Creamy-coffee/dual-channel-modulation-analyzer/README.md

# 双通道信号采集与调制分析仪

仪器由两块芯片组成：Artix-7 FPGA 负责双通道 12 位 65 MSPS 同步采集和全部信号处理，RK3506 跑 Linux，用 LVGL 驱动 7 英寸触摸屏。FPGA RTL、屏端源码、串口协议和验证记录都在本仓库。

> 2026 全国大学生嵌入式芯片与系统设计竞赛 · FPGA 创新设计赛道 · AMD 自主选题

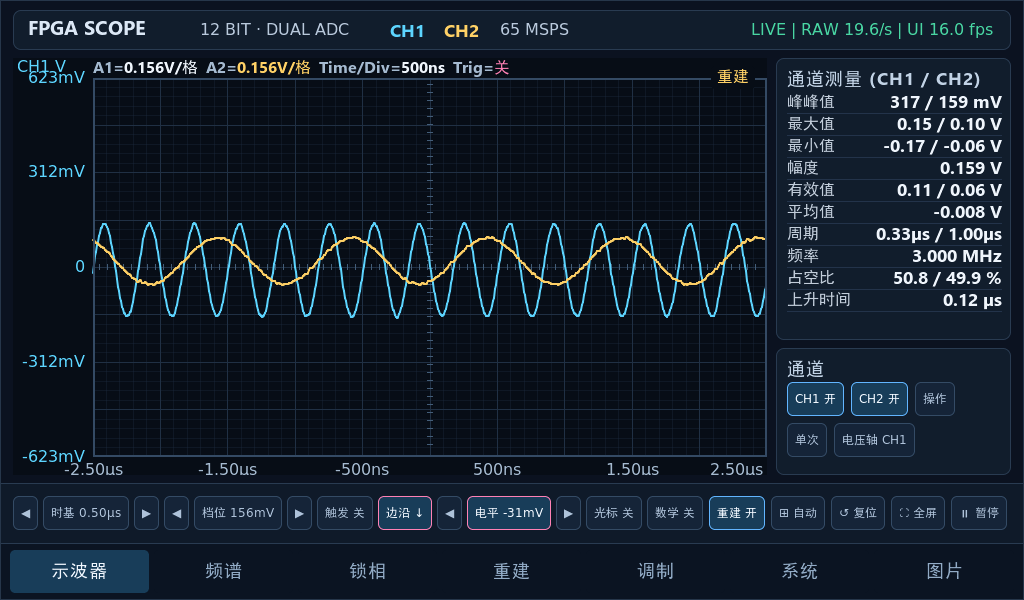
[picture p1: docs/screenshots/01-scope-dual.png]
示波器页：双通道交叉接线，3 MHz 接 CH1、1 MHz 接 CH2，同一时间轴


## 系统组成

信号链是固定的：双通道 12 位 65 MSPS 同步采样 → 多速率抽取 → 4096 点共享 FFT → DDC → 片上频率捕获与锁相 → H1–H5 谐波功率 → CRC32 成帧，全部在 XC7A35T 内完成。屏端把这套结果画成七页界面，并在调制页做 AM 调制度估计和 OOK / 2FSK / BPSK 的符号判决。

界面上的读数总跟有效状态一起给出：锁相页没有激励时显示「—」并置「相位变化超限」，调制页判决没完成时标「待判决」，不留上一帧的数字。

## 七页界面

| 页面 | 内容 |
|---|---|
| 示波器 | 双通道时域波形：时基 / 档位 / 边沿触发 / 单次；通道测量峰峰值、最大值、最小值、有效值、平均值、周期、频率、占空比、上升时间 |
| 频谱 | FPGA SPEC 帧（4096 点共享 FFT，固定 Hann 窗）+ 屏端 RAW 1024 点谱（Hann / Blackman / FlatTop 可切）；中心频率、峰值电平、底噪、Δf、H1–H5 与 THD 2–5 |
| 锁相 | 片上锁相：I/Q 相位矢量与双通道波形同屏；参考频率、幅度、相位差、锁定状态 |
| 重建 | 原始样点 vs 带限插值重建，同一时间窗上下对齐；按波形类型决定是否重建 |
| 调制 | DDC + 包络 / 频偏 / I-Q：AM 调制度、OOK 与 2FSK 的 bit 判决、BPSK 符号跟踪与 I/Q 观测、QPSK 仅 I/Q 观测 |
| 系统 | 渲染帧率、链路吞吐、丢包与 CRC 统计等板载实测值 |
| 图片 | V32IMG1! 载荷：OOK / 2FSK / BPSK 解出的符号 → 曼彻斯特解码 → 分包 CRC32 → 整图 CRC32，全部通过才显示画面；整图链路以合成回环与 ADB 逐像素核验，真实载波下的独立抓包验收未做 |

> 七页屏端程序源码就在本仓库 `src/`。构建额外依赖 `third_party/liquid-dsp-1.7.0.tar.gz`（BPSK 符号跟踪用），配置时校验 SHA 后离线解包，不联网取依赖。版本、bit 哈希与提交号的对应见 [docs/VERSION.md](docs/VERSION.md)。

## FPGA 侧

目标器件 XC7A35T FGG484-2（Artix-7 35T），Vivado 2018.3 综合实现。FFT、DDC、锁相与谐波计算均以本仓库 RTL 实现，未例化厂商 FFT IP；时钟与 I/O 使用器件原语（MMCM、BUFG 等）。系统时钟 65 MHz（50 MHz 板载晶振经 MMCM ×39 ÷2 ÷15 生成；另一路 300° 相移作 ADC 前传时钟，对应 65 MSPS）。

| 能力 | 怎么做的 | 源码 |
|---|---|---|
| 双通道 12 位 65 MSPS 同步采集 | AD9238 两路在同一采样沿锁存，偏移二进制转二补码；两通道同一帧，不分时切换 | `fpga/rtl/ad9238_capture.v` |
| 4096 点共享 FFT | 时分复用 radix-2 DIT 蝶形，每级右移 1 位（总归一化 1/N）；多通道串行复用同一套旋转因子表，只搜 1…N/2；旋转因子为预生成表 `twiddle_4096.mem` | `fpga/rtl/fft_frame_4ch.v`、`fpga/rtl/twiddle_4096.mem` |
| 多速率抽取前端 | CIC + 可换系数 FIR（wide / narrow 多套 `.mem`），按信号稳定性自动换档 | `fpga/rtl/multirate_fft_frontend.v`、`fpga/rtl/meas_bw_ctrl.v` |
| DDC 数字下变频 | NCO 混频（Q15 sin/cos 表）+ CIC / FIR 抽取，AM、2FSK、BPSK、OOK 的基带都从这里出 | `fpga/rtl/ddc_nco_mixer.v`、`fpga/rtl/ddc_cic_decimator.v`、`fpga/rtl/ddc_fir_decimator.v` |
| 片上频率捕获 + 锁相 | 「FFT 粗估 → 精扫 → 锁定」三段式，一份 bitstream 扫完 ~200 Hz…32.4 MHz（搜索范围，边界未做标定），换载频不用重编 | `fpga/rtl/freq_scan_ctrl.v`、`fpga/rtl/local_afc_2ch.v`、`fpga/rtl/lockin_core_2ch.v` |
| 谐波与 THD | H1–H5 功率存表、log2 表转 dB、64 位整数开方算 THD 2–5 | `fpga/rtl/harmonic_power_store.v`、`fpga/rtl/isqrt_u64.v` |
| 成帧与链路 | 多路帧并行仲裁 + AB5 时序 + 逐帧 CRC32，2 Mbaud 8N1 发出 | `fpga/rtl/parallel_frame_arbiter.v`、`fpga/rtl/ab5_frame_sequencer.v`、`fpga/rtl/v32cap3_tx.v` |

资源与时序（`fpga/build_evidence/` 是原机报告，实现 ID `a222905e`，Routed 状态）

| 资源 | 占用 |
|---|---|
| Total LUTs | 20294（Logic 20238 + LUTRAM 56） |
| 触发器 | 13111 |
| DSP48 | 80（蝶形、混频、CIC 累加） |
| Block RAM | 32×RAMB36 + 8×RAMB18，36 块等效（样点缓存、旋转因子、系数表、波形 LUT） |
| 时序 | WNS +0.172 ns、WHS +0.010 ns，无 setup / hold 违例 |

构建：`fpga/build.tcl` 提供完整构建脚本（Vivado 批处理建工程 → 综合 → 实现 → 出 bit）。
2026-11-02 已在仓库外的独立副本上用同一套 Vivado 2018.3 跑通全流程：WNS +0.172 ns / WHS +0.010 ns
（0 个失败端点）、20294 LUT / 13111 FF / 80 DSP / 36 BRAM、DRC 138 条全为 Warning 无 Error，
与 `fpga/build_evidence/` 逐项一致。bit 的 SHA256 不会相同——Vivado 把构建时间写进 bit 头，
一致性应按 USR_ACCESS + 时序/资源 + 上板功能判定。过程见
[build-verify-20261102.md](docs/build-verify-20261102.md)。

## 调制制式与判决

各制式在屏上的显示能力和判决能力不一样，分开列：

| 制式 | 屏端显示 | 符号 / bit 判决 | 实机验证 |
|---|---|---|---|
| AM | 包络 + 调制度（正弦拟合） | 不适用（模拟调制） | 2 MHz 载波、1 kHz 调制、深度 50 % → 屏上 50.0 % |
| FM / PM | 相位差换算频偏 / 相位 | 不适用（模拟调制） | 未单独做实机记录 |
| OOK | 包络（Q8 模长） | ● 已实现：10/90 分位学高低电平，40 %／60 % 滞回定边沿，符号中心积分判 1/0；不确定记 `?`，不强制猜 bit | 1 MHz 载波、1000 Bd、曼彻斯特、256×128 图像包流 |
| 2FSK | 相位差换算频偏 | ● 已实现：与 OOK 共用定时与滞回核心，低频 = 0、高频 = 1（频偏正负本身不能判 bit） | 1 MHz 载波、1000 Bd、相对频偏 1525.0 Hz |
| BPSK | 原始 I/Q 轨迹；可选恢复符号点（`SYM` / `RAW IQ` 切换，未获资格时清图，不拿原始散点冒充星座） | ● 已实现：Hann 窗 M 次方 4096 点 FFT 估粗 CFO → `msresamp` 重采样到 4Rs → `symtrack` 做 AGC / 符号定时 / 载波跟踪 / 均衡 → 判决；可选 PN7 参考检查 | 实机 PN7 闭环（2026-10-27）：372 帧 CRC 全对、5747 bit、训练后 5460 次检查 0 错、GUI 24.2463 s 合格片段末次 24702 次检查零错、EVM 0.0260–0.0481；更早一次 `11-mod-bpsk.png` 是 EVM 0.060 待判决，属未获符号同步的失败运行 |
| QPSK | 仅 I/Q 观测 | ○ 未实现：屏端只暴露 I/Q 观测，主机侧符号恢复未移植过来 | 无屏端记录 |

几点说明：

1. 判决都在已知符号率下进行：屏上人工选 100 / 250 / 500 / 1000 / 2000 Bd，没有自动制式识别，也没有自动码率估计。
2. `?` 是不确定，不是 0 或 1：弱信噪比、缺帧、无效样点都记为 `?`。含 `?` 的记录不能当完整连续码流，也不能用来算 BER。
3. EVM 是获取资格判据，不是通信标准 EVM 仪表：它只用来判断「这 64 个符号够不够格报同步」，没有按任何标准校准。PN7 检查也不是 BER，需要源端确实发 PN7 才有意义。

## 性能与速率

采样率、链路帧率和绘制帧率是三个不同的量：

| 项目 | 数值 | 条件 / 来源 |
|---|---|---|
| ADC 采样率 | 65 MSPS × 2 通道，12 位，同一采样沿 | 硬件（AD9238 + FPGA 采集） |
| 有效采样率（抽取后） | 65 MSPS ÷ decimation，dec 取 1…32768 的 2 的幂 | 接收端支持范围，见"已知边界" |
| 串口链路 | 2 Mbaud 8N1，RAW 帧 4140 B / SPEC 帧 2096 B，逐帧 CRC32 | 协议 |
| 接收帧率 | 屏上实测约 19.6 帧/s（RAW 页面右上角 `LIVE RAW 19.6/s`） | 发布版本，2 Mbaud |
| 面板刷新 | 1024×600 @ 49 Hz | DRM 模式（PREFERRED） |
| 绘制帧率 | 约 9.9 FPS（六页版本，1024 点折线 × 2 通道） | 早期版本实测，七页版本未复测 |

65 MSPS 是 ADC 的采样率，不是送到 Linux 的样点速率。串口按帧发送：RAW 波形帧（1024 点，4140 B）、
SPEC 频谱帧（2096 B）、MEAS 测量帧（128 B）、ANA 调制帧（1076 B）、DDC 参数帧（72 B），
每帧独立 CRC32；两帧之间的样点不上传，所以"接收帧率 19.6 帧/s"与"采样率 65 MSPS"不是一回事。

## 验证与证据

每条结论后面记了输入条件、结果，以及这个结论能覆盖到哪一步。

| 证据 | 输入条件 | 结果 | 结论范围 |
|---|---|---|---|
| `01-scope-dual.png` | 发生器 CH1 3 MHz/300 mVpp → 分析仪 CH1；CH2 1 MHz/150 mVpp → CH2；500 ns/div | 峰峰值 317 / 159 mV，频率 3.000 / 1.000 MHz | 双通道同帧采集与通道测量可用；不含幅值精度标定 |
| `02-scope-2mhz.png` | 2.000 MHz / 200 mVpp 正弦 | CH2 峰值 212 mV | 单通道实时响应 |
| `03/04/05-fft-*.png` | 2.000 MHz / 200 mVpp；RAW 1024 点；分别 Hann / Blackman / FlatTop | 峰值 −33.9 / −33.9 / −33.8 dBFS，底噪 −91.8 / −91.2 / −86.5 dBFS | 窗函数切换与峰值一致性（极差 0.1 dB）；不是绝对幅度校准 |
| `06-fft-harmonic.png` | 2 MHz 方波 / 200 mVpp，HARM ON | 峰值 −31.8 dBFS，THD 2–5 = 38.441 % | 相对功率统计；未做失真溯源校准 |
| `07-lock.png` / `08-lock-open.png` | CH1/CH2 同接 2 MHz 正弦，发生器相位差 45° | −45.15°、锁定；关掉一路后数值转「—」、状态「相位变化超限」 | 相位差测量与失效提示有效；不含绝对相位标定 |
| `09-mod-am.png` | 2 MHz 载波、1 kHz 调制、深度 50 % | 调制度 50.0 %，包络峰峰 12 码 | 调制度估计（正弦拟合）在指定条件下成立 |
| `10-mod-2fsk.png` / `12-mod-ook.png` | 1 MHz 载波、1000 Bd | 2FSK 频偏 1525.0 Hz、bit 同步；OOK bit 同步、bits 序列 | 指定码率下的符号同步；未做全码率 / 全信噪比统计 |
| `11-mod-bpsk.png` | 1 MHz 载波、1000 Bd，人工指定 Rs | EVM 0.060、CFO +132 Hz，状态「待判决」 | 早期一次运行：观测量与获取资格判据有效，但该次未获符号同步，不能当作判决成功（后续已闭环，见下一行） |
| BPSK 实机闭环（2026-10-27） | 发生器 CH2 → ADC CH0 → 屏端 CH1；1 MHz 载波、1000 bit/s、PN7、0°/180° | 372 个 ANA 帧 CRC 全对、帧号 10665–11036 连续、覆盖 6.001 s；ARM 导出 5747 bit；训练后 5460 次检查 0 错；GUI 独立审计 24.2463 s 合格片段、末次 24702 次参考检查零错零擦除；EVM 0.0260–0.0481 | 指定码率下的实机判决闭环；不是通用 BER、协议帧同步或绝对极性；180° 极性歧义需外部参考 |
| [bpsk-bit-decoder-20261026.md](docs/bpsk-bit-decoder-20261026.md) 的离线用例 | 合成基带，两种相位极性、80 Hz 载波偏差 | 符号恢复与 PN7 检查通过 | 解码链路在本机软件成立；合成基带不等于发生器→ADC→屏幕实机链路 |
| [image-receiver-20261027.md](docs/image-receiver-20261027.md) 本机软件验证 | OOK / 2FSK / BPSK 生产 DSP → 曼彻斯特 → 包 CRC → 图块 → 整图 CRC | 全链通过 | 协议与解码链正确；尚无语发器→ADC→屏幕的整机图片传输记录 |
| `fpga/tests/` RTL 仿真 | tb_adc_parallel、local_afc_2ch、meas_bw_ctrl、fft_frame_4ch 等 | Vivado 时序波形 | 数字逻辑功能正确性；不含模拟前端与板级噪声 |
| `fpga/build_evidence/*.rpt` | 实现 `a222905e` | 20294 LUT / 80 DSP / WNS +0.172 ns | 该次实现的资源与时序；换代码或换工具版本需重测 |
| [build-verify-20261102.md](docs/build-verify-20261102.md) 屏端重建 | 仓库外独立副本；LVGL 9.1.0 + liquid-dsp 1.7.0（SHA256 与 `third_party/liquid.cmake` 一致）| LVGL 284 / 应用 21 个源文件全部编译通过，链接得到 `ELF32 ARM v7-A VFPv4 hard-float`，2,258,844 B；5 个命令行工具同样构建成功 | 源码自洽可编译；编译器是 GCC 7.3.1，不是正式工具链，且未上板 |
| 主机自测（同一份源码）| `test_bpsk_decoder` / `test_ook_decoder` / `test_fsk_decoder` / `test_fft_windows` / `test_fft` | 全部 PASS：BPSK 12 例各恢复 3778–3780 bit、PN7 全锁、`errors=0`、EVM 0.0277–0.0338 | 算法与解码链在软件层成立；合成基带不等于实机链路 |

每帧 CRC32 通过只说明这一帧完整到达，不说明幅度、相位或调制度准确，所以最后一列单独写了结论范围。

## 快速开始

### 交叉编译（Linux 主机，ARMv7 hard-float）

```bash
# 依赖：cmake、ARM 交叉工具链、同级目录下的 LVGL 源码
export SDK_TOOLCHAIN_ROOT=/path/to/gcc-arm-10.3-2021.07-x86_64-arm-none-linux-gnueabihf
./build.sh            # 增量编译
CLEAN=1 ./build.sh    # 全量重编
```

`build.sh` 用 `toolchain.cmake` 交叉编译。工具链根目录从 `SDK_TOOLCHAIN_ROOT` 环境变量取（或 `cmake -DTC_ROOT=`），仓库里不写死任何人的本机路径；LVGL 目录可用 `LVGL_DIR=` 覆盖（默认 `../lvgl-release-v9.1`）。
BPSK 解码链另需 `third_party/liquid-dsp-1.7.0.tar.gz`：`third_party/liquid.cmake` 在配置阶段校验 SHA256 后离线解包并静态链接，不从网络取依赖。除 GUI 外还会构建 `bpsk_capture_decode`、`test_bpsk_decoder`、`test_raw_capture` 三个命令行工具（离线回放与自测用）。

### 部署到板子

```bash
./deploy.sh                 # 通过 adb 推送并运行

export BOARD_HOST=192.168.1.10 BOARD_USER=root BOARD_PASS=你的口令
./deploy_net.sh             # 或走网络：推送 → 校验 md5 → 一致后才覆盖 → 重启
```

地址、账号、口令请按你们自己的板子环境配置。`deploy_net.sh` 与 `tools/board_shot.py`
从 `BOARD_HOST` / `BOARD_USER` / `BOARD_PASS` 环境变量读取，仓库不记录任何默认口令；
未设置时会直接报错退出，不会悄悄用空口令去连。

### 运行

```bash
waveform_demo --source uart          # 真实串口数据（默认 2 Mbaud 8N1）
waveform_demo --source demo          # 无板子时用合成信号看界面
```

## 已知边界

### 使用条件

- 板端需 root 运行（读 `/dev/input/event0` 注入触摸、直接写 DRM）。
- 单 connector / 单屏；官方 `lv_demo` 必须先停，否则会抢 DRM 与输入设备。
- 中文字体是界面字符的子集，改文案需重跑 `tools/gen_v32_fonts.py`，否则新字是方块。

### 测量边界

- 未做精密幅相与失真校准：H1–H5、THD 只在指定输入下做过功能测试，不是可溯源的失真测量。
- 串口带宽是硬约束：2 Mbaud 下每帧 RAW 4140 B / SPEC 2096 B，帧率由帧长决定；提高帧率要减帧长或提速。
- 抽取换时间窗，代价是带宽：有效采样率 = 65 MSPS ÷ decimation，奈奎斯特随之下降到 65 MHz ÷ (2·dec)。接收端接受 1…32768 的 2 的幂，但能接受不等于板上验证过——深抽取档目前只为 AM 包络用过，低频极限未系统标定。
- 帧与帧不连续：相邻两帧 `start_idx` 实测相差约 1.17×10⁷ 个样点（一帧才 4096），两帧之间丢掉了约 99.96 % 的采样，不能拼接。
- 带限重建不消除混叠：只对带限信号成立；超过 32.5 MHz 的成分已经折叠进带内，插值无法还原；窗口边缘前后各 64 个样点没有完整支撑，自动退回线性插值。对非带限波形（方波 / 三角 / 锯齿）重建时必须钳位，钳位会改变波形形状。

## 版本与复现

`main` 上同时有 FPGA 源码与屏端源码，但两者不是"一次提交全部对齐"：实现 ID、bit 哈希、屏端程序所在分支与提交、工具版本、已知差异，全部记在 [docs/VERSION.md](docs/VERSION.md)。提交参赛材料时以该文件为准。

## 团队成员

| GitHub | 主要负责 |
|---|---|
| [@Creamy-coffee](https://github.com/Creamy-coffee) | RK3506 板端应用：DRM/KMS 渲染、触摸输入、串口链路接收与带限重建 |
| [@YiHuan15](https://github.com/YiHuan15) | FPGA RTL 与数字信号处理：双通道采集、FFT、锁相、谐波分析 |

## 文档索引

| 文档 | 内容 |
|---|---|
| [docs/VERSION.md](docs/VERSION.md) | 参赛版本清单：实现 ID、bit 哈希、屏端程序、工具版本、已知差异 |
| [docs/build-verify-20261102.md](docs/build-verify-20261102.md) | 干净环境重建验收：环境、命令、屏端产物、FPGA 时序/资源/DRC 对比、未覆盖项 |
| [docs/DEVELOPMENT.md](docs/DEVELOPMENT.md) | 开发记录：无 framebuffer 怎么点屏、触摸与协议细节、参数调整、排错工具 |
| [fpga/README.md](fpga/README.md) | FPGA 工程结构、构建方法、接口与边界 |
| [docs/V32CAP3_FPGA_TX_SPEC.md](docs/V32CAP3_FPGA_TX_SPEC.md) | 上位机协议与帧格式 |
| [docs/ook-bit-decoder-20261026.md](docs/ook-bit-decoder-20261026.md) / [fsk](docs/fsk-bit-decoder-20261026.md) / [bpsk](docs/bpsk-bit-decoder-20261026.md) | 三种制式的判决算法、参数、适用条件与不可宣称的结论 |
| [docs/bpsk-acquisition-capture-20261027.md](docs/bpsk-acquisition-capture-20261027.md) | BPSK 真实采集回放与获取判据 |
| [docs/image-receiver-20261027.md](docs/image-receiver-20261027.md) | V32IMG1! 载荷协议、分包与整图 CRC 验收流程 |
| [docs/spectrum-resolution-20261029.md](docs/spectrum-resolution-20261029.md) / [geometry](docs/spectrum-geometry-20261029.md) / [harmonic-confidence](docs/harmonic-confidence-20261029.md) | 频谱分辨率、几何与谐波置信度的核对记录 |
| [docs/screenshots/](docs/screenshots/) | 13 张发布版本实屏截图（1024×600） |

## 许可证

项目自身代码采用 GNU GPL v3.0（GPL-3.0-only），详见 [LICENSE](LICENSE) 与 [许可范围说明](LICENSING.md)。

第三方组件：LVGL v9.1（MIT，需自行获取源码，仓库不分发）；Xilinx Vivado 2018.3 为厂商工具，不随仓库分发。其余第三方归属见 `LICENSING.md`。
