Creamy-coffee/dual-channel-modulation-analyzer/docs/llm-assisted-optimization-log.md

> **文档性质**：本文是 2026-10-19 ～ 10-31 期间的阶段记录，描述当时的分支（含 8192 点 XFFT 链路、
> AI_V32 构建、低速 CNN 实验等）。当前仓库的发布版本是七页屏端 + 4096 点共享 FFT 那条路径，
> 两者**不是同一条实现线**；版本对应关系以 [VERSION.md](VERSION.md) 为准，本文不作为当前能力声明。
>
> 文中指向证据文档的路径已改为「私有证据 / 私有记录」形式——那些文件未随本仓库分发。

---

# LLM 辅助优化记录（2026-10-27补充；保留历史修订）

> 阅读提示：前部表格为10月19日历史状态；10月23日补充见第七节，10月27日最新补充及验证边界见第八节。

赛事：全国大学生嵌入式芯片与系统设计竞赛 · FPGA创新设计赛道（赛事名称沿用初稿，正式要求以主办方通知为准）。

项目：基于XC7A35T-FGG484-2与AD9238的双通道信号分析仪；每路12位、65MSPS并行SDR采样，分支包含FFT、时域测量、全速数字锁相、低速共享CNN实验及波形/状态通信。

工具链：Vivado 2018.3、Verilog/SystemVerilog验证、Xilinx XFFT IP、Python；新增Linux显示与通信交接方案。

修订说明：最初稿停留在2026-10-10；本轮编辑期间原文件另有#35～#44等并发补充，已全部保留并合并。本次保留前序#1～#44，新增#45～#64以及现状、资源口径、证据和待办。写入前已完整备份最新输入。早期Prompt为还原要点，新增Prompt为工程复盘归纳，均不冒充原始聊天逐字记录。

验证口径：分别标识数学分析、RTL仿真、综合/实现、原始采样回读、用户板卡阶段实验、Linux离线原型及未来规划。本次只做文档修订与证据核对，未重跑训练、仿真、综合、硬件或Linux屏幕测试。

## 修订后的项目状态速览

| 组成 | 已有证据 | 仍未完成或不能宣称 |
|---|---|---|
| 双路ADC | 每路65MSPS采集逻辑、码型/OTR/复位仿真、已保存RAW现场数据 | ADC输入电气裕量、模拟抗混叠、连接器电压及两路频响完整校准 |
| FFT/测量 | 8192点XFFT链路及算术修复；4096/8192子系统对照、另有4096 finder候选 | 整带宽未知弱信号可靠捕获、1Hz绝对精度与完整THD认证 |
| 基础锁相/AFC | 30MHz附近局部跟踪、源设置20mVpp、恢复及±1kHz回程阶段板测 | 非绝对幅相精度；约0.9～1°幅度相关相移待定位；整带宽候选另验 |
| CNN | 双路共享低速推理、R256、256输入/232有效点、功能/吞吐验证及多轮合成训练 | 质量未全面通过；模型资格0、AUTO为RAW；无全速宽带AI认证 |
| AI_V32构建 | 10/18源码迁移后时序回归已修复；10/19增加独立V32CAP3口并出bit | 工程能出bit不等于模拟/板级整机认证，新口Linux接收尚需实机验证 |
| 通信 | 历史SPI审计；V32CAP3真实归档50帧核对；AB5二进制/AB6文本独立口候选 | SPI RAW4096扩展尚未实现；UART无双向参数命令，不能连续上传65MSPS |
| Linux/屏幕 | 真实RAW快照离线HTML原型、串口解析参考和SPI设计草案 | 最新交接为RK3506/UART，早期方案为RK3568/MIPI；板卡/屏驱动及实时部署未验收 |
| 自动搜索/ET | 有独立候选、仿真与构建记录，新增完整性审查正在形成 | 200Hz～32.4MHz是设计目标；ET覆盖/相位标签及板测未完整闭环 |

**当前可据证据表述：已形成数字采集—测量—原始数据导出的分层实现，并在基础候选上获得30MHz局部弱信号跟踪的阶段板测；AI质量、绝对校准和Linux整机屏显仍有明确未完成项。**

## 一、前序闭环记录（#1～#44，含本轮检测到的并发补充）

以下保留当时的问题与回答，不把其中的估算、旧规格或“综合通过”提升为今天的系统验收。关键错误已就地加注；后续状态以第二部分及来源索引为准。#6与#18为同类除法器依赖事件的两次历史归纳，保留编号但不重复计算为两个独立优化成果。前序#35～#44与新补充部分有交叉，保留其错误判断与纠正细节，同一事件不重复计为独立成果。

### 记录 #1　isqrt_u64 端口名错误导致综合失败
- 日期/阶段：2026-10-07 · THD 模块重构
- 问题：THD 分析器引入 64bit 整数开方（isqrt_u64，32 拍恢复开方）后，综合报 6× Synth 8-448: named port connection 'value'/'valid' does not exist for instance 'u_isqrt'，RTL Elaboration 失败。原因是例化时把端口写成 .value()/.valid()，而模块实际端口为 radicand/result/busy/done。
- Prompt（还原要点）："THD 模块综合报 named port connection 'value' does not exist for instance 'u_isqrt'，isqrt_u64 的端口名是什么？怎么改？"
- 模型回答（要点）：指出 isqrt_u64 实际端口为 clk/rst_n/start/radicand[63:0]/result[31:0]/busy/done，例化应为 .radicand(sqrt_input) / .done(sqrt_valid)；并提示此类错误属于端口名笔误，应先在模块定义处核对端口清单再例化。
- 验证：改后重跑综合，thd_analyzer 模块 0 Errors 通过（12:01 综合日志）。
- 纠错点：例化 IP/自研模块前先核对端口名；综合报 "named port connection does not exist" 时不要怀疑语法，直接查目标模块端口定义。
### 记录 #2　插值频率位宽缺陷（14bit 左移归零 + 32bit 乘法溢出）
- 日期/阶段：2026-10-07 · FFT 频率插值
- 问题：三点插值频率公式 (($signed({1'b0,final_bin_hold})<<<16)+delta_q16)*ADC_FS_HZ>>>... 中，14bit 左操作数做 <<<16 后结果仍是 14bit（高位被截断归零），且后续 32bit 乘法溢出，导致 interp_freq_packed 输出垃圾值——会拖垮 UI 频率显示、自动测试判频和锁相 FCW 三个下游模块。
- Prompt（还原要点）："插值频率算出来是错的，怀疑是位宽问题：bin<<16 之后乘 Fs 会溢出，怎么改成正确的定点链？"
- 模型回答（要点）：给出固定位宽链：① bin_q16 = k*65536 + delta 用 32bit 有符号；② 符号扩展为 64bit（{{32{interp_bin_q16[31]}}, interp_bin_q16}）；③ freq_product = interp_ext * ADC_FS_HZ_64（64×64）；④ freq_result = freq_product >>> (16+LOG2_N+DECIM_LOG2)（算术右移 29）；⑤ 取 [31:0]。并强调 delta 用组合限幅值而非寄存器值，避免使用上一拍陈旧数据。
- 验证：数学复核成立：(k+δ)×Fs/2^LOG2_N，8192 点下最大频率 32.5MHz 不溢出；新版综合通过，代码注释标注 "V6: properly sign-extended interpolation result"。
- 纠错点：Verilog 中 <<< 不自动扩位——移位前先按最终位宽符号扩展；定点乘法先算好最大动态范围再定位宽，避免 32bit 溢出被静默截断。
### 记录 #3　THD 组合除法 + 全展开开方导致面积爆炸（place 失败）
- 日期/阶段：2026-10-06 · THD 模块
- 问题：THD 用组合逻辑 64bit 除法 + 全展开 64bit 开方，综合后 THD 模块约 15883 LUT，Place 失败。
- Prompt（还原要点）："THD 模块面积 15883 LUT 太大，place 过不了，怎么降面积？"
- 模型回答（要点）：组合除法/开方在 FPGA 上面积巨大，改为多周期迭代方案：恢复除法 64 拍（thd_divider_64，共享）+ 恢复开方 32 拍（isqrt_u64），用状态机（ST_DIV → ST_SQRT → ST_DONE）串行计算；FFT 一帧周期约 126μs，参数计算完全不必单周期完成，多周期对吞吐无影响。
- 验证：旧版副本工程重写后 synth → impl → write_bitstream 全部通过；整体 LUT 15000/20800（含 FFT 等全部逻辑）；新版 v6.1 继续沿用该方案，综合 0 Errors。
- 纠错点：FPGA 上"一个周期算完除法/开方"是面积杀手；凡一帧才更新一次的参数计算都应改为多周期状态机 + 共享运算单元。
### 记录 #4　THD 近似开方方案数值不可信（leading-one 近似不成立）
- 日期/阶段：2026-10-07 · THD 模块
- 问题：早期 THD 用 leading-one 位近似计算 psum/p1 的平方根比例，抽查发现数学不成立：shift=3 时结果为 0（真值 16）、shift=4 时结果为 64（真值 16）、shift=7 时结果为 1（真值 2）——仅 psum 最高位恰好为 27 时碰巧正确，数值不可信。
- Prompt（还原要点）："THD 用 leading-one 近似算出来的比值是错的（给了几个反例），这个近似能不能成立？"
- 模型回答（要点）：承认近似不成立，改回精确公式 THD_x100 = sqrt(psum * 1e8 / p1)（(10000)²=1e8 的缩放技巧）：64/64 多周期除法得 psum×1e8/p1，再经 32 拍 isqrt 开方；量纲验证：失真 100% 时输出 10000，正常信号 <1000。
- 验证：v6.1 公式与位宽推导写入头部注释（36×27=63bit 乘积不溢出 64bit 除法）；综合通过。
- 纠错点：数值算法上线前必须用边界反例验证（0/64/大数）；近似公式要给出误差界，给不出就换精确实现——"碰巧正确"和"数学正确"要分清。
### 记录 #5　THD 四项边界保护（谐波越界 / DC / 除零 / ±1 bin）
- 日期/阶段：2026-10-06 · THD 模块
- 问题：THD 谐波累积存在越界与除零风险：基波太靠近 Nyquist 时第 5 次谐波 5k±1 超出 FFT 半谱范围仍会访问；基波为 DC（bin≤1）或基波功率为 0 时公式无意义。
- Prompt（还原要点）："THD 上线前要加哪些边界保护？谐波越界、DC、除零分别怎么挡？"
- 模型回答（要点）：给出四项保护：① fund_bin*5+1 <= HALF_N（5 次谐波越界 → THD invalid）；② fund_bin >= 2（排除 DC）；③ 基波功率 p1 != 0（防除零）；④ 谐波窗口 spectrum_bin+1 >= k && spectrum_bin <= k+1（3-bin 窗且 k 越界时不访问）；无效通道输出 0xFFFF 哨兵。
- 验证：四项条件保留至 v6.1（ok_hold 逻辑），综合通过；0xFFFF 哨兵被 auto_tester 的 thd_ok 正确判失败。
- 纠错点：频谱算法上线前先枚举索引越界/除零/空输入三类故障；用哨兵值（0xFFFF）统一表达"无效"，下游判 valid 而非判数值。
### 记录 #6　fixed_divider 依赖旧 FFT 文件导致模块 not found
- 日期/阶段：2026-10-07 · 数字锁相
- 问题：工程重构时把旧自研 FFT（fft_frame_4ch.v）从综合范围排除（UsedIn=simulation），但 digital_lock_in 的 FCW 除法器仍例化其中的 fixed_divider，综合报 Synth 8-439: module 'fixed_divider' not found。
- Prompt（还原要点）："digital_lock_in 报 fixed_divider not found，但它明明定义在 fft_frame_4ch.v 里？"
- 模型回答（要点）：定位根因：fft_frame_4ch.v 已被排除出综合（.xpr 里 UsedIn=simulation），其内部模块对综合不可见；解法是把除法器抽成独立文件 fixed_divider_generic.v（并补除零保护：denominator==0 输出全 1 + valid），THD/插值/锁相统一复用，不依赖旧文件。
- 验证：独立文件加入工程后综合通过；14:32 write_bitstream 成功出位流。
- 纠错点：公共模块（除法器/计数器）必须独立成文件，不要寄生在"即将淘汰"的模块里；从工程排除旧文件前先 grep 谁还在引用它。
### 记录 #7　headless 顶层 IOB 超用（609/250 = 243%）
- 日期/阶段：2026-10-07 · 顶层架构
- 问题：早期 headless 顶层把内部显示总线（ui_numbers 406bit、spec_pair 66bit、wave_samples 48bit 等）全部暴露为端口，无引脚约束时全部计入 IOB，达 609/250=243.6%，实现必然失败。
- Prompt（还原要点）："综合过了但 IOB 609 超用 243%，怎么让内部总线不占引脚？"
- 模型回答（要点）：物理顶层（daq_top）只保留真实板级 I/O（clk/adc/digital/key/sw/uart/led），内部总线全部收进 daq_display_core；用自由运行扫描计数器（512×512 + frame_boundary）驱动 CDC mailbox 占位读接口，未来 MIPI renderer 再替换。
- 验证：新版综合 IOB 24/250=9.6%，实现通过，14:32 出位流。
- 纠错点：区分"物理端口"与"内部数据总线"；凡是将来由显示/协议后端消费的总线一律不进顶层端口，用内部握手或 mailbox 传递。
### 记录 #8　相位差：双通道各找峰值导致 bin 错位
- 日期/阶段：2026-10-07 · 相位测量
- 问题：双通道各自独立找 peak bin 时，噪声可能让 CH0 peak=126、CH1 peak=127，此时两通道在不同频率点取相位，相位差无意义。
- Prompt（还原要点）："两通道各找各的峰值，噪声下 bin 错一位相位差就不对了，怎么处理？"
- 模型回答（要点）：改用公共基波 bin：以 CH0 峰值 bin 为公共 fundamental bin，CH1 在同一个 k 上读取复数（ref_ch1_re/im），双通道同频点 atan2 求差；并补 ±180000 mdeg 归一化（>+180° → -360°、<-180° → +360°，33bit 中间量防溢出）；V7 再加 low-signal 有效性门控（相位功率低于噪声底时 invalid）。
- 验证：xfft_frame_2ch 增加 is_ref_bin 捕获逻辑；phase_measurement 输出经 wrap 后 ∈[-180000,+180000]；综合通过。
- 纠错点：相位测量必须在同一频率点比较；先对齐 bin，再谈相位；测量类算法要配"信号太弱时输出无效"的门控，而不是硬给数值。
### 记录 #9　插值 δ 无限幅导致无意义频率
- 日期/阶段：2026-10-07 · 频率插值
- 问题：三点插值公式 δ=0.5·(Pk-1-Pk+1)/(Pk-1-2Pk+Pk+1) 在异常谱线下可能得到 δ=3.7 这类越界值，导致频率结果无意义。
- Prompt（还原要点）："插值 δ 异常大怎么办？要不要限幅？"
- 模型回答（要点）：对 δ 做 ±0.5 bin 限幅：Q16 定点下 delta_clamped 限制在 ±32768（±0.5）；同时除法器对负数做了符号处理（分子/分母取绝对值 + 符号位恢复），限幅用组合逻辑直接由除法结果算出，避免陈旧寄存器。
- 验证：V6 插值链中 delta_clamped 生效，freq_result 输出稳定；综合通过。
- 纠错点：抛物线插值的前提是"峰值确实在邻域内"；越界 δ 直接说明峰值搜索或谱线异常，限幅是兜底不是掩盖——还要同时看峰值搜索是否可靠。
### 记录 #10　自动测试阈值硬编码 → 寄存器化
- 日期/阶段：2026-10-07 · 自动测试
- 问题：早期自动测试用 if (thd < 500) pass=1 式硬编码阈值，改一次指标就要重新综合。
- Prompt（还原要点）："自动测试的阈值能不能不写死？以后用按键/UART 改。"
- 模型回答（要点）：阈值全部改为输入端口：freq_min/max_hz、vpp_min/max、thd_max_x100、phase_min/max_mdeg；ok 判定组合化后打拍（连续评估 + 锁存），update 脉冲采样最新测量结果；顶层以参数默认值接线。
- 验证：auto_tester 阈值端口化，daq_top 以 32'd100~32'd30000000 等常量例化；综合通过。
- 纠错点：测试判定逻辑与阈值解耦——阈值是"配置"不是"代码"；未来 UART/按键改阈值不需重综合，答辩时可以直接演示在线改判据。
### 记录 #11　HDMI 时钟域时序违例 → headless 去 HDMI 域（WNS 对比）
- 日期/阶段：2026-10-06 → 10-07 · 架构迭代
- 问题：旧 HDMI 版实现后时序违例严重：pix_unbuf WNS=-51.760ns、sys_unbuf=-5.477ns、adc_fwd=-2.843ns——HDMI 像素时钟域与系统域交叉、约束不完整是主因。
- Prompt（还原要点）："旧版时序 WNS -51ns 太差，切 MIPI 前怎么把时序收干净？"
- 模型回答（要点）：MIPI 未做前先 headless：移除 HDMI 像素域与显示扫描逻辑，显示总线收进内部、用 50M 参考扫描；只保留 sys(65M) 与 adc 接口两个域，缩小时序分析范围；adc 输入延迟按 AD9238 tPD + PCB skew 估算（往返 6.5~11.5ns），板测后再校准。
- 验证：新版实现后 Setup 0 Failing、WNS +3.255ns，Hold +0.044ns，write_bitstream 成功。
- 纠错点：时序收敛要先砍"没必要的时钟域"再谈约束；HDMI 像素域在显示后端未定稿前不应进入实现；I/O delay 必须结合器件手册与 PCB 走线，不能凭感觉。
### 记录 #12　Hann 窗接口位宽适配与 BRAM 开销评估

> 【后续纠正】“Hann最大增益0.5”和“锁相加窗必然不适用”不能作为通用结论。实际截位需按系数缩放、输入范围和舍入策略核对；后续全速锁相实例已启用Hann，必须验证有限窗增益、相位与积分条件。保留下面回答作为早期建议，不作为当前规格。

- 日期/阶段：2026-10-07 · V7 创新包集成
- 问题：新增 Hann 窗（8192 点 Q15 系数 ROM）输出 16bit，但 xfft_frame_2ch 输入样例为 12bit，直接级联位宽不匹配；系数 ROM 资源占用需评估。
- Prompt（还原要点）："Hann 窗 16bit 输出怎么接 xfft_frame_2ch 的 12bit 输入？BRAM 够不够？"
- 模型回答（要点）：位宽适配取低 12bit（Hann 最大增益 0.5，12bit 满幅输入后输出约 11bit 有效，截到 12bit 不溢出，且避免了 `[15:4]` 截高位的错误做法）；Hann 只加在 FFT 链路上，时域 Vpp/RMS/锁相继续用原始采样（锁相是时域相干检测，加窗破坏正交性）；ROM 用半窗对称可优化到 4096 个系数（8192/2）。
- 验证：hann_window_2ch.v 接入 daq_processing_core，位宽适配为 `hann_ch0_out[11:0]`；综合后 BRAM 增量约 1~2 个 RAMB36 等效（远低于预估的 4 个）。
- 纠错点：窗函数输出位宽与下游输入位宽契约必须对齐；不要凭直觉截高位或截低位，先算最大增益再定位宽截取位置。

### 记录 #13　digital_capture_buffer BRAM 推断失败（set/reset 同优先级）
- 日期/阶段：2026-10-07 · 数字通道缓存
- 问题：V6 版本 digital_capture_buffer 把 RAM 写逻辑放在带异步复位的 always 块里（`if (!rst_n) ... else if (we) mem[addr] <= data`），Vivado 报 Synth 8-5788 "Register mem_reg has both Set and reset with same priority"，随后 Synth 8-4767 "Trying to implement RAM in registers"——RAM 被溶解成约 4096 个 FF，BRAM 推断完全失败。
- Prompt（还原要点）："digital_capture_buffer 的 mem_reg 报 set/reset same priority，然后 Trying to implement RAM in registers，怎么让它推 BRAM？"
- 模型回答（要点）：Block RAM 的内容本身不支持异步复位——一旦在 always 块里写了 `if (!rst_n)` 赋值给 mem 数组，Vivado 就必须用寄存器实现。正确写法是把 RAM 写口拆到独立的、只有 posedge、没有 reset 的 always 块；只复位 wr_addr、rd_addr、bank、valid、req/ack 等控制寄存器。
- 验证：拆分后综合日志出现 "Detected attribute (* ram_style = "block" *)"，4×512 数字缓存推成 BRAM，节省约 4000 FF。
- 纠错点：写 BRAM 推断代码时，RAM 数组的赋值必须在**纯同步、无复位**的 always 块里；复位只能作用于控制逻辑。这是 FPGA BRAM 推断的铁则。

### 记录 #14　digital_capture_buffer ACK CDC 只有一级同步器
- 日期/阶段：2026-10-07 · 数字通道缓存
- 问题：写侧（sys_clk 65MHz）同步读侧 ack 信号只用了 1 级触发器（`wr_ack_sync <= rd_ack`），而读侧同步写侧 req 用了 2 级，CDC 不对称有亚稳态风险。
- Prompt（还原要点）："digital buffer 的 wr_ack_sync 只有一级 FF，rd_req_sync 有两级，是不是要补上？"
- 模型回答（要点）：跨时钟域信号必须至少 2 级同步器；两边对称都加 `(* ASYNC_REG = "TRUE" *)` 标记；写侧改成 `wr_ack_sync[1:0]` 移位寄存器，判断用 `wr_ack_sync[1]`。
- 验证：修改后 CDC 结构对称，综合不再报相关警告。
- 纠错点：跨时钟域握手信号（req/ack）两侧都必须有 ≥2 级同步器，不能只做一边；ASYNC_REG 属性帮助 Vivado 识别同步器并做正确的布局约束。

### 记录 #15　clk_50m 非法连接（IBUF + 内部负载同时驱动）
- 日期/阶段：2026-10-07 · headless 顶层
- 问题：daq_top 中 display_clk 直接 assign 为 clk_50m（顶层输入端口），而 clk_50m 同时也接进了 MMCM 的 IBUF。Vivado 报 Synth 8-5535 "port clk_50m has illegal connections. It is illegal to have a port connected to an input buffer and other components"——同一个端口不能同时驱动 IBUF 和普通寄存器时钟。
- Prompt（还原要点）："综合报 clk_50m has illegal connections，IBUF 和内部负载冲突，怎么改？"
- 模型回答（要点）：Xilinx 7 系列顶层输入时钟必须经 IBUF 后才能驱动内部逻辑；display_clk 不应使用未缓冲的 clk_50m。改用 MMCM 输出的 `clk_sys`（65MHz，已经在 BUFG 上）作为 display 域时钟，既避免 IBUF 冲突，又与系统域同频同相（消除 display 与 sys 之间的 CDC 复杂度）。
- 验证：修改后 Synth 8-5535 错误消失，综合通过。display 域与 sys 域同频后，wave/spectrum/digital buffer 的 CDC 仍然保留（接口标准不变），但实际路径更简单。
- 纠错点：7 系列 FPGA 的输入时钟必须走 IBUF → BUFG 路径；内部逻辑不能直接挂在顶层时钟输入端口上；display 时钟优先复用已有 BUFG 时钟，避免额外的时钟域和 CDC 开销。

### 记录 #16　THD 谐波和位宽不足（34bit 不够装 4 个 34bit 之和）
- 日期/阶段：2026-10-07 · THD 模块 v6.1
- 问题：thd_analyzer 中 psum = h2+h3+h4+h5，每个 hp 是 34bit，直觉认为和也是 34bit，但实际 4 个 34bit 数相加最大需要 34+log2(4)=36bit；同时缩放乘积也存在位宽截断风险（先零扩展到 64bit 再乘，导致 64×27=91bit 截成 64bit）。
- Prompt（还原要点）："4 个 34bit 的谐波功率相加，和是不是 34bit？会不会溢出？缩放乘积呢？"
- 模型回答（要点）：明确扩展：`psum_full = {2'b00, h2} + {2'b00, h3} + {2'b00, h4} + {2'b00, h5}`（36bit）；缩放常数限制为 27bit（100,000,000 < 2^27）；36 × 27 = 63bit 乘积，1bit 零扩展后 64bit 正好进除法器；不要用 `{30'd0, psum}` 先零扩展到 64bit 再乘——那样是 64×27=91bit 会截高 27bit。
- 验证：位宽推导链写入模块头部注释（34→36→×27→63→64）；综合无位宽截断警告。
- 纠错点：多个数相加的位宽 = 最大操作数位宽 + log2(操作数个数)；定点乘法先算两边位宽再定结果位宽，不要靠隐式推导；关键计算链的位宽必须在代码头部注释里写清楚推导过程。

### 记录 #17　THD 状态机重构：先锁存再计算，消除 unused 警告
- 日期/阶段：2026-10-07 · THD 模块 v6.1
- 问题：早期 THD 在 fft_valid 当拍直接读取 hp 累加器启动除法器，导致 p1_hold_ch0 / psum_hold_ch0 / ok_hold_ch0 三个寄存器从未被读取，综合报 Synth 8-6014 "Unused sequential element p1_hold_ch0_reg was removed"；同时 CH0 和 CH1 的计算路径不一致（CH0 直接用累加器值，CH1 用 hold 寄存器）。
- Prompt（还原要点）："p1_hold_ch0 报 unused，怎么让 hold 寄存器真正用上并且两个通道路径一致？"
- 模型回答（要点）：增加 ST_LATCH 状态，fft_valid 时只做锁存（把所有 hp 写入 hold 寄存器），下一拍再从 hold 寄存器取值启动除法器。状态机扩展为 7 态：ST_ACCUM → ST_CH0_START → ST_CH0_DIV → ST_CH0_SQRT → ST_CH1_START → ST_CH1_DIV → ST_CH1_SQRT。同时 CH2/CH3 THD 固定为 16'hFFFF（无效标记），避免下游误判为 "THD=0%"。
- 验证：p1_hold/psum_hold/ok_hold 全部被使用，unused 警告消失；两通道计算路径完全对称；CH2/CH3 输出 FFFF 哨兵。
- 纠错点：组合数据路径和时序数据路径要分层——"捕获 → 锁存 → 计算"三步曲比"捕获+计算混合"更清晰，也更容易避免 set/reset 同优先级问题。

### 记录 #18　fixed_divider 寄生在旧 FFT 文件 → 独立为公共模块
- 日期/阶段：2026-10-07 · 工程结构清理
- 问题：工程重构时把旧自研 FFT（fft_frame_4ch.v）从综合范围排除，但 digital_lock_in 的 FCW 除法器仍例化其中的 fixed_divider，综合报 Synth 8-439: module 'fixed_divider' not found。
- Prompt（还原要点）："digital_lock_in 报 fixed_divider not found，但它明明定义在 fft_frame_4ch.v 里？"
- 模型回答（要点）：定位根因：fft_frame_4ch.v 已被排除出综合，其内部模块对综合不可见；解法是把除法器抽成独立文件 fixed_divider_generic.v（参数化 NUM_W/DEN_W，补除零保护：denominator==0 输出全 1 + valid），THD/插值/锁相统一复用，不依赖旧文件。xfft_frame_2ch 内的 fixed_divider_xfft 同步删除，改用公共模块。
- 验证：独立文件加入工程后综合通过；多个调用点共享同一个 divider 实现。
- 纠错点：公共模块（除法器/计数器/FIFO）必须独立成文件，不要寄生在"即将淘汰"的模块里；从工程排除旧文件前先 grep 谁还在引用它。

### 记录 #19　V7 创新包全量集成（Hann / 相位门控 / Lock-in v2 / UART / SPI / 统计）
- 日期/阶段：2026-10-07 · V7 创新包集成
- 问题：V7 创新包包含 6 个新模块（hann_window_2ch、phase_valid_gate、digital_lock_in_v2、uart_rx_decoder、spi_mode0_decoder、auto_test_stats），需要全部接入现有信号链并保证不破坏已有功能。
- Prompt（还原要点）："把 V7 创新包里的 6 个模块全部集成到现有工程里，分别接在哪里？"
- 模型回答（要点）：
  - hann_window_2ch：接在 XFFT 前（FFT 链路加窗，时域/锁相不加）
  - phase_valid_gate：接在相位测量输出后（基波功率低于噪声底时输出 invalid）
  - digital_lock_in_v2：替换 v1（频率平滑 + 运行时可配置积分长度 + FCW 边界保护），acc_log2 固定为 4'd10（1024 点）
  - uart_rx_decoder：接数字通道 D0（115200 8-N-1，协议观察）
  - spi_mode0_decoder：接数字通道 D0=SCLK/D1=MOSI/D2=MISO/D3=CS_n（SPI Mode 0 协议观察）
  - auto_test_stats：接 auto_tester 输出（总次数/通过次数/失败次数统计）
- 验证：待综合（记录待补充实测数据）。
- 纠错点：批量集成前先画信号流图，明确每个新模块的上游来源和下游去向；协议解码器属于"观察型"模块，不影响主测量链路时序。

### 记录 #20　竞赛项目含金量评估与创新方向选择

> 【证据边界】以下评分为当时主观讨论，未依据正式评审结果，不作为赛事成绩或客观完成度。

- 日期/阶段：2026-10-07 · 竞赛策略与创新点论证
- 问题：当前"示波器+频谱仪"类项目在 MAD FPGA 赛道同质化严重，需要评估现有项目的竞争力，并选择有差异化的创新方向。
- Prompt（还原要点）："目前这个项目能进决赛吗？怎么优化？结合时事发展有什么创新方向？"
- 模型回答（要点）：
  - 当前评分约 59/100（系统复杂度75 / 技术深度65 / 完成度55 / 创新性50 / 应用价值70 / 展示效果40），进决赛有风险
  - 最大短板：示波器类项目泛滥差异化不足 + 无板级实测 + 无直观显示界面
  - 分析 6 个创新方向：TinyML信号分类、侧信道分析、RISC-V软核、软件定义无线电、生物医学ECG、数字孪生自校准
  - 推荐"AI自适应降噪 + 语音控制"组合，但需避免"简单波形分类"这种花架子
  - 最终方向定为：面向测量保真的轻量化 1D CNN 信号增强 + 数字锁相联合弱信号检测
- 验证：方向已确定，待进入实施阶段。
- 纠错点：竞赛项目的创新不能是"加个AI功能"，而要让AI成为仪器核心能力的一部分；技术深度 + 展示效果 + 实测数据三者缺一不可。

### 记录 #21　初版 CNN 计算量严重低估（漏乘输入通道数，差 5 倍）
- 日期/阶段：2026-10-07 · AI增强/弱信号检测架构论证
- 问题：TinyDenoiser-v1 (Encoder-Decoder) 初估约 69,632 MAC/256点，但 Conv2、Conv3、DeConv 漏乘输入通道数 Cin。正确公式为 MAC = Lout × Cout × Cin × K。
- Prompt（还原要点）："CNN 的 MAC 数是 Lout×Cout×K 还是要乘 Cin？我之前算的 70K 对不对？"
- 模型回答（要点）：按完整公式重算：Conv1=18,432；Conv2=81,920；Conv3=98,304；DeConv=131,072；ConvOut=18,432，总计 348,160 MAC/256点，约为初版估算的 5 倍。8 MAC/cycle 需约 43,520 cycle ≈ 669.5μs @65MHz。
- 验证：256 个 65MSPS 样本仅约 3.94μs，因此该结构处理时间约为输入窗口时间的 170 倍，绝对不能作为 65MSPS 连续实时前级。
- 纠错点：CNN 吞吐估算必须包含输入通道数 Cin，公式是 Lout×Cout×Cin×K；RTL 固化前必须逐层建立 MAC/存储/带宽预算表，不能只算最外层。

### 记录 #22　帧式 CNN 不能直接喂给 65MHz Lock-in / 8192 点 FFT
- 日期/阶段：2026-10-07 · CNN+数字锁相联合架构
- 问题：256 点 CNN 非连续帧输出若直接送 Lock-in 或拼成 8192 点 FFT，会破坏真实采样时间轴——锁相要求 x[n]·sin/cos(ωn) 的 n 是连续采样时刻，FFT 也要求连续且采样率定义明确的数据。
- Prompt（还原要点）："CNN 输出是一帧一帧的，能直接送给锁相放大器吗？时间关系对不对？"
- 模型回答（要点）：不对。抽帧 CNN 不存在连续 65MSPS 增强输出，out_valid 不等于可按原采样率解释。若按当前 669μs/帧的处理速度，处理期间 ADC 已产生约 170 个新窗口，数据时间轴完全错位。结论：CNN 不能直接作为 65MHz 锁相/FFT 的前级。
- 验证：时间推算成立（669.5μs / 3.94μs ≈ 170×）。
- 纠错点：AI 输出接测量算法前必须保持采样时间轴连续；out_valid 脉冲不等于可按原采样率解释的连续数据流；级联前先画时间轴。

### 记录 #23　AI 支路降采样到 ~1MHz，RAW 高速链完整保留

> 【后续更新】本条÷64/约1MSPS为早期预算；后续双路共享CNN采用CIC3/16＋FIR/16、R256、每路253906.25SPS，见#46。不能用早期单窗理论时间证明双路65MSPS实时AI。

- 日期/阶段：2026-10-07 · V8 架构规划
- 问题：65MSPS 直接 CNN 吞吐不足，而抽帧又无法形成严格连续测量链。
- 模型回答（要点）：采用双域架构——高速 RAW 域 65MHz 保留 Vpp/RMS/Mean、波形、Hann+XFFT、RAW Lock-in（保真度最高的原始测量链）；AI 域先做抗混叠低通，再 ÷64 到约 1.015625 MSPS，运行 Tiny 1D CNN 及 AI Lock-in/分析。两条链并行，结果通过四模式 MUX 选择输出。
- 验证：256 点在 1.015625 MSPS 下约 252μs；若用全分辨率 depthwise 网络（约 90K MAC）+ 8 MAC 阵列，处理时间约 173μs，有 45% 余量，可实现 AI 域内的连续实时处理。
- 纠错点：必须满足 MAC/s ≥ sample_rate × MAC/sample；降采样前必须抗混叠；各算法链必须使用自己正确的有效采样率，不能混用。

### 记录 #24　测量保真 CNN：取消 stride/deconv，改用全分辨率残差噪声预测
- 日期/阶段：2026-10-07 · TinyMP-Denoiser 结构优化
- 问题：stride=2 编码 + 转置卷积（Encoder-Decoder 结构）可能改变时间位置、高频细节、相位和谐波，不利于测量仪器的"保真"要求。
- Prompt（还原要点）："面向测量保真的 CNN，网络结构应该怎么选？stride 和 deconv 会不会破坏相位和谐波？"
- 模型回答（要点）：仪器 AI 不能只追求"波形看起来更干净"。推荐全分辨率残差 1D CNN，网络预测噪声 n_hat[n] = CNN(x[n])，输出 s_hat[n] = x[n] - n_hat[n]（原始信号直通，CNN 只学噪声）。中间用 depthwise + pointwise 卷积降低计算量（普通 16→16 K=5 每点 1280 MAC，depthwise+pointwise 仅 336 MAC，减少 3.8 倍）。损失函数也应多目标：L = L_wave + 0.2×L_FFT + 0.1×L_amp，确保频谱和幅度也保真。
- 验证：待 Python 训练后以 ΔSNR、幅度误差、频率误差、相位误差、THD 误差联合验证，再固化 RTL。
- 纠错点：仪器 AI 不能只追求波形视觉效果；网络结构和损失函数必须围绕测量量保真设计；"测量保真"是区别于普通去噪的核心。

### 记录 #25　CNN 权重存储位数误判：2KB 权重不等于 2000 FF
- 日期/阶段：2026-10-07 · CNN FPGA 资源预算
- 问题：初版估算 2064 个 INT8 权重约需 2000 个 FF。
- Prompt（还原要点）："2KB 权重用 FF 存的话大概需要多少个 FF？2000 个够吗？"
- 模型回答（要点）：2064 × 8 = 16,512 bit，若逐位用 FF 约需 16,512 个 FF（不是 2000）。正确方案是用 LUTRAM（Distributed ROM）或 BRAM。TinyMP-Denoiser 仅 352 字节权重（~2,816 bit），用约 100 个 LUT 即可实现，零 BRAM 消耗。
- 验证：位宽计算成立（参数量 × 位宽 = 总 bit 数），最终资源以 Vivado placed report 为准。
- 纠错点：参数个数与存储 bit 数必须区分；INT8 参数的 FF 成本不是"一个参数一个 FF"；权重优先用 ROM/LUTRAM 而不是 FF。

### 记录 #26　CNN/锁相增益不能预设固定 dB 数，改为板级实验指标
- 日期/阶段：2026-10-07 · 创新点表述与验证
- 问题：早期方案示意写了 "CNN 提升 10~20dB、锁相再提升 20~30dB、最终 +30~40dB"，但尚无训练或板测支撑。
- Prompt（还原要点）："方案里写 CNN+锁相总共提升 30-40dB，这样写会不会不严谨？"
- 模型回答（要点）：会。这些只能作为目标，不能写成已实现指标。CNN 增益依赖训练集和噪声类型；锁相处理增益受积分长度、频偏、ADC ENOB、时钟和相位噪声等多种因素影响。正确做法是建立 RAW / CNN / RAW Lock-in / CNN+Lock-in 四模式对照实验，实测统计 ΔSNR、E_A、E_f、E_φ、E_THD，用数据说话。
- 验证：后续板级 A/B 实验后补充实测数据。
- 纠错点：设计目标和实测指标必须分开；竞赛材料中的 dB、精度和灵敏度提升必须有测试数据支撑，不能凭直觉写。

### 记录 #27　Hann 窗 ROM 半窗对称优化（8192 → 4097 系数，省约 2 RAMB18）
- 日期/阶段：2026-10-07 · Hann 窗优化
- 问题：Hann 系数 ROM 存完整 8192 × 16bit = 131,072 bit ≈ 7.1 RAMB18 ≈ 3.6 RAMB36 等效。BRAM 是当前最紧的资源（约 68% 已用），需要尽可能节省。
- Prompt（还原要点）："Hann 窗能不能用半窗对称减少 BRAM？w[n] = w[N-1-n] 对吗？"
- 模型回答（要点）：Hann 窗满足 w[n] = w[N-1-n]（关于 N/2 镜像对称），因此只需存前 N/2+1 = 4097 个系数（含中点最大值）。读地址 n ≤ N/2 时直接读；n > N/2 时读 N-1-n（镜像地址）。ROM 容量减半（4097 × 16 = 65,552 bit ≈ 3.6 RAMB18 ≈ 1.8 RAMB36），节省约 2 个 RAMB18。用 generate + HALF_WINDOW_OPT 参数控制，保留全窗回退选项。Q15 量化下镜像对（如 n=100 / n=8091）仅 1 LSB 舍入差异，完全可接受。
- 验证：Python 生成 4097 个半窗系数并验证对称性（w[0]=0, w[4096]=32767, 镜像对差异 ≤ 1 LSB）；RTL 用 generate 块实现地址镜像逻辑，功能与全窗等价。
- 纠错点：对称窗函数（Hann/Hamming/Blackman）都可以用半窗对称减少 ROM；BRAM 紧张时优先做这种"零功能损失"的存储优化，再考虑降位宽等有损优化。

### 记录 #28　AI 支路 64 倍抽取器：用 Boxcar 累加器替代 FIR，零 DSP 实现抗混叠

> 【结论更正】下文“Boxcar抗混叠对AI完全足够、CNN天然鲁棒”没有充分验证，已撤回为通用结论。boxcar只有有限低通，不能作为全频保真抗混叠；后续AI采用专用CIC/FIR，显示平均和测量抽取分开，见#46、#52、#61。

- 日期/阶段：2026-10-08 · AI 支路基础设施
- 问题：AI 支路需要从 65MSPS 降采样到 ~1MSPS（÷64），常规 FIR 需要多个 DSP48 做乘累加，资源紧张。
- Prompt（还原要点）："AI 支路 ÷64 抽取，能不能不用 FIR？Boxcar 滑动平均性能够不够？资源多少？"
- 模型回答（要点）：Boxcar（矩形窗滑动平均）等效于系数全为 1 的 FIR，用累加器实现完全不需要乘法器——N 点平均只需一个加法器 + 一个计数器，资源几乎为零。抗混叠性能方面，第一旁瓣 -13dB，对 AI 去噪预处理完全足够（CNN 本身对带外泄漏有鲁棒性）；若后续需要更好阻带可再级联 CIC 或半带。最终采用 analysis_decimator_4ch（Boxcar 结构，LOG2_D=6 → 64 倍抽取，输出约 1.015625 MSPS），4 通道并行仅用 ~200 个 FF。
- 验证：RTL 实现后 xvlog 编译通过；Boxcar 直流增益为 1，无幅度溢出；输出速率 = 65MHz/64 ≈ 1.015625 MHz，与 CNN 单帧处理时间 173μs 匹配（45% 余量）。
- 纠错点：抽取滤波器不一定非要用 FIR；对于 AI 预处理等对阻带衰减要求不高的场景，Boxcar/滑动平均是"零 DSP、极低资源"的最优解；先评估最低配方案是否满足需求，再逐级升级。

### 记录 #29　帧对齐缓冲区设计：4 槽位状态机 + FWFT 输出，解决 Raw/CNN 帧速不对齐

> 【历史结构】四槽位frame_align_buffer是当时版本，不代表当前双路共享CNN调度结构；当前窗口、epoch/故障和物理相位对齐应按#46对应版本验证。

- 日期/阶段：2026-10-08 · AI 系统集成
- 问题：Raw 帧 252μs/帧（~3967 fps），CNN 处理 173μs/帧，两者速率不同且相位错位，直接拼接会导致同一 frame_id 的 Raw 和 CNN 数据错位。
- Prompt（还原要点）："Raw 和 CNN 是两条并行支路，帧速率不一样，怎么按 frame_id 配对输出？需要 FIFO 吗？"
- 模型回答（要点）：用帧对齐缓冲区（frame_align_buffer），4 个槽位的状态机结构，每个槽位存 {Raw 数据 + CNN 数据 + valid 标志 + frame_id}。Raw 先到写槽位，CNN 后到匹配同 frame_id 槽位，两者都齐了槽位就绪。输出用 FWFT（First-Word Fall-Through）模式，就绪数据直接加载到输出寄存器。同时支持：① 同时到达（同拍 Raw+CNN 同 frame_id）直接进就绪；② 前向写入（缓冲区满时恰好消费一个，新数据直接写入刚释放的槽位，无气泡）；③ 超时回退（某帧只有 Raw 没有 CNN，超时后强制输出 Raw 兜底）。
- 验证：xsim 测试 7/7 场景 PASS（同速、CNN 慢、CNN 快、同时到达、前向写入、超时回退、溢出保护）；端到端融合测试全部通过。
- 纠错点：两条速率不同的并行支路不能直接"对齐输出"，必须用缓冲+匹配机制；FWFT 比普通 FIFO 更适合帧级数据（整帧就绪后直接输出，无需读使能预热）；超时兜底是 fail-soft 设计的关键——宁可输出 Raw 也不能卡住下游。

### 记录 #30　CNN 幅值校准 LUT：5 级流水线 + fail-closed 安全机制

> 【资格边界】数字幅值LUT不等于模拟电压/相位校准完成，默认无效与回退是保护，不是模型质量证书。

- 日期/阶段：2026-10-08 · AI 测量保真
- 问题：CNN 去噪后幅值会有系统性偏差（网络学到的增益不一定是 1.0），直接送测量链路会导致 Vpp/RMS/THD 全部偏移。
- Prompt（还原要点）："CNN 输出幅值不准怎么办？能不能做个校准？怎么保证校准失效时不输出错误结果？"
- 模型回答（要点）：分 bin 做 LUT 校准——按输入幅值分 256 档，每档存一个增益修正系数（INT16 Q12 格式），5 级流水线完成读取+乘法+截断。关键是 fail-closed 安全机制：① 所有 LUT 初始化为 0（无效）；② 校准系数通过 UART/寄存器逐 bin 写入；③ 某 bin 未写入时输出幅值强制为 0 + valid=0，下游自动判为无效；④ 整表未完成前不输出有效数据。这样保证"校准不完整=不输出假数据"，而不是用默认 1.0 增益蒙混过关。
- 验证：RTL 实现后集成通过；fail-closed 机制在 branch_decision 中被正确识别（calibration_valid=0 时拒绝选 CNN）。
- 纠错点：校准模块必须 fail-closed 而不是 fail-open；默认值应该是"无效"而不是"增益 1.0"；下游判决模块必须检查校准有效标志，不能假设校准永远正确。

### 记录 #31　三模式判决分支：保守 AUTO 模式，宁可不用 CNN 也不让坏结果出去

> 【结论更正】RAW/CNN残差或“差得很少”不能证明CNN更好，也不是有干净真值的SNR。后续资格位仍为0，AUTO保持RAW，见#47；此处逻辑仅是历史门控设计。

- 日期/阶段：2026-10-08 · AI 系统集成
- 问题：AUTO 模式下如何决定用 Raw 还是 CNN？简单阈值会导致边界附近频繁跳变，且可能在 CNN 效果不好时反而选 CNN。
- Prompt（还原要点）："AUTO 模式怎么选 Raw 还是 CNN？有哪些判断条件？怎么保证不选错？"
- 模型回答（要点）：保守策略——6 个条件全部满足才选 CNN，任一不满足就回退 Raw：① calibration_valid（校准有效）；② amp_diff < THRESHOLD（幅值差不超过阈值，说明 CNN 没有把幅值改太多）；③ phase_diff < THRESHOLD（相位偏移可控）；④ snr_estimate > MIN_SNR（信噪比足够高，CNN 才有提升空间）；⑤ cnn_frame_valid（CNN 帧有效且未溢出）；⑥ frame_match（Raw/CNN 帧对齐成功）。理由：仪器的第一原则是"不给出错误结果"，AUTO 模式应该是"确定 CNN 更好才用"，而不是"可能更好就试试"。
- 验证：branch_decision 三模式（RAW_ONLY / CNN_ONLY / AUTO）实现；AUTO 模式下 6 条件全为与逻辑，任一不满足即选 Raw；status[3:0] 输出可观测每一步拒绝原因。
- 纠错点：仪器类 AI 的 AUTO 模式必须保守——"宁可不用，也不用错"；判决条件要可观测（每一位对应一个失败原因），方便调试；Raw 永远是安全兜底。

### 记录 #32　共享 CORDIC 时分复用：双支路幅相转换只实例化一个 CORDIC

> 【历史资源估计】“约200+LUT”“零性能损失”为当时估计，具体共享结构是否保留、吞吐和资源以对应实现报告为准。

- 日期/阶段：2026-10-08 · AI 系统集成
- 问题：Raw 和 CNN 两条支路都需要 CORDIC 做幅相转换，各实例化一个会浪费一个 CORDIC（约 200+ LUT）。
- Prompt（还原要点）："两条支路都要 CORDIC 求幅相，能不能共享一个？时分复用怎么调度？"
- 模型回答（要点）：可以共享。用状态机时分复用：① Raw 帧到来 → 启动 CORDIC → 存 Raw 结果；② 等 CNN 帧就绪 → 再启动同一个 CORDIC → 存 CNN 结果；③ 两者都完成后联合输出。关键是处理 pending 缓冲和 overrun 检测：若新 Raw 来的时候 CORDIC 还在处理上一组，丢帧并置 overrun 标志。CORDIC 16 次迭代约 16 周期，相对于 252μs 帧周期完全可以忽略，时分复用不影响吞吐。
- 验证：ai_dual_lockin_fusion 共享单 CORDIC 实现；xsim 测试 7/7 场景 PASS（正常、pending、overrun、同时到达、顺序颠倒等）。
- 纠错点：低速多通道共享高速运算单元是 FPGA 设计的常用手法；只要运算时间远小于数据到达间隔，时分复用就是零代价的；一定要有 overrun 检测，否则调度错误会被静默掩盖。

### 记录 #33　数字锁相 v2 设计：参考频率 IIR 平滑 + 运行时可配置积分长度 + FCW 边界保护
- 日期/阶段：2026-10-09 · V7→V8 锁相升级
- 问题：v1 锁相参考频率直接跳变，FCW 更新时相位不连续，积分长度固定不灵活。
- Prompt（还原要点）："数字锁相怎么改进？参考频率切换时要平滑过渡，积分长度要能运行时配置。"
- 模型回答（要点）：
  - 参考频率平滑：一阶 IIR 低通 y[n] = y[n-1] + α(x[n]-y[n-1])，α=1/2^N 用右移实现，频率切换时指数收敛，避免相位跳变
  - 运行时可配置积分长度：acc_log2 输入端口，2^acc_log2 点积分，范围 1~4096 可配
  - FCW 边界保护：FCW 只在相干积分块边界更新，不会切断正在进行的积分块，保证每块都用同一个频率
  - 幅值近似：alpha max + beta min 近似（max + min/2），误差约 11.8%，零乘法器
  - CORDIC 相位：复用已有 cordic_atan2，输入截取高 32 位
- 验证：digital_lock_in_v2 实现，xvlog 编译通过；IIR 平滑 + FCW 边界保护功能正确；积分长度可动态切换。
- 纠错点：锁相放大器的参考频率是"慢变量"，用 IIR 平滑比硬切更符合实际信号特性；积分长度决定频率分辨率和 SNR 提升，应该做成可配置而不是固定值；FCW 更新必须和积分块对齐，否则单块内频率不一致会降低增益。

### 记录 #34　AI 锁相 I/Q 探针：双支路共享 NCO + 分时乘法器，零额外 NCO 资源

> 【时间轴边界】RAW与CNN并非无条件“同频同相”；共享参考必须补偿处理时延、滤波群延迟及窗口位置，并以物理采样索引验证，不能只因共享NCO就认定已对齐。

- 日期/阶段：2026-10-09 · AI 观测接口
- 问题：需要同时观测 Raw 支路和 CNN 支路的锁相结果（I/Q、幅值、相位），各做一个锁相太浪费。
- Prompt（还原要点）："Raw 和 CNN 都要锁相观测，能不能共用一个 NCO？怎么分时？"
- 模型回答（要点）：共享 NCO + 分时乘法器架构。NCO 每个 sample_valid 输出一对 sin/cos，同一拍内先乘 Raw 样本，再乘 CNN 样本（两拍完成两路混频）。因为 Raw 和 CNN 是同频同相的（只是波形质量不同），共享 NCO 完全正确。积分器也是分时共用——Raw 积分和 CNN 积分交替进行。资源节省：少用一个 NCO（相位累加器 + sin ROM），乘法器从 2 个减到 1 个分时复用。
- 验证：ai_lockin_iq_tap 实现，xvlog 编译通过；双支路输出时序正确，与单支路锁相结果一致。
- 纠错点：同频率的多路信号可以共享 NCO；分时复用乘法器在低速场景下是零性能损失的；设计观测模块时优先考虑共享核心运算单元。

### 记录 #35　约束加载顺序错误导致布线时序失败（WNS −13.974ns → +1.361ns）

> 【阶段边界】保留本条时序回归纠错；具体失败属于综合或布线以该次报告路径、时间戳和实现状态裁决，不能把某个固定负余量普遍解释为“默认综合的值”。ADC多周期有效性仍需真实接口时序依据。

- 日期/阶段：2026-10-18 · 工程重建后时序收敛
- 问题：重建工程布线后 Setup WNS = **−13.974 ns**，822 个违例端点，分为三组：ADC 外部输入→采集寄存器 26 条（−13.974 ns）、65 MHz 内部建立 585 条（−4.11 ns）、异步复位恢复 211 条（−3.10 ns）。
- Prompt（还原要点）："新重建的工程时序没过，WNS −13.97ns，是不是 ADC 那边的约束没生效？"
- 模型回答（要点）：根因是约束文件**加载顺序/时机**不对——`base_clocks.xdc` 与 `adc_forwarded_clock.xdc` 未按先后阶段加载，导致 ADC 的 setup-only 多周期约束未生效，捕获窗口被当成单周期 **2.564 ns**，而实际应为 **17.949 ns**（AD9238 输出延迟 + PCB skew 构成的有效窗口）。解法是在 build.tcl 中把 `base_clocks.xdc` 归入 **EARLY**、`adc_forwarded_clock.xdc` 归入 **LATE**，使跨时钟域与转发时钟约束在同一套基准时钟之后加载。
- 验证：修复后重跑实现，布线报告 `daq_top_timing_summary_routed.rpt`：**Setup WNS = +1.361 ns、Hold WNS = +0.034 ns、0 违例端点**，明确输出 "All user specified timing constraints are met"。
- 纠错点：**本次 AI 自身出现误判，值得单列**——AI 最初把 −13.974 ns 解释为"你误看了综合阶段报告"（综合报告确实恒定显示未布线悲观值），但用户核对的是 11:39 的**真实布线报告**，是真实失败后经修复才转绿。教训：当对方报出与预期不符的数据时，先核对报告来源与时间戳（`synth_1` vs `impl_1` 目录、`synth` vs `routed` 后缀），再判断是否误读；不能因为"存在另一种常见误读"就推断对方犯了这个错。
- 附：闭合判据只有 `impl`/`bit`；默认无参 `build.tcl`（mode=synth）显示的 −13.97 ns 是未布线基线，不代表收敛结果。

### 记录 #36　高扇出复位网络导致内部建立违例（vofa_link/clear 扇出 5862）
- 日期/阶段：2026-10-18 · 时序收敛
- 问题：65 MHz 内部建立违例 585 条中最差路径来自 `vofa_link/clear`，该网络扇出高达 **5862**，单驱无法在 15.38 ns 内到达全部负载。
- Prompt（还原要点）："最差路径是 vofa_link/clear，扇出快六千了，怎么让它满足建立时间？"
- 模型回答（要点）：不要靠改 RTL 手工复制寄存器，交给工具的物理优化：在实现阶段保留 `post-route phys_opt_design -directive AggressiveExplore`，由工具自动做**扇出驱动复制（fanout replication）**，把高扇出网络拆成多个副本就近驱动负载。同时把增量检查点默认关闭（`use_incremental=0`）——旧 dcp 来自不同设计变体，曾引发崩溃。
- 验证：修复后 WNS 转正至 +1.361 ns，0 违例；`vofa_link/clear` 不再出现在最差路径中。
- 纠错点：**本次 AI 自身出现第二次误判**——AI 曾断言"下游全是同步复位，无恢复/移除风险"。实际源码存在 **32 处 `always @(posedge ... or negedge ...)` 异步复位块，分布在 20+ 文件**；且当前布线报告**明确包含 Recovery 检查章节**。教训：`Enable Preset / Clear Arcs: No` **不能**解释为 Recovery/Removal 全部关闭；复位时序必须逐条查布线报告的 Recovery/Removal 章节，不能凭"某模块用了同步复位"推断全设计无隐患。

### 记录 #37　仿真激励在 posedge 驱动导致采样竞争，正常窗口导出失败
- 日期/阶段：2026-10-18 · 数字链路仿真（不依赖硬件）
- 问题：导出/传输仿真（`sim/tb_vofa_uart.v`）中故障注入全部通过，但**正常窗口始终导出失败**：`has_wave=0`、`#ADC_RAW` 行数为 0、帧内只有 META/PARAM 没有波形。期间一度怀疑是 `v32_vofa_uart.v` 的 RTL 缺陷。
- Prompt（还原要点）："故障注入都过了，正常窗口却出不来波形，has_wave 一直是 0，是 RTL 的问题吗？"
- 模型回答（要点）：不是 RTL 问题，是**测试台自身的采样竞争**。原 TB 用 `@(posedge clk)` 驱动激励，与 DUT 的 posedge 捕获沿同沿；同时监视器也在 posedge 采样内部信号，读到的 `frame_id` 是上一帧的残留值（日志显示 `tj=100 fid=14`），据此做出的归因完全错误。解法：激励改为 **negedge 驱动**、监视改为 **negedge 采样**——两者都避开 DUT 的捕获沿，且 negedge 时上沿的 NBA 结果已稳定，读数确定可信。
- 验证：改后 6 项故障注入全部通过（有效信号间断 / 超量程 OTR / flush / job_id 不匹配 / 索引错序 / 故障后回 IDLE），正常窗口导出完整：**21 META + 63 PARAM + 256 TRAIN_INPUT + 256 ADC_RAW + 257 wave（含 1 条 `wave:nan,nan` 间隔）+ 232 TRAIN_PRED + 1 END，共 42,955 字节**。
- 纠错点：测试台的**驱动沿与采样沿必须避开 DUT 捕获沿**（推荐统一 negedge）。更重要的元教训：当"监视结果与预期不符"时，**先怀疑监视方法，再怀疑被测对象**——错误的观测手段会制造出看起来很像 RTL bug 的假象，AI 在这一轮就差点据此下错误结论。

### 记录 #38　激励计数器位宽不足导致窗口内回绕，被误判为"丢点"
- 日期/阶段：2026-10-18 · 数字链路仿真
- 问题：PC 侧校验报 `index 250→251: 跳变 −255（期望 +1）`，初看是 ADC 丢点或通道错位。
- Prompt（还原要点）："ADC_RAW 序列中间突然掉 255，是丢点还是通道交换？"
- 模型回答（要点）：都不是，是**激励本身的位宽回绕**。TB 里 ADC 斜坡取 `ramp[7:0]`（8 位），而导出窗口跨 **512 个时钟周期**，8 位计数器必然在窗口内回绕。第二个坑：`adc_sample` 相对 `ramp` 滞后一拍，开窗瞬间抓到的是清零前的残留值（表现为首点为 262、其后从 0 开始），同样会被判成不连续。解法：位宽从 8 位扩到 **11 位**（> log2(窗口跨度)），并在开窗前清零、再等 4 拍让一级流水追上。
- 验证：改后 `adc_ch0 = [2,3,4,5,...]`、`adc_ch1 = [-2,-3,-4,-5,...]` 严格连续且互为相反数；`verify_raw.py` 11 项检查全通过（含"CH0 严格递增无重复无遗漏""两路未交换 ch1 == -ch0"）。
- 纠错点：设计激励时，**计数器位宽必须大于 log2(窗口跨度)**；信号有流水延迟时要在开窗前等待稳定。"看起来像丢点/错序"的异常，先排除激励自身的回绕与相位问题，再归因到 DUT。

### 记录 #39　文本串口协议没有 CRC：能力边界误判与 PC 侧验收工具链建立
- 日期/阶段：2026-10-18 · 协议与验收方法
- 问题：AI 曾把"CRC 验收"列为当前文本串口协议可完成项。
- Prompt（还原要点）："当前活动版的文本串口能做 CRC 校验吗？"
- 模型回答（要点）：**不能**。当前活动版 `v32_vofa_uart.v` 是 VOFA+ FireWater **文本行协议**，字段包含 `frame_id`/`index`/统计量/波形数值，但**没有任何 CRC 字段**。因此只能验证：字段完整性、点数、索引单调、帧号连续、帧边界——**不能检出任意比特翻转**（例如 "1234" 变成 "1334" 无法发现）。要做 CRC 验收必须使用带 CRC 的协议版本及其配套接收器，两者不可混用。
- 配套动作：为此建立不依赖硬件的 PC 侧验收工具链
  - `tools/vofa_text.py`：FireWater 文本协议解析器（`parse_file` → `(frames, FrameStats)`）
  - `tools/verify_raw.py`：结构与序列验收（11 项），支持 `--expect-adc-ramp` 与 `--json` 报告
  - `tools/ref_math.py`：与 RTL 定点规则对齐的软件参考（统计量 / Hann / FFT / DDC / 正弦拟合）
  - `sim/tb_adc_capture.v`：ADC 采集链路仿真（CH0 递增 / CH1 递减，两路未交换、无重复无遗漏、OTR 标记正确、锁定丢失后重新预热）
  - 已对齐的定点规则：`mean = Σx >> LOG2_N`（算术右移=向下取整）、`vpp = max−min`、`RMS_AC = isqrt((N·Σx² − (Σx)²) >> 2·LOG2_N)`（先移后开方）、Hann 为 Q15 且 `(x·c) >>> 15`、FFT 输入先 `<<4` 且每级蝶形 `>>1`（总归一化 1/N）
  - 自检：1 MHz / 500 counts 正弦 → `vpp=1000`、`rms_ac=353`（=500/√2）、拟合 `f=999847 Hz`、`amp=499.76`、`R²=0.9997`、DDC `amp=499.84`
- 纠错点：**协议能力必须逐字段核对源码**，不能按"一般协议都有 CRC"想当然。更要区分两件独立的事：**数字正确性**（同 RAW 下 FPGA 与软件参考是否一致）与**模拟采样质量**（RAW 与参考仪器测到的输入是否相符）——数字一致不代表没有模拟失真、噪声或混叠。

### 记录 #40　导出速率与窗口周期不匹配（463 ms/帧 vs 100 ms 周期）

> 【证据层级更正】本条463.243ms来自仿真，不是现场串口测量；42,955字节按名义921600/8N1计算约466.1ms，实际约463ms还受整数波特率分频影响。不能据此宣称板卡端长期吞吐或零丢帧。

- 日期/阶段：2026-10-18 · 传输链路实测
- 问题：现场计划按"每条件保存 100 个有效 RAW 窗口"安排时间，估算约 10 秒/条件。
- Prompt（还原要点）："一帧数据发完要多久？导出周期设的是多少？"
- 模型回答（要点）：实测一帧 **42,955 字节 @921600 波特 ≈ 463 ms**，而 `PERIOD_CLKS = 6,500,000` 对应 **100 ms**——即最坏情况下串口只能支撑约 **2.15 帧/秒**，远低于窗口周期要求的 10 帧/秒，`skipped_windows` 会持续累加。这不是 bug：导出是"被动快照"设计，采集与推理从不等待串口传输。
- 验证：仿真中实测 `传输耗时 463.243 ms / 导出周期 100.000 ms`，两者比值 4.6×。
- 纠错点：串口导出吞吐由**波特率与帧长**决定，与采样速率无关。制定现场采集计划前必须先算 `帧长 × 10 / 波特率`；按 2.15 帧/秒计，**100 个有效窗口约需 46 秒而非 10 秒**。若想提速，只能提高波特率或裁剪导出字段，不能靠改窗口周期。

### 记录 #41　新增 V32CAP3 二进制上传口（带 CRC32），补齐文本协议无 CRC 的缺口

> 【集成边界】此处为新增上传口的仿真、综合与布线证据，不是RK3506端实时接收/屏幕验收；较早采样归档采用相同应用协议，也不能替代新口板测。

- 日期/阶段：2026-10-19 · RAW 上传通道
- 问题：文本协议无 CRC（见记录 #39），无法满足"数据完整性"验收；同时需要把双通道 RAW 送给 Linux 侧做波形重建与显示。
- Prompt（还原要点）："需要一个能把 RAW 完整传出去、并且能验完整性的接口，怎么设计？"
- 模型回答（要点）：新增**二进制上传口 V32CAP3**，与 VOFA 文本口物理独立、可同时工作：
  - 帧长恒定 **16428 字节**：8 B 魔数 `"V32CAP3!"` + version(3) + frame_id + adc_fs_hz(65 MHz) + decimation(1) + points_per_channel(**4096**) + flags(0) + start_index(64 bit) + 16384 B 样点 + 4 B CRC32
  - 样点为 **int16 小端交错**（CH0 在 `40+4i`、CH1 在 `42+4i`），4096 点/通道
  - **CRC32**：反射多项式 `0xEDB88320`、初值 `0xFFFFFFFF`、最终异或 `0xFFFFFFFF`，**只覆盖 `[0, 16424)`**（头部 40 B + 全部样点），尾部 4 字节自身不参与；校验向量 ASCII `"123456789"` → `0xCBF43926`
  - 单帧内 4096 点**真正连续**（`t(i) = i / 65e6`），帧间是死区（采样窗口仅 63 µs，传输 178 ms）
  - 单向，无 ACK / 无命令通道 / 无帧尾
  - 引脚 **AB5** → RK3506 的 UART RX，两边必须共地；AB6（VOFA 文本口）保持不动
- 验证：① 仿真出 2 帧 32856 字节，`check_frame.py` 判定"合格 2 帧，问题 0 处"，`frame_id 1→2`、`start_index 0→184794`（无重叠），激励 `ch1 = ~ch0` 负值符号扩展全部正确；② 综合 `u_v32cap3` 644 单元、**4 块 BRAM**（4096×2×16 bit = 16 KB 样点 FIFO），黑盒 0；③ 实现后 **WNS +1.410 ns / WHS +0.053 ns，0 违例端点（42,529）**，未布线网络 0，DRC 0 Error / 0 Critical；④ 物理层反查 `v32_tx → IOB_X1Y29 → AB5`，与 base_v1 落在同一 site。
- 纠错点（规格书点名的最易错四处）：① 12 位样点必须**符号扩展**到 16 位（−13 要发 `F3 FF`，不是 `F3 0F`）；② CRC 只覆盖前 16424 字节；③ `points_per_channel = 4096` 不是 8192；④ **帧长必须精确 16428**，多一字节就会让下一帧的魔数错位。另：给 AI 的提示词里应写明"不要发明协议里没有的字段"。

### 记录 #42　跨工程搬运模块触发同名冲突（uart_tx → uart_tx_v32）
- 日期/阶段：2026-10-19 · V32CAP3 集成
- 问题：从 `signal_analyzer_base_v1` 把 V32CAP3 交接包搬进 AI_V32 时，交接包里的 `uart_tx.v` 与 AI_V32 已有的 `rtl/new/uart_tx.v` **模块名冲突**（都叫 `uart_tx`）。
- Prompt（还原要点）："搬过来的 uart_tx.v 和工程里已有的重名了，怎么办？"
- 模型回答（要点）：把新模块改名为 **`uart_tx_v32`**，并同步修改 `v32cap3_tx.v` 内的实例化名；顶层端口命名为 `v32_tx` 以与原有 `uart_tx` 端口区分。同时核对：搬运过来的协议参数（921600 8N1、16428 B/帧、4096 点/通道）与引脚（AB5）必须与 base_v1 **完全一致**，保证两份工程可互换验证。
- 验证：综合后 `v32_tx` 端口存在、黑盒 0；引脚反查 AB5，与 base_v1 同 site。
- 纠错点：跨工程复用模块前先 **grep 目标工程是否已有同名模块**；复用时保持"协议—参数—引脚"三者一致，才能互为交叉验证的参照系。

### 记录 #43　构建脚本并行度写死导致 OOM，及 Vivado batch 残留进程
- 日期/阶段：2026-10-19 · 构建环境
- 问题：`build.tcl` 原写死 `-jobs 4`。AI_V32 设计规模较大（LUT 82%），综合/实现峰值内存约 **1.1–1.9 GB**，而本机可用内存常在 1–2 GB，导致在 "Rebuilding User Hierarchy" / "Floorplanning" 阶段 `out of memory` 中断。
- Prompt（还原要点）："Vivado 跑一半报 out of memory，进程还残留着，怎么处理？"
- 模型回答（要点）：① 并行度改为**环境变量控制**（`BUILD_JOBS`），内存紧张时用 `BUILD_JOBS=1`（本次两次成功构建均用 1）；② OOM 中断后 Vivado batch 进程**不会自动退出**，会继续占内存，下次跑之前必须先清理残留——用 `Get-CimInstance Win32_Process -Filter "Name='vivado.exe'"` 查看命令行，**只清 `-mode batch` 的残留，不要动 `-gui_launcher_event` 那个**（那是正在使用的 GUI）。
- 验证：`BUILD_JOBS=1 vivado -mode batch -source build.tcl -tclargs bit -nojournal` 连续两次成功出 bit。
- 纠错点：在内存紧张的机器上，构建脚本**不要把并行度写死**，应暴露为环境变量；并行度不是越大越好，它与峰值内存近似成正比。

### 记录 #44　对外串口接口查证：全工程仅 1 个串口引脚且单向

> 【时点更正】“只有1个UART口”仅适用于新增V32CAP3之前。当前核对到的顶层已有uart_tx(AB6)和v32_tx(AB5)两个独立TX，仍无对应命令RX；不能把本条旧结论用于当前版本。

- 日期/阶段：2026-10-19 · 硬件接口核对
- 问题：需要确认"除了板载 Type-C，还有没有别的串口引脚可用？要不要自己配引脚？"
- Prompt（还原要点）："这个串口除了 Type-C 还有引脚吗？还是需要自己配置引脚才能用？"
- 模型回答（要点）：查证结论——**不需要自己配置**，但能力有限：
  - 全工程**只有 1 个串口引脚**：`uart_tx` → **FPGA AB6** → 板载 CH340E RXD → Type-C，约束已在 `rtl/xdc/io_constraints.xdc:52-55`（LVCMOS33 / DRIVE 8 / SLEW SLOW）配好，插上即用
  - 51 个已约束端口中**无第二个 UART**；`daq_top` 仅有 `output wire uart_tx`，**全工程没有 `uart_rx`**
  - XDC 注释明确 "AA6 (CH340E TXD) is intentionally NOT driven/used here. M15 stays unused"——回传方向**刻意不接**
  - 因此**不能通过 Type-C 下发命令或改配置**
  - 波特率标称 921600，65 MHz/70 分频实际为 **928571**（+0.75%，串口容差内，但接收端敏感时需知情）
- 纠错点：硬件接口结论必须以 **XDC + 顶层端口声明**为准，不能凭开发板外观或"一般开发板都有串口"推断；要新增串口（含把 AA6 用起来做 RX）需自行走"加端口 → 加模块 → 加 PACKAGE_PIN → 重新综合实现"四步。

## 二、近期新增闭环记录（#45～#64）

以下条目按“问题→复盘 Prompt→辅助建议/处理→证据与状态→纠错点”整理。Prompt 是根据工程记录归纳的复盘要点，不是原始聊天逐字转录；处理与测试结论来自对应报告，本次文档修订未重跑这些测试。

### 记录 #45　AD9238 采样接口纠正：双通道 SDR，不是双沿采样

- 日期/阶段：2026-10-11～10-17 · 采样接口复核。
- 问题：初稿项目简介写成“AD9238 双沿采样”，容易把两路 ADC 误解为 DDR，或误算为每路130MSPS。
- Prompt（复盘要点）：核对实际 ADC 并行接口、编码、OTR 与时钟关系，不以模块名或早期描述推断采样方式。
- 辅助建议/处理：按两路独立12位并行SDR口描述，每路65MSPS；偏移码转换、通道/OTR对齐、启动、复位和失锁单独检查。
- 证据与状态：10月17日复验记录12,332次有效采样比对，覆盖4096码和两种编码。现有顶层注释也明确为two separate parallel SDR ports。证据[S01、S18]。属于数字接口仿真证据，不替代ADC电气裕量和模拟前端验收。
- 纠错点：双通道不是双沿；标称采样率、外部I/O时序和模拟有效带宽分别验收。

### 记录 #46　共享低速 CNN：R256、双路分时与真实时间轴

- 日期/阶段：2026-10-12 · 双通道共享推理链实施。
- 问题：初稿÷64、约1.015625MSPS的单路预算，不能直接证明两路共享CNN可持续处理，更不能用低速CNN替换全速锁相前级。
- Prompt（复盘要点）：保持双路65MSPS采集，把CNN改为低速共享支路，并验证窗口、通道、相位和调度期限。
- 辅助建议/处理：CIC3/16＋321tap Q17 FIR/16，总R256；每路253,906.25SPS。一套共享CNN分时处理CH0/CH1，256点输入、232点有效输出、相邻窗口重叠24点；RAW与CNN采用同窗和匹配的物理相位标签。
- 证据与状态：报告保留120000对ADC输入滤波比对、10000对连续真实CNN窗口的9,280,000个输出对照等证据；调度占用约52.59%。证据[S02]。这是功能和吞吐验证，模型质量资格仍为false。
- 纠错点：滤波抑制、CNN额外收益和全速锁相收益分别统计；低速链不能宣称0～30MHz宽带AI。

### 记录 #47　AI 多轮强化出现退化：不以中位收益掩盖最差失真

- 日期/阶段：2026-10-12～10-15 · 合成训练、量化及独立复验。
- 问题：部分训练改善平均降噪，但弱分量相位偏差或最差窗口退化超限，不能因曲线变平滑就发布。
- Prompt（复盘要点）：冻结训练候选，在新种子独立验证中同时考察收益、最差退化、干净保真和带噪弱音幅相。
- 辅助建议/处理：保留失败检查点、逐组指标和拒绝原因；手动实验结果与可信测量分开。v6的MCU高输入电平共同回退RAW，仅保护MCU选中结果，不能认为当前FPGA原始CNN导出自动受同样保护。
- 证据与状态：v6未保护候选追加测试出现最高0.2631°新增弱分量相位偏差，超过该测试0.1°门槛。10月15日独立频域GroupDRO/PCGrad候选混合中位收益约0.744/0.856dB，但最差约−1.592/−3.018dB，均未通过本轮全部门槛、未部署；该频域研究模型不等同活动时域CNN。证据[S03、S04]。
- 纠错点：最新顶层`cfg_ai_qualified=0`；AUTO保持RAW。CNN数值一致性PASS不等于降噪达标，保护性回退也不是CNN消除了噪声。[S18]

### 记录 #48　SPI 边沿复核、MISO 修订及混入 C 头文件的语法错误

- 日期/阶段：2026-10-15 · 历史FPGA/STM32链路审计。
- 问题：需区分实际首位错位与源码语法损坏，且旧MISO引脚说明可能误导接线。
- Prompt（复盘要点）：按实际Mode0收发边沿检查地址后首位、连续字、短事务取消、复位和快照，不凭注释改逻辑。
- 辅助建议/处理：移除`default_nettype wire`末尾误混入的C include；核实A0读/A1写、8位地址、32位大端字，无额外dummy字节。后续MISO为W2，不照搬旧U3。
- 证据与状态：50种RTL时序组合通过，覆盖约656kHz、1.3125MHz和2MHz等条件；当轮未生成新bit、未证明真实接线和当前固件链路稳定。证据[S05]。
- 纠错点：全设计WNS通过不等于外部SPI采样裕量已实测；身份字不符和串口乱码不能单独定位为SPI边沿故障。

### 记录 #49　除法器补零丢商位：FFT 插值通过综合仍可能算错

- 日期/阶段：2026-10-17 · 公共算术与回归脚本修复。
- 问题：`fixed_divider_generic`迭代时错误补0而未移入当前商位，导致FFT非整数bin插值失效；PowerShell哈希阶段另有误报。
- Prompt（复盘要点）：用独立整数算术参考覆盖实际使用位宽，并检查数值、延迟、握手和复位。
- 辅助建议/处理：每轮移入当前`q_bit`；修正哈希脚本，补齐48/48、64/64、64/32三种位宽回归。
- 证据与状态：411组除法器向量及Divider/ADC/FFT/UART/CNN五项套件通过。非整频点bin123.25测试修复后误差约833/836Hz，满足原0.2bin容差，并非零误差或1Hz精度。该次修复报告明确当轮没有生成新bit；后来构建成果另见#57、#60。证据[S01]。
- 纠错点：模块能综合、输出有valid，仍不保证数值正确；旧bit与新源码不可拼为一次验收。

### 记录 #50　基础版独立收敛：修复触发快照覆盖与 UART 整链路

- 日期/阶段：2026-10-17 · 基础采集候选。
- 问题：持续覆盖的全速环形RAM若被慢速复制，可能形成无效或撕裂快照；“界面隐藏FFT/CNN”也不等于资源回收。
- Prompt（复盘要点）：建立可独立验证的双通道基础采集版，逐点检查触发窗口和物理UART数据。
- 辅助建议/处理：采集时在线形成显示样点，保存1024点双通道窗口；真实触发后补齐后触发区，提交后由UART独占读取。修正指针、读延迟、负数平均、配置锁存和握手。
- 证据与状态：旧版同接口测试先失败，修正版28帧逐点通过；ADC至物理UART仿真1024对样点一致。独立基础版布局布线LUT689、FF591、BRAM36等效1、DSP0，CNN/FFT/lock-in实例均为0；该版本当轮未上板。证据[S06]。
- 纠错点：基础版、完整AI_V32与RAW4096诊断版分别记录资源、协议、bit和验证结果。

### 记录 #51　锁相结果原子发布、比例无效与工程注册漂移

- 日期/阶段：2026-10-17 · 基础平台加入幅相测量。
- 问题：幅度、相位和除法结果不同拍更新可能混成一笔；零分母若替换成1会输出伪有效比例；旧Vivado GUI保存还会覆盖离线修复后的文件列表。
- Prompt（复盘要点）：保证整笔幅相原子发布，故障立即撤销有效性，并让工程文件注册与当前GUI状态一致。
- 辅助建议/处理：先锁存，再等比值除法完成后同拍发布；零分母/比例溢出置无效；补mid/age/mv/rv与故障原因。提供幂等注册脚本和固定引用自身RTL/XDC的独立验证工程。
- 证据与状态：10kHz、幅度比0.5、相差60°数字整链路仿真，后段比例约0.49965～0.49968、相差约59.996～60.007°。布局布线LUT5873、FF4847、BRAM36等效2.5、DSP8，WNS/WHS为+1.410/+0.049ns。证据[S07]，不代表模拟前端已校准。
- 纠错点：根目录XPR、GUI缓存、独立发布工程与bit可能不是同一版本；`qual`是检测保护状态，不是准确度证书。

### 记录 #52　高频 RAW 显示纠正：平均和抽取不能靠调横轴补回

- 日期/阶段：2026-10-18 · 高频显示V4。
- 问题：R16平均后20MHz会显著衰减并混叠，三角折线或低幅不能直接归咎ADC失真。
- Prompt（复盘要点）：分清65MSPS原始窗口与显示平均窗口，按板卡原理图核对按键/LED，并做全链路检查。
- 辅助建议/处理：候选版默认R1/F0原生RAW；RAW与R16等视图清楚标识，按实际引脚修正控制。VOFA时间间隔按帧内采样率设置，不把接收时间当采样时间。
- 证据与状态：此前运行V3的350kHz现场20帧可解码；新V4的1/20MHz、1024对样点是仿真，综合布线和bit已完成，当轮未下载。R16对20MHz理论幅度约−34.81dB，输出混叠约312.5kHz。证据[S08]。
- 纠错点：调Δt不能恢复被滤掉的信息；20mVpp若只占数个ADC码，数字放大不增加原始分辨信息。

### 记录 #53　30 MHz 局部 AFC：从手工微调参考到约±2 kHz自动跟踪

- 日期/阶段：2026-10-19 · 已知频率附近单主分量测量。
- 问题：固定参考与实际载频有小频差时，长积分会衰减或失效；不能为每次频偏预写一个“碰巧正确”的参考常量。
- Prompt（复盘要点）：保持全速RAW和原guard门限，用真实时间戳及双路一致性估计小频偏，连续相位更新NCO。
- 辅助建议/处理：全速混频后4096点短窗，16个相位增量估计频偏；CH0引导共享参考，CH1检查强度与频偏一致；局部捕获约±2kHz，限幅/死区，失锁、异频、断流或无信号不发布可信幅相。
- 证据与状态：候选bit文件SHA256为`501278920777f9a2c99f5339465af96627e86a1f32b9e7bf8562c1c00f36ce7f`；WNS/WHS为+1.410/+0.034ns。随后阶段报告记载6组577个完整观察帧：有信号529个两路合格，关闭输出48个无合格；30MHz、源设置20mVpp约一分钟308帧，相位差短时标准差约0.124°，并有恢复和±1kHz回程证据。[S09、S10]
- 纠错点：这支持已知频率附近的阶段功能，不是全频段捕获率、长期误检率或绝对相位误差0.124°。下载由用户确认，文件哈希不等于硬件读回；协议标签不一致见本稿“待核对事项”。

### 记录 #54　幅度往返测量：暴露约0.93°幅度相关相移

- 日期/阶段：2026-10-19 · 30MHz、固定路径100→50→20→50→100mVpp。
- 问题：同源测量在低幅度下相位均值变化，不能用短时稳定性掩盖系统偏差，也不能未经定位写死补偿。
- Prompt（复盘要点）：固定连接和负载做幅度往返，每组保留原始串口、完整有效帧及坏帧。
- 辅助建议/处理：每组约60秒，独立统计两路峰值counts、幅度比、相位圆周统计和回程差。
- 证据与状态：五组共1537个完整有效帧；20mVpp相位差19.60746°、短时标准差0.11736°，相对两次50mVpp均值高约0.9335°。100mVpp回程相位约−0.0732°；同时保留9个不完整/损坏块，其中5个结束尾帧、4个中途损坏。证据[S11]。
- 纠错点：源设置值不是模块连接器实测电压；counts比例不能直接认证绝对电压/线性度；有限有效帧统计不能吞掉损坏记录。

### 记录 #55　RAW 拟合交叉检查与静默串口接收：分离估计偏差和链路损坏

- 日期/阶段：2026-10-19 · 串口/测量交叉审查。
- 问题：先前五组存在中途文本损坏；幅度相关相移也需确认是否只有实时锁相输出存在。
- Prompt（复盘要点）：先保留原始字节，不边接收边逐条打印；RAW独立找频拟合后与实时锁相组均值比较。
- 辅助建议/处理：增加静默接收与驱动错误可见性；原五组只对完整、状态有效RAW窗口独立拟合，不把AFC频率当固定真值。
- 证据与状态：不改bit复测100/50mVpp各60秒，各309个完整有效帧，无中途文本损坏、各有自然尾帧；仍报告CE_FRAME/CE_BREAK类驱动错误，不能宣布物理问题消失。RAW与实时组均值最大幅度差约0.056%、最大相位差约0.026°；RAW也出现约0.894°低幅度偏移。[S12]
- 纠错点：排除了“只有锁相结果计算造成整段相移”的解释，未定位源/前端/ADC/时序；窗口不同，不是逐样点同窗或绝对误差验收。

### 记录 #56　V32CAP3 真实归档取帧：从样例文件到可复用 Linux 解码

- 日期/阶段：2026-10-17～10-19 · 数据接口整理。
- 问题：FireWater文本、旧低速数据、RAW4096二进制及触发增强版混用，会出现“有样例却读不出板上数据”。
- Prompt（复盘要点）：从`sampling_archive_20261016_220040.zip`恢复准确布局，用原始字节、CRC、NPY和帧SHA256核对。
- 辅助建议/处理：固定V32CAP3：8字节魔数＋32字节元数据＋16384字节交错双路signed16＋4字节CRC，总16428字节，多字节小端。提供Linux/UART接收参考与真实单帧样例。
- 证据与状态：归档50帧、409600个通道采样值逐点一致；随机拆包、CRC损坏后恢复、回绕、重复/重叠与截断测试通过。样例帧124、首点计数1417389169、CRC=0x5E19F53F。证据[S13]，本次整理未连接Linux硬件。
- 纠错点：每帧4096点内部连续，帧间有间隔；nominal921600/8N1理想约5.6帧/s；不能拼接为连续65MSPS。真实归档属于先前采集，不等于新固件已联调。

### 记录 #57　单一源码构建迁移：时序回归不等于原设计固有缺陷

- 日期/阶段：2026-10-18 · AI_V32工程治理。
- 问题：74项文件迁移对账后，重建仍出现布线WNS−13.974ns、822个建立违例，不能据“源码一致”推导实现逐位一致。
- Prompt（复盘要点）：对比迁移前后真实布线报告、约束读取顺序与实现选项，逐项隔离回归。
- 辅助建议/处理：以`rtl/`＋`ip/`＋`build.tcl`建立源码入口；base_clocks设EARLY、ADC约束设LATE；恢复post-route AggressiveExplore物理优化处理高扇出复位。异构增量DCP引发工具崩溃，默认关闭，不把它归因power_opt本身。
- 证据与状态：修复后报告WNS+1.361ns、WHS+0.034ns，0违例并出bit。迁移前归档WNS+1.410ns。证据[S14]。输入多周期约束必须有真实接口时序依据；STA通过仍不等于板级模拟认证。
- 纠错点：旧路径消失可能是源码迁移；应先读最新目录说明。不要把综合悲观值、迁移回归或不同变体报告混成一次结果。

### 记录 #58　Linux 显示原型：原始点、带限插值和模型曲线分开标注

- 日期/阶段：2026-10-18～10-19 · 离线波形显示与交接。
- 问题：30MHz在65MSPS下每周期约2.17点，折线有棱角；“有限含噪数据唯一恢复完美波形”“标称13点周期保证零泄漏”等说法缺少前提。
- Prompt（复盘要点）：使用实际保存的RAW帧制作Linux/PC可审阅显示，始终保留原始采样，明确插值和单音模型的假设。
- 辅助建议/处理：逐帧多相FIR×20、边缘裁剪、局部共享频率单音拟合；不跨帧拼接、不把插值点重新当高精度测量数据；模型不能掩盖多音、谐波或断流。
- 证据与状态：离线HTML原型接受20个实测快照、拒绝尾部不完整帧；指定合成量化测试插值RMS约0.28～0.30counts。主机耗时不是嵌入式性能，尚未部署RK3506及屏幕。[S15]
- 纠错点：实际约30.0012MHz，不保证13点精确重复；1024点也不是13点周期整数倍。插值不提高ADC采样率/实时带宽，模拟抗混叠与实际板端帧率仍需验证。

### 记录 #59　SPI 屏显协议总结：寄存器事务不等于波形数据包

- 日期/阶段：2026-10-18 · Linux—FPGA通信方案。
- 问题：从归档提取V32CAP3样例后，容易误认为直接改成SPI读取即可完成显示与参数下发。
- Prompt（复盘要点）：分清SPI命令、寄存器、缓存握手和应用数据，列出Linux与FPGA各自必须实现的部分。
- 辅助建议/处理：保留A0/A1大端寄存器语义；RAW4096建议新增锁帧、描述符、偏移选择、512字节分块窗口、CRC与带令牌释放。V32CAP3字节流仍小端，不能重复换序。屏幕渲染与数据读取分线程，配置走影子值→提交→生效确认。
- 证据与状态：已形成通信设计草案与带宽预算，扩展寄存器地址/ABI未冻结、无新SPI屏显固件。历史656.25kHz约5帧/s纯波形理论上限；20帧/s净载荷约2.63Mbit/s，旧低速接口不够。证据[S16]。
- 纠错点：10月18日草案按RK3568＋7英寸1024×600MIPI规划；10月19日新交接目标为RK3506/UART。两条方案并列记录，不能混用开发板引脚、设备节点与驱动。

### 记录 #60　独立 V32CAP3 上传口集成：AB5 二进制、AB6 文本

- 日期/阶段：2026-10-19 · 基础版和AI_V32上传端构建。
- 问题：Linux显示需要稳定独立的原始窗口接口；同名`uart_tx`会与现有模块冲突，早期交接说明还出现AA5/AB5文字不一致。
- Prompt（复盘要点）：以固定帧布局增加独立二进制TX口，保留原VOFA文本口，验证字节和实际引脚落点。
- 辅助建议/处理：新增`v32cap3_tx`与改名后的`uart_tx_v32`；4096点/通道、CRC32、nominal921600/8N1；最终`v32_tx=AB5`，VOFA仍为AB6。以最终XDC、布线审计为准，不以旧正文AA5为准。
- 证据与状态：2帧32856字节仿真检查通过；AI_V32构建报告WNS/WHS+1.410/+0.053ns、LUT16982/20800、FF13467/41600、BRAM34/50、DSP58/90，黑盒0。发布bit SHA256 `adb0f521a1648900f03053644dfee8d1f328d2146ab157ca1902eb3f41edd9e8`。[S17、S18]
- 纠错点：这是新增口的仿真、实现和bit生成记录，本轮未证明RK3506已实时显示；现有离线viewer仍接收META文本帧，不能默认已经接好V32CAP3适配。独立口只有TX，不自动支持参数下发。

### 记录 #61　自动找频与测量带宽分离：混频后的抽取不能按载频选

- 日期/阶段：2026-10-19 · 基础候选单bit搜索与带宽控制。
- 问题：原“载频越高就固定短积分”的自动档位设计错误：目标信号经正交混频已在基带，载频不直接决定积分带宽。
- Prompt（复盘要点）：将找频、AFC跟踪、测量ENBW与显示时基分成独立控制量，弱信号也应有机会进入窄带长积分。
- 辅助建议/处理：候选meas_bw_ctrl按存在、锁定及无大阶跃逐级从约1ms→4ms→64ms积分；阶跃立即回退，持续失锁单独去抖；切档后有settling无效窗口。显示自动时基另管。
- 证据与状态：代码及仿真记录包含11项带宽控制检查；200Hz～32.4MHz是搜索设计目标，不是已验证测量频带，相关整带宽上板未完成。ENBW及理论噪声收益是计算，不是板测。证据[S19、S20]。
- 纠错点：保持ADC65MSPS；RAW显示抽取仍是boxcar，不因参数叫AA_ORDER就成为合格抗混叠。多次构建已替换同名产物，必须绑定各自hash，不能把早期失效bit当最新发布。

### 记录 #62　4096/8192 点 FFT 对照：省 BRAM 不等于满足弱信号找频

- 日期/阶段：2026-10-19 · 独立FFT子系统比较。
- 问题：想缩短FFT以给CNN让资源，但不能只比较存储而忽略定点动态范围、插值误差和AFC捕获条件。
- Prompt（复盘要点）：同配置分别构建4096/8192点，检查窗ROM实际初始化，用供应商位精确模型比较弱信号候选落入±2kHz范围的比例。
- 辅助建议/处理：双通道共享核、同输入/窗口和量化尺度；拒绝未加载窗ROM的初轮构建，不把软件改进成功率拼接到未改硬件的资源表。
- 证据与状态：子系统4096/8192分别LUT1873/1978、FF2537/2589、BRAM36等效9.5/19、DSP均13；20mVpp标签无偏置单音逐通道候选通过率53.1%/81.0%，均为合成实验，不是板卡成功率。该对照默认保留8192；OOC虚拟输入保持违例未隐藏、未出新bit。[S21]
- 纠错点：另一移植分支已有4096点自研FFT粗找频候选和位宽修复记录[S22]，不等于上述XFFT对照已部署；两条架构、资源和精度结果分别记录。

### 记录 #63　等效时间显示与 signed 移位：平滑波形必须有真实相位覆盖

- 日期/阶段：2026-10-19 · ET候选显示与回归。
- 问题：把重复信号分到64个相位bin，并不保证每个bin都有真实样点；EMA中无符号拼接还可能使算术右移变成逻辑右移，纯单极性测试却掩盖缺陷。
- Prompt（复盘要点）：报告每bin命中和实际覆盖率，覆盖锁定/配置切换/冻结及符号翻转；不得把空bin插值说成真实采样。
- 辅助建议/处理：样本与NCO相位配对，明确有符号扩展，增加单bin交替±A回归；重复信号显示不提高单次实时采样带宽、不恢复前端已滤掉的谐波。
- 证据与状态：候选报告记载6个单元场景、ET独立bit和时序通过；另发现`et_integrity_fix_20261019`正在形成隔离目录，本轮未见其完整结项报告。因此这里只记录既有候选和已发现缺陷，不宣布完整ET正确性/界面/板级验收完成。[S23、S24]
- 纠错点：nominal30MHz/65MSPS下相干关系仅提供有限相位位置；实际频偏会改变覆盖。proto应按明确字段集合解码，不能仅凭“版本号更大”推断所有可选字段都存在。

### 记录 #64　LLM 记录自身的证据治理：把建议、实现、实验和认证分开

- 日期/阶段：2026-10-19 · 本次初稿修订。
- 问题：旧稿将部分数学推导、综合通过、有限仿真、预测指标写得接近“已实测”；不同分支还共享相似文件名，容易追错版本。
- Prompt（复盘要点）：根据近期修改完善LLM辅助优化记录，保留失败、纠错和未完成项，不把AI降噪或Linux屏显写成已完成。
- 辅助建议/处理：备份本轮合并前的44条输入稿；修正项目简介、器件资源和早期抗混叠/吞吐措辞；保留#1～#44及其并发补充，新增#45～#64、状态矩阵、资源口径、证据链接、待核对事项及执行清单。
- 证据与状态：本次只修订文档并读取既有记录，不修改RTL、权重、工程、原始采样或bit，不启动训练/构建/板测。备份与来源SHA256清单随本次交付保存。
- 纠错点：Prompt归纳不是原始聊天转录，模型建议不是因果证明；历史报告PASS只在其版本、测试和条件内成立。

## 三、按构建区分的资源与验证口径

器件为XC7A35T-FGG484-2：LUT20800、FF41600、DSP90、BRAM36等效50。RAMB18可与RAMB36换算，不能写“RAMB18总量0”。以下均为各自报告，不混称同一最新版。

| 构建/用途 | LUT | FF | BRAM36等效 | DSP | 验证边界 |
|---|---:|---:|---:|---:|---|
| 10/17独立基础采集 | 689 | 591 | 1 | 0 | 数字仿真/实现；无FFT/CNN/lock-in |
| 10/17基础锁相修复 | 5873 | 4847 | 2.5 | 8 | 完整幅相数字链仿真与实现；当轮未下载 |
| 10/19局部AFC候选 | 9095 | 7061 | 2.5 | 17 | 有后续阶段板测；文件与现场身份需分别说明 |
| 10/19 AI_V32＋V32CAP3 | 16982 | 13467 | 34 | 58 | 完整构建/静态时序及上传口仿真；无新增Linux实测 |
| 4096点XFFT子系统对照 | 1873 | 2537 | 9.5 | 13 | OOC资源比较，非整机，不是时序合格下载工程 |
| 8192点XFFT子系统对照 | 1978 | 2589 | 19 | 13 | 同上；不与自研4096 finder混用 |

初稿旧资源预算中LUT41600、FF83200不适用于本XC7A35T，已由本表替换；估算与实现报告不再并列当成实测基线。

## 四、截至本次修订的路线与待办

1. **先冻结在用构建。** 明确基础版/AI_V32、局部AFC/全频搜索/FFT/ET、UART文本/二进制各分支；发布名、generic、hash和协议字段绑定，不能只凭build日期判版本。
2. **巩固已有板测链。** 保留30MHz局部AFC原始字节与幅度往返结果；处理物理串口错误、查明约0.9～1°幅度相关相移，完成独立输入电压与通道幅相校准。
3. **打通Linux实时显示。** 最新交接以RK3506独立V32CAP3 UART入口为候选；先核对I/O电压、AB5和实际RX，再做身份/帧头、CRC、样点和持续接收。文本离线viewer需要适配二进制入口，不把“有HTML”写成“屏已部署”。
4. **SPI作为后续双向/提速方案。** 先冻结寄存器与ABI，再做Linux读写、锁帧分块、配置生效确认；旧RK3568/MIPI目标若继续采用，应重新确定实际板卡，不套RK3506引脚。
5. **扩大测量范围需单独验收。** 全频搜索、FFT找频及自动测量带宽先做版本一致的仿真与实现，再做不同频率/幅度/偏置/干扰的板级验证；200Hz～32.4MHz仍为设计范围。
6. **ET只作为独立候选。** 完成相位标签、空bin、命中统计、复位/失锁/配置切换和完整性复验；结束前不把平滑显示作为测量证据。
7. **AI保留实验资格。** 用可信实测数据建立冻结训练/开发/独立测试分组，报告纯带内、白/有色噪声、最差退化和弱音幅相；不靠降门槛或回退比例“通过”，不以预测作真值。
8. **最后形成参赛闭环。** 实际设备演示、固件/程序可复现、原始数据/日志/失败样本和LLM原始提问归档。赛事要求以正式通知核实；旧稿的主观评分不作客观结论。

## 五、待核对事项与避免误用的表述

- **协议标签冲突：** 局部AFC交付文档后续写proto=5，而阶段板测记录记proto=2，且都引用同一bit文件hash。两者原文都保留为来源，当前不能只凭这些文字断言实际现场字段版本；后续以每次原始字节、构建清单和字段集合核实，不为消除矛盾而改写旧记录。
- **ET可选字段冲突：** 既有报告同时给出`5+fft_present+2*et_present`和“proto≥6必有ffs”等描述；仅ET时proto=7并不必然含FFT字段。按实际能力/字段存在性和精确版本表解析，不采用该数值大小推断。
- **引脚旧文冲突：** V32CAP3候选README仍留AA5旧文字；最终AI_V32 XDC及基础版布线审计均为AB5。接线依据选定bit的约束与物理审计，而非旧说明段落。
- **平台名称变化：** 10月18日方案为RK3568＋MIPI；10月19日上传口/显示交接改称RK3506。两者不能视为同一套已部署Linux系统。
- **抗混叠和精确重建：** 高于输入奈奎斯特的成分、前端带宽与抗混叠未认证，有限含噪快照不能保证唯一、完美恢复模拟波形；算法拟合曲线必须标注。
- **模型与数字资格：** AI实现正确、guard合格、局部AFC稳定、WNS非负，各自不等于降噪质量或绝对测量精度已认证。
- **来源不可变性：** 本稿记录的是本轮核对到的报告快照。活动目录可能继续有其他开发修改，后续引用要再核对SHA256，不把本稿当作持续实时状态。

- **旧位流路径变化：** 本轮读取时，局部AFC阶段报告引用的`release/base_30m_local_afc.bit`原路径已不存在；hash来自阶段记录，不作为本轮现存文件复核。AI_V32上传口发布文件仍存在，已实际核对SHA256与构建报告一致。若要恢复阶段实验，先在对应归档中寻找并验hash，不能用同名后续产物替代。

## 六、来源索引

下列来源对应本次只读检查；文件hash另存于本次修订来源清单。前序#1～#44没有在本轮逐项复跑，因此标为历史记录。

- [S01] [10/17 除法器与五项套件修复报告](（私有证据：signal_analyzer_AI_V32/archive/fix_20261017/修复与复验报告.md)
- [S02] [双通道低速CNN实施与复验](（私有记录：V32_双通道低速CNN_实施与复验报告_20261012.md，未随仓库发布）)
- [S03] [v6强化训练与范围保护](（私有记录：V32_v6_强化训练与范围保护_20261014.md，未随仓库发布）)
- [S04] [GroupDRO/PCGrad独立复验](（私有记录：V32_GroupDRO_PCGrad_继续强化与独立复验_20261015.md，未随仓库发布）)
- [S05] [SPI专项复核](（私有记录：V32_FPGA_SPI_时序复核_20261015.md，未随仓库发布）)
- [S06] [基础采集候选复核](（私有记录：V32基础采集显示_复核与下载_20261017.md，未随仓库发布）)
- [S07] [基础版锁相与工程注册修复](（私有记录：V32_缺模块与幅相修复_20261017.md，未随仓库发布）)
- [S08] [RAW高频显示与弱信号处理](（私有记录：V32_RAW高频显示与弱信号处理_20261018.md，未随仓库发布）)
- [S09] [局部AFC候选交付](（私有证据：signal_analyzer_base_v1/local_afc_fix_20261019/交付报告.md)
- [S10] [局部AFC阶段板测](（私有证据：signal_analyzer_base_v1/measurement_20261019/局部自动跟踪_上板阶段验收_20261019.md)
- [S11] [幅度往返实测汇总](（私有证据：signal_analyzer_base_v1/measurement_20261019/amplitude_roundtrip_result_01/幅度往返实测汇总.md)
- [S12] [串口与RAW交叉检查](（私有证据：signal_analyzer_base_v1/serial_raw_review_20261019/串口与RAW交叉检查报告.md)
- [S13] [真实归档50帧逐点验证](（私有记录：verification_report.json，未随仓库发布）)
- [S14] [AI_V32单一源码与时序回归修复](（私有证据：signal_analyzer_AI_V32/docs/timing_regression_20261018.md)
- [S15] [Linux离线显示原型及边界](（私有证据：signal_analyzer_base_v1/linux_wave_viewer/README.md)
- [S16] [Linux—FPGA SPI屏显通信草案](（私有记录：Linux与FPGA屏幕显示通信方案.md，未随仓库发布）)
- [S17] [AI_V32新增V32CAP3构建报告](（私有证据：signal_analyzer_AI_V32/docs/AI_V32_V32CAP3_构建与验收_20261019.md)
- [S18] [本轮核对的AI_V32活动顶层](（私有证据：signal_analyzer_AI_V32/rtl/imports/rtl/daq_top.v)
- [S19] [测量带宽控制纠正](（私有证据：signal_analyzer_base_v1/local_afc_fix_20261019/reports/meas_bandwidth_20261019.md)
- [S20] [全频搜索候选及历史版本失效说明](（私有证据：signal_analyzer_base_v1/local_afc_fix_20261019/reports/fullband_scan_20261019.md)
- [S21] [4096/8192点FFT同口径对照](（私有证据：signal_analyzer_base_v1/fft_compare_20261019/4096与8192对照报告.md)
- [S22] [另一路4096 finder移植记录](（私有证据：signal_analyzer_base_v1/local_afc_fix_20261019/reports/fft_finder_port_20261019.md)
- [S23] [ET候选与signed移位回归](（私有证据：signal_analyzer_base_v1/local_afc_fix_20261019/reports/et_display_20261019.md)
- [S24] [ET完整性隔离目录输入清单（非结项）](（私有证据：signal_analyzer_base_v1/et_integrity_fix_20261019/input_manifest.json)
- [S25] [基础版最终V32CAP3引脚审计](（私有证据：signal_analyzer_base_v1/v32cap3_tx_20261019/reports/build_audit.txt)
- [S26] [AI_V32最终V32CAP3引脚约束](（私有证据：signal_analyzer_AI_V32/rtl/xdc/v32cap3_uart.xdc)
- [S27] [AI_V32构建入口与迁移说明](（私有证据：signal_analyzer_AI_V32/README.md)

## 七、2026-10-23 补充：Y4／AA4 扩展后的停显、发送调度修复与链路排查

本节补充10月22日至23日的代码检查、仿真与实机记录；前文“截至10月19日”内容保留历史语境，不作为当前实时状态。Prompt为对话要点归纳，不冒充逐字记录。

### 记录 #65　Y4／AA4 扩展后“烧录短暂有波形、随后停住”：分离调度缺陷与物理链路故障

- 日期/阶段：2026-10-22～23 · Linux屏串口扩展、二进制波形/频谱复用与实机排查。
- 用户现象：新增Y4发送、AA4接收后，Linux屏在下载bit后短暂显示正常波形，随后停止更新。用户明确说明屏幕曾显示正常波形，因此不能只用“烧录毛刺”解释该历史现象。
- Prompt（归纳）：扩展Y4后开始出现停发；要求边烧录边抓取、重查代码、判断是否资源不足，随后恢复AB5发送/AA5接收并复测。

**已确认的代码缺陷与修复**

1. 旧候选`3b980d3de61e`把“频谱快照尚未准备好”也加入波形暂停条件，可能造成波形采集/输出长时间等待。不能仅凭该条件就断言存在无条件、必现的循环等待，因为频谱采集另有运行路径。
2. 中间候选`5a6ea77f8028`仍存在帧边界竞争：完成计数只在交接时更新，晚到的频谱快照可能用陈旧完成事件在下一帧波形发送中途抢走TX；暂停信号晚一拍，又可能让下一帧波形在频谱占用TX时继续运行，形成截帧、CRC错误和显示失步。
3. `ab5_frame_sequencer.v`改为每拍跟踪波形完成计数，只在检测到新完成事件且频谱快照就绪时交接；交接当拍组合暂停下一帧采集，等待物理停止位结束后切换TX；频谱启动未应答有超时退回。
4. 顶层保留单接收路径，去掉双RX争用；最终恢复AB5 TX、AA5 RX时继续保留帧切换修复。Linux解析器同时修正合法抽取比范围，接收默认速率改为2 Mbaud。

**版本与物理实现证据**

| 候选 | 接口/状态 | 本次可支持的结论 |
|---|---|---|
| `3b980d3de61e` | 扩展Y4／AA4的双串口阶段 | 存在上述暂停条件缺陷 |
| `5a6ea77f8028` | 单Y4／AA4、中间修复 | 仍有帧切换竞争，不能作为最终修复结论 |
| `0e484a2f6a9b` | 单Y4 TX／AA4 RX，帧边界修复 | 仿真通过；不能据此宣称历史停显已全部解决 |
| `37b7fcdfc4b3` | AB5 TX／AA5 RX，保留修复 | 已烧录，JTAG回读USR_ACCESS=`37b7fcdf`、DONE=1；WNS=0.393ns、WHS=0.015ns、DRC错误0 |

新候选LUT约97.8%、DSP 84/90，资源余量较小；资源占用高是后续工程风险，但不是本次运行停发的已证实原因。FPGA资源不是运行过程中逐渐耗尽的内存池，不能把高占用直接写成“死锁根因”。

**验证与推翻过的判断**

- 2026-10-23重新执行帧所有权回归：重复交接、晚到快照、无快照、启动不应答等用例通过；65MHz/2Mbaud、1024点波形及2048频谱bin的实际长度仿真获得4个波形、4个测量、3个频谱完整帧，CRC通过，无后台隐藏波形周期。末尾不完整帧单列，未算有效帧。Linux协议13项单元测试通过。这些是仿真/软件测试，不替代实机。
- 正式AB5固件边烧录边抓取约60秒，烧录完成后继续抓35秒：COM9共收到4,968,554字节、272条META，烧录后仍输出；COM12全过程0字节。本轮没有复现COM12的有效波形“仅烧录瞬间出现”，不能据此否定历史屏显现象。
- 独立UART诊断bit绕过ADC、FFT和帧调度，从50MHz晶振直接驱动UART，同时输出Y4、AB5、AB6。COM9收到1,593次完整`LNKPROBE`；COM12只有一个`00`，没有完整文本。测试后恢复正式`37b7fcdf`并回读确认。这表明当时COM12不通并不依赖生产采集代码，但不能单独区分适配器、接线或引脚电气问题。
- COM12为`VID_C251/PID_F001`、设备描述`CMSIS-DAP CDC`。回环接法曾产生歧义：用户最初短接的是FPGA的AA5与AB5，不能据此判断适配器故障，该次归因已撤回。用户随后确认改为适配器自身TXD/RXD短接后，COM12在115200、921600和2Mbaud仍均发送超时、接收0字节；只能定位到该设备/配置/连接链路，不能无依据宣称硬件损坏。
- 后换COM3（CH340），适配器自身回环三档速率均267/267字节完全一致；证明短数据基本收发正常，不等于持续2Mbaud可靠性通过。
- COM3接回AB5/AA5后持续数据恢复：12秒固定R=1测试140个有效波形，329次CRC错误、81个帧缺口事件；两路有效波形频率约1.00005MHz。I/Q模式8秒收到380个有效帧，仍有114次CRC错误、88个缺口事件，之后能切回波形模式。另一次10秒只存原始数据后离线审计，仍有281次CRC错误，并捕获Windows错误标志2（`CE_OVERRUN`）。CH340在该条件下存在接收溢出；不据此断言所有错误都来自适配器。
- 原理图纠正了LED误判：板上用户LED为高电平点亮，当前RTL却取反输出；用户报告LED1、LED2、LED5亮，与配置完成、电源正常及当前代码无采集错误的状态相容，不能再据此说ADC未就绪。指示灯极性问题与串口停显根因分开记录。

**屏幕恢复及最后一轮测试的范围**

用户随后将串口接回Linux屏，确认屏幕已有数据，但屏幕未连接电脑，也未提供可访问的SSH/原始日志。按用户要求将AA5通信正常作为前提，继续发生器到ADC的实测；没有把该前提提升为已验证事实。

通过COM9文本波形观测：BPSK 2000 Bd持续30秒，149个完整1024点波形；2FSK 2000 Bd、QPSK 2000 Bd、OOK 1000 Bd各12秒，分别59、59、60个完整波形。源设置回读均符合要求，完整波形采集故障标志均0。OOK低/高峰峰值分位数约6/211计数，比值2.84%，支持导通/截止电平存在。本轮没有AB5原始I/Q、CRC或屏端符号判决数据，不能把输入波形响应当作数字解调通过；“宽档”标签也不代表已向屏端/FPGA下发对应带宽配置。测试后发生器完整设置恢复，逐字段回读差异为零。

**最终结论及待完成项**

- 可以确认：旧版发送调度存在实质缺陷，已修改并通过针对性仿真；AB5/AA5新版能持续采样输出并响应模式命令；排查中还独立发现接线脱落、CDC链路不通和CH340持续高速接收溢出。
- 尚不能确认：Y4/AA4引脚本身导致死锁，或资源不足是根因。此前单独诊断曾在正确连接的适配器上验证Y4/AA4收发，因此不应将引脚改名作为根因修复证据。
- 历史“烧录后短暂正常、随后停住”的完整因果尚未单一闭环。换回AB5/AA5时，固件逻辑、适配器和物理连接同时发生变化，不能把恢复仅归功于换引脚。
- 仍需验收：Linux屏至少120秒持续收帧的CRC/帧序/停显记录；此前未通过的宽档BPSK 2000 Bd连续I/Q完整性、已知码型及EVM。合成BPSK测试虽再次通过，不能抵消实机传输错误。
- LLM纠错经验：先区分“没有字节”“有字节但CRC坏”“解析正常但界面停显”；保留失败数据和接法更正；0字节的0 CRC错误不是通过；独立诊断和同步烧录抓取比反复猜测资源不足更能缩小范围。

**本节证据索引（项目根目录：`（私有证据：signal_analyzer_base_v1`）**

- [帧调度RTL](（私有证据：signal_analyzer_base_v1/firmware/rtl/ab5_frame_sequencer.v)、[帧所有权回归](（私有证据：signal_analyzer_base_v1/firmware/reports/uart_frame_ownership_validation.json)。
- [AB5构建、时序及身份](（私有证据：signal_analyzer_base_v1/firmware/reports/ab5_restore_build_current.json)。bit SHA256：`d6cb6e56715710a1d34056d6cd91f5b8aa86c5442b76d049ff15822a211d8221`。
- [边烧录边抓取结果](（私有证据：signal_analyzer_base_v1/firmware/reports/ab5_program_capture_20261023_162809/summary.json)。
- [独立诊断与COM12排查结论](（私有证据：signal_analyzer_base_v1/firmware/reports/link_probe_compare_20261023_163021/检测结论.md)。
- [正确适配器短接后的COM12记录](（私有证据：signal_analyzer_base_v1/firmware/reports/adapter_loopback_20261023_164614/summary.json)、[COM3回环](（私有证据：signal_analyzer_base_v1/firmware/reports/adapter_loopback_20261023_165011/com3_summary.json)。
- [COM3实机传输](（私有证据：signal_analyzer_base_v1/firmware/reports/com3_board_test_20261023_165407/summary.json)、[独立原始抓取与溢出标志](（私有证据：signal_analyzer_base_v1/firmware/reports/com3_board_test_20261023_165407/raw_only_summary.json)。
- [屏幕保持连接时的发生器输入实测](（私有证据：signal_analyzer_base_v1/firmware/reports/screen_connected_source_test_20261023_172051/本轮实测结论.md)。

### 记录 #66　调制波形显示与手动制式选择：明确Linux屏控制能力及AI交接

- 日期：2026-10-23。
- 用户问题：是否必须手动选择才能显示调制波，如何让其他AI了解，能否由Linux屏幕控制。
- 当前结论：原始ADC波形/频谱不要求知道调制制式；要显示正确解调结果，当前须指定制式、中心频率、输入通道，数字模式另须指定符号率。自动找频/自动带宽不等于自动调制识别。
- 已有能力：AA5命令接口和Linux iq_demod命令行可配置模式、中心、通道和带宽。符号率为Linux解调参数，不是现有FPGA命令。只有单路连续解调能力；BPSK/QPSK需要目标平台liquid-dsp。
- 尚未实现/验收：仓库网页仅有显示参数控件，server.py是只读接收服务，未集成触屏调制配置；用户屏幕现有程序未核实，不能宣称已部署该控制界面。屏端持续解调、CRC/缺帧和宽档BPSK仍需实测。
- 交接成果：[Linux屏幕调制显示与控制_AI交接说明](（私有证据：signal_analyzer_base_v1/docs/Linux屏幕调制显示与控制_AI交接说明.md)，含当前命令表、触屏控件需求、单串口所有者要求、模式切换和超时处理、验收边界。其他AI应先读该文及源码，不能将待实现界面写成既有功能。

### 记录 #67　GitHub资料核对与五项质量问题修复（源码与部署分开验收）

- 日期：2026-10-23。按用户要求通过GitHub核对libserialport、pySerial和liquid-dsp上游接口/示例，自行编写修复，没有复制LGPL代码或升级固定算法库。
- 修复：离线输出独占创建保护原始采样；网页新增整帧缺口/重复/疑似重启统计；串口发送1秒单调时钟期限和取消/恢复；Core LED极性；COM9文本采样的端口、速率、带宽是否实际下发等元数据。额外修复测试清理顺序，并给Linux C接收器增加与pySerial兼容的独占锁。
- 验证：数据保护/故障注入7组、协议18项、界面逻辑108种、三档四种数字调制合成、PM18组、真实daq_top隔离集成含LED映射及发送帧所有权回归通过；ARM Cortex-A7交叉编译通过。合成误差为零不等于真实BER验收，ARM候选未含liquid-dsp。
- 状态：源码修复已完成；候选419fb96fe09d正在物理构建，未烧录，未更新正式release/current.json；屏幕持续I/Q完整性和宽档BPSK实机仍待验收。
- [完整修复与验证报告](（私有证据：signal_analyzer_base_v1/firmware/reports/quality_fix_20261023_175256/修复与验证报告.md)，含GitHub固定资料链接、源码哈希与备份；[软件源码补丁包](（私有证据：signal_analyzer_base_v1/firmware/dist/quality_software_patch_20261023.zip)，不含bit、不自动部署。

## 八、2026-10-27 补充：可靠性修复、调制显示与数字 bit 阶段验证

本节补充10月23日至27日的工程进展。前文保留历史时间和当时判断；当前相关状态以本节列出的证据及验证范围为准。Prompt为工程复盘归纳，不冒充原始聊天逐字记录。本次编辑核对已有报告、代码提交和日志，未重新进行硬件测试。屏端部署状态取截至交互网站第214条的已核对快照，不代表持续实时状态。

### 记录 #68　低频 AFC 资格失效：先做因果对照，再修复观察器

- Prompt（归纳）：1kHz输入下锁相资格为什么不通过？先定位，不要强制放行资格。
- 定位证据：cap4中波形、MEAS、SPEC包CRC正确，但NCO参考约992.70～994.50Hz，guard_reason=8。粗AFC用4096个全速样点观察，时间仅63.015µs；对混频后的约2kHz和频项只衰减约0.228dB，污染相位与频差估计。R64测量窗约4.033ms，约3.443Hz残余频差即可产生约5°逐窗旋转。两路相对相位稳定不等于每路对参考的资格合格。
- 验证方法：运行实际粗控制器和CORDIC，将“真实混频和频项”与“解析移除和频项”作对照；1kHz真实组向错误方向修正，对照组恢复预期方向。该隔离仿真支持机制定位，不单独构成整机排他证明。
- 后续状态：10月25日可靠性报告已记录低频修复进入完整闭环回归，固定/生产自动带宽覆盖500Hz、1kHz、2kHz、10MHz、30MHz及噪声、异频、失锁、中断和重获，共13项。不能继续把10月23日定位报告中的“尚未修改”当成后续状态，也不能把数字回归提升为模拟校准完成。
- 纠错：不通过强置usable或放宽guard掩盖问题；当前资源报告也不能倒推出早期Y4/AA4停发的唯一根因。
- 证据：`firmware/reports/低频AFC定位_20261023.md`、`firmware/reports/优化修复复核_20261025.md`。

### 记录 #69　优先保证质量的资源优化：裁剪独立调试输出

- Prompt（归纳）：列出资源占用，优化不要以降低采样、滤波或测量质量为代价。
- 实际结果：保留COM9文本的候选9e91554febbd需要20821个Slice LUT，超过XC7A35T的20800个，布局失败，未生成该版bit；另一个质量候选综合LUT为21041，同样不能当作可下载成品。
- 修改：生产构建显式设置COM9_TEXT_ENABLE=0，裁剪独立文本/ET调试显示；AB5二进制波形、FFT、测量、DDC和命令接收保留，并做隔离等价检查。ADC 12位/65MSPS、4096点FFT、滤波配置、锁相门限、UART 2Mbaud 8N1不因该项优化降低。
- 物理实现快照：关闭COM9的可靠性候选LUT17743、FF11600、RAMB36 27、RAMB18 9、DSP75；BRAM36等效31.5。相对器件容量约为LUT85.30%、FF27.88%、BRAM63%、DSP83.33%。WNS=0.048ns、WHS=0.023ns，报告状态为bit_generated_not_programmed。这是指定候选的报告，不是当前板上资源身份证明。
- 纠错：不同构建的资源与时序不能拼表称同一最新版；资源紧张、UART丢字节、FIFO丢样及早期物理接线问题应分别定位。
- 证据：`firmware/reports/优化修复复核_20261025.md`、`firmware/reports/reliability_com9_off_20261025.json`。

### 记录 #70　屏端连点重配盲区：幂等配置与命令隔离

- Prompt（归纳）：屏端连续切制式长时间“预热”，未知命令不要影响已排队配置，并开放深抽取。
- 修改：隔离候选68485bd5de63对完全相同的mode/channel/rate/FCW跳过重配，不递增cfg、不重置分析链；未知命令不清除已暂存FCW高半字；RAW抽取命令开放k=0..15；E5 focus不递增cfg、不改变分析通道。
- 数字验证：220次重复完整Apply不触发DDC复位；输出33 ANA/3 RAW帧、CRC错0、ANA帧序连续、未见旧IQ01；AM/FM在1MHz/10MHz数值链路以及R32768输出节奏/短帧CRC通过。物理实现WNS=0.429ns、WHS=0.032ns、DRC错误0。
- 验证边界：该报告明确未烧录、未做本轮长时串口实机验收；不能因为生成了bit就说现场问题全部解决。幂等配置也不等于双缓冲零间隙切换，真正改变配置仍需获取和预热。
- 协议纠正：本项目是三窗，不应写七窗已实现；该候选SPEC接线固定Hann/0。DDC3/FFT3/IQ03归档接口不等于当前全部发出。无请求ID/严格ACK时，参数回显匹配不能严格证明某帧属于某次点击。RAW约5fps是既有分析调度行为，不能据此断言双IQ发送器并存。
- 证据：`firmware/reports/屏端反馈修复进度_20261025.md`。

### 记录 #71　原始波形、测量资格与新鲜度分开处理

- Prompt（归纳）：即使锁相不合格也要保留正常原始波形；过期读数不能继续冒充当前结果。
- 修改：有效RAW独立于锁相资格和锁相包CRC；帧号与采集时间戳共同核对；合并FPGA结果年龄和主机等待时间；重复帧不刷新新鲜度；超时撤回正式幅相，历史图像标过期。接收字节、有效帧、缺帧、重复及重启分开统计。
- 验证：10月25日报告记录接收/状态31项、协议交接39项、C实现93项及54字段交叉一致、UI逻辑108组；18项常用RTL回归通过。另有3个历史ET/FFT内部探针用例尚需迁移，不计为通过。
- 部署边界：该报告提供的是接收参考修复，本次没有据此证明当时的屏幕应用已经部署。后续实际GUI证据见下面独立阶段。
- 证据：`firmware/reports/优化修复复核_20261025.md`。

### 记录 #72　AM包络显示：用真实发生器变化核实图像

- Prompt（归纳）：包络看着像固定演示；改变发生器后是否会跟着变化？保留波形并标明载波信息。
- 分工：FPGA输出真实采样/分析数据，Linux解析、显示包络与测量量。上下镜像边界及填充是测得包络的可视化，不是逐点采到的高频RF载波；参考频率与实测估计必须分标签。
- 实测：UTG2062X CH2→ADC CH0→屏CH1，1MHz载波。25%正弦AM复测实屏25.3%，诊断中位25.145%；50%/500Hz阶段实屏49.0%，诊断中位49.66%。0%阶段标签实际为“--”，不采信屏端文字中的0.0%。500Hz上升锯齿调制下，用户确认斜坡形，后续实际截图也核对到斜坡回落。
- 纠错与限制：一次25%阶段因通信超时脚本恢复原源，作废后重测；方波阶段只有源设置读回、未获实屏，不写通过。非正弦包络不以正弦拟合百分比充当精确调制度。截图与文字不一致时保留原图事实。结束恢复原AM并实际VISA读回。
- 证据：`firmware/reports/AM_UI联动实测_20261026.md`及其源记录/截图目录。

### 记录 #73　OOK已知交替bit实测，以及屏端双读者故障纠正

- Prompt（归纳）：数字调制既保留波形，也要能输出bit；先验证已知输入，不能只看计数增长。
- 实现位置：Linux对V32ANA1! mode5/kind1包络做电平估计、滞回边沿、人工符号率定时及中心积分，保留ADC/包络图；本阶段未更换FPGA bit。发生器用1MHz载波、500Hz方波100%AM构造等效1000Bd交替OOK。
- 排障：中间运行有DRM master冲突、CRC错误增长，屏端守护与手动GUI同时读UART；另有后台点击改变配置、附件错发旧AM图。未以这些污染阶段修改RTL或放宽缺帧保护，而是先固定唯一UART读者、停止后台切换并重测。
- 最终证据：cfg188、同一1000Bd配置，开启0101参考检查后的连续快照跨度21.213499秒，最终21759有效bit、0不确定判决、0交替错误/21758检查。有效段CRC/序列错误0；丢弃字节累计958但不增长，不能写整个文件累计丢弃0。
- 原始流交叉复核：372 ANA帧CRC全正确，fid相邻连续，95232包络点；同核心CLI及真实解析器→队列→GUI主机回放均5998bit、0不确定、0交替错误/5997检查。ASan/UBSan通过。
- 结论范围：已知重复0101、1000Bd、该幅度与DDC条件下阶段通过，不是任意码流、长同码、自动Rs识别、协议解码或通用BER验收。
- 证据：`firmware/reports/OOK真实bit闭环阶段结果_20261026.md`及`ook_bits_hold_20261026_201315`、`ook_bits_hold_20261026_192632`目录。

### 记录 #74　2FSK从频偏波形到bit：统一核心与真实流验收

- 实现：Linux读取mode3/kind2有符号相位增量，按df=d24×65000000/(R×65536)换算Hz；低/高频候选、滞回边沿、已知Rs定时及中心积分，低频=0、高频=1。kind2不是Q8幅度。生产提交65e113c，未改变FPGA bit、波特率、点数或ADC精度。
- 输入：两频999300/1000700Hz、内部500Hz跳频、0.3333333Vpp、0偏置，构成重复交替1000Bd源。
- 实时GUI：同一cfg199，开启0101检查后跨度20.439166秒，最终20856bit、0不确定、0错误/20855检查，CRC/序列/丢弃字节统计均0。
- 原始流：另一cfg200段371 ANA帧、CRC错0、fid连续；94976点、跨度5.984949秒；同核心恢复5981bit、0不确定、0错误/5980检查。真实解析→GUI主机回放结果一致，ASan/UBSan通过。
- 纠错：GUI与独占抓包时DDC中心相差约435Hz，相对频偏不能直接比较；分位数/EMA与码簇均值也不是同一统计量。已知交替检查不是通用BER。测试完成后核验原AM恢复，后补新图确认为AM。
- 证据：`firmware/reports/2FSK真实bit闭环结果_20261026.md`、`firmware/reports/fsk_bits_hold_20261026_203537`。

### 记录 #75　BPSK恢复实现与历史抓包回放：不冒充新版实屏验收

- Prompt（归纳）：继续实现BPSK bit恢复，同时保留原始波形，星座图必须来自真实数据。
- 实现位置：Linux读取mode6/kind0 signed I/Q；kind0的bit31是Q符号位，不能套用kind1/2的无效标志。用1024样点粗估频偏/相位、连续补偿、重采样到4Rs及liquid-dsp 1.7.0跟踪，预热和质量判据合格后判bit。人工选择Rs，缺帧/配置变化清片段；QPSK仍未实现本轮bit输出。
- 显示：原始ADC/IQ时间图保留；下图可切真实恢复符号点与RAW IQ。未同步时不拿原始散点冒充恢复星座。INV显式处理极性选择，BPSK固有180°歧义不能无参考消除。
- 已完成验证：合成频偏/初相/分数定时/±300ppm时钟偏差等12组及异常场景、ASan/UBSan；历史真实372 ANA帧CRC错0、无帧/配置缺口，同核心5747bit、0不确定、PN7后续检查0错误/5460次，EVM诊断值0.028637。实际解析→GUI主机回放相同。独立导出串审核5740次递推检查无违反（允许整体反相）、5620次127周期比较无不匹配、首127个7bit窗口有127种状态。
- 边界：这些是历史原始IQ的主机回放，不能写成新版RK3506连续实屏通过；PN7允许循环起相、方向和整体反相，获取训练不计入后续checks。该一致性检查不是通用BER或协议帧解码；EVM是算法资格用参考距离，不是校准通信仪表值。
- 证据：`firmware/experimental/modulation_ui_20261026/repo/docs/bpsk-bit-decoder-20261026.md`、`ui_test/bpsk_old_replay.json`、`ui_test/real_bpsk_capture_replay.log`（后两项位于`firmware/experimental/modulation_ui_20261026/`下）、`firmware/reports/digital_bpsk_hold_20261026_151527/recovered_bits.prbs7_audit.json`。

### 记录 #76　构建成功的真实性：干净配置、失败传播与实际产物核验

- 问题：屏端在CMake 3.22.1的全新C-only配置中，liquid summary.cmake的裸string(STRIP ${__result} __result)遇空CXX参数后少一个实参而报错。旧缓存环境构建成功不能证明干净环境可复现。
- 修复：只给解包构建树summary的两处STRIP参数补引号，固定库原始压缩包不变，SHA256仍为33c42ebc2e6088570421e282c6332e899705d42b4f73ebd1212e6a11da714dd4。远端脚本使用bash和pipefail，避免tail吞掉构建失败后拉回旧程序；转发BUILD_DIR/LVGL_DIR，交付GUI及OOK/FSK/BPSK三个CLI。
- 本端验证：全新C-only目录configure/generate及脚本bash -n通过。2026-10-27提交d182c3e8370c0241f614f5615a6a40063dfaba4e已推送，ls-remote核对一致，网站第214条已通知屏端。
- 截止状态：新BPSK ARM部署与本轮实机验收尚待屏端完成；最后已核对的屏端反馈仍运行旧65e113c产物。不能将主机x86可执行文件当成ARM交付，也不凭“部署成功”文字跳过实际文件平台、哈希、进程和唯一串口读者核验。
- 公开提交：[d182c3e](https://github.com/Creamy-coffee/dual-channel-modulation-analyzer/commit/d182c3e8370c0241f614f5615a6a40063dfaba4e)。该仓库为Linux协作程序，不等于FPGA工程已独立开源到用户账号；用户提出的FPGA端开源整理需求尚不能记为完成。

### 本轮更新后的汇报口径与待办

1. FPGA承担双路采样、已有DDC/滤波/分析及打包；Linux负责此轮OOK/2FSK/BPSK的符号判决与页面。不能把Linux新增解码写成FPGA新增完整解码器，也不能把选中一路分析写成双路同时连续解码。
2. OOK、2FSK已有指定已知输入下的真实流及连续GUI阶段结果；BPSK已有实现/历史真实IQ回放，新ARM实屏仍待验收；QPSK、任意协议/FEC、自动制式/Rs识别、通用BER仍未完成。
3. 下一步待屏端BPSK_BITS_READY并核实实际运行版本，再开启发生器PN7测试，取得至少10秒合格运行日志、真实新图和约6秒原始流，同核心及独立递推复核，最后恢复AM。
4. 双通道自身幅相校准尚无等长线同源分路实测，不能把相位差全部归因于线缆，也不按推测延时硬编码校准常数。FFT、锁相与调制验证按各自构建和输入条件分别验收。
5. FPGA开源整理应按实际可复现构建列出RTL/IP生成步骤、约束、协议、测试和许可证，清理凭据及个人环境文件；如仅公开源代码，不能宣称已交付可在任意板卡直接使用的成品。

本节未新增硬件测试结论；保留失败阶段、误判修正和来源，便于答辩说明LLM辅助的实际作用：提出假设与实现候选，再由仿真、构建、源读回、原始包和实际页面逐层验证。

## 九、2026-10-31 补充：参赛文档证据核验、真实仿真插图与实机补测

本节补充10月27日之后的已核对进展，重点记录10月31日的证据核验和补测。前文保留当时状态；例如“BPSK新版实屏待验收”和“谐波待实机验收”不能直接作为本节截止状态。Prompt为工程复盘归纳，不是原始聊天逐字转录。已有测试、当日重核、当日新增测试分别说明，不将历史结果冒充本日重新测得。

### 记录 #77　用真实Vivado波形替换文档示意时序图

- Prompt（归纳）：将技术文档中的示意时序图换成实际testbench运行截图，保留赛事要求的格式。
- 操作：ADC使用`tb_adc_parallel`；其余使用局部AFC、测量带宽控制器、共享FFT、AB5二进制UART及可选ET模块的真实RTL测试。保存WDB、WCFG、测试日志与截图，将图2～图7替换成实际Vivado波形；图1是系统框图，继续保留框图。
- ADC结果：覆盖全部4096个码值、两种编码、双路同边沿、OTR、启动、失锁及复位，累计12332次检查通过；仿真约190.854 μs结束。图示启动参数STARTUP_CYCLES=4，实机默认500000约7.69 ms，不能从截图纳秒范围推断实机预热时间。
- 其余范围：带宽控制器9组场景通过，积分参数缩短为8点；FFT采用4096点Hann及合成谐波，独立复核峰值bin=128；UART按65 MHz、2 Mbaud、8N1发送缩短的16对/108字节测试帧，独立解码及CRC32检查通过；ET独立21项检查通过，但不说明当前bit已输出ET数据。
- 文档操作：保留样式、页眉、页脚及编号，导出PDF检查分页后交付。原始文档和修改前备份保留；真实仿真不等于模拟前端或整机计量精度验收。
- 证据：`firmware/reports/doc_adc_20261031/`、`firmware/reports/doc_waveforms_20261031/`；脚本`insert_adc_doc_20261031.py`、`insert_remaining_doc_waves_20261031.py`。

### 记录 #78　AFC漂移失败复查：保持RTL和门限，检查数值收敛等待

- 问题：原`tb_afc_recovery`在首次捕获通过后，将残差设定从+1200 Hz改为+1300 Hz；等待200000个100 MHz仿真周期约2 ms后调用检查。此时残差约102.734772 Hz，超过8 Hz门限，原回归失败。
- 补测：原失败测试与日志保留，不修改生产RTL、不降低8 Hz门限。新增测试在最多2200000周期内同时检查ready及实际残差，允许观察器完成后续更新，避免因旧ready仍有效而立即把早期残差判为最终稳态结果。
- 结果：首次捕获残差约2.734772 Hz；漂移跟踪、断流恢复及信号恢复通过，后续残差约2.547746 Hz，测试约33.056 ms仿真时间结束。漂移组在原2 ms等待之后，额外等待1069760周期才达到数值要求。
- 结论边界：补齐的是控制器数字有界收敛证据；原“约2 ms时未收敛”的现象仍真实存在。本测试没有证明过渡期资格撤回策略、实际获取时长或模拟精度全面合格，也没有据此生成或烧录新bit。
- 证据：`firmware/reports/doc_evidence_20261031/afc_bounded/console.log`与`result.json`；脚本`recheck_afc_evidence_20261031.py`。原失败日志位于`doc_waveforms_20261031/afc/`。

### 记录 #79　谐波“待实机验收”文字过时：补录后续实测并保留校准边界

- Prompt（归纳）：H1～H5和THD₂₋₅之前不是已经验证过了吗？逐条查记录，不能把完成的内容仍写成未验证。
- 找到的后续证据：10月29日覆盖1 kHz、250 kHz、1 MHz、5 MHz、共16组输入条件，取得218个稳定CRC正确HRM结果，H1～H5阶次有效。发生器CH2接屏端CH1，第二采集通道没有因此完成同等覆盖验收。
- 方波离线统计：THD₂₋₅约38.66%～39.07%；舍入修复版另有1 MHz两档正弦和方波复测，方波H3约−9.596 dBc、H5约−14.079 dBc、有限阶THD约38.637%。正弦高阶低于门限不能写成模拟零失真。
- 文档修正：将笼统“待实机验收／尚待屏端适配”改为“指定条件实机功能验证完成，可溯源精度校准尚未完成”。这些统计不是屏显逐帧精度指标，不证明全频带或双通道精密THD已认证。
- 证据：`harmonic_matrix_20261029/acceptance.md`、`harmonic_rounding_physical_20261029/acceptance.md`、`harmonic_display_20261029/`及`harmonic_confidence_20261029/`，均位于`firmware/reports/`。

### 记录 #80　版本与资源不能沿用旧候选：核对实际产物和部署身份

- 实现报告引用更新为a222905e5799：20294 LUT/20800（97.57%）、13111 FF、32 RAMB36加8 RAMB18（等效36块BRAM）、80 DSP/90；WNS=+0.172 ns、WHS=+0.010 ns，DRC错误0。不能沿用16556a032258的20239 LUT和+0.407 ns等数据作为该版本结果。
- bit文件：`FPGA_bag/bit/harmonic_rounding_a222905e/fpga_a222905e.bit`；本次重算SHA256为`76afefdbf47d3cdb31ea5eaba13fd96468875622ede87bce231b217367e0b051`。10月29日下载回执记录USR_ACCESS=a222905e、DONE=1；10月31日没有重新读JTAG，不能说本日再次核验了板上bit身份。
- 屏端：10月31日通过ADB实读`/usr/bin/waveform_demo`，SHA256为`aff78075f84b6d34001e40aa0ee6efa0007b83a3731b6587b82de38a4da9f5af`；核对到只有一个串口接收进程。
- 证据：`experimental/harmonic_rounding_20261029/reports/a222905e5799/`、`reports/program_new_fft_20261029/receipt.json`及本轮`doc_evidence_20261031/device_before.txt`。不同日期、构建、软件部署、输入条件分别绑定。

### 记录 #81　当前实机补抓：独占cat异常与GUI同读者正常必须分别记录

- 前提：ADB和发生器USB控制均可用。发生器读回两路均1 MHz正弦基波、0.3333333 Vpp、输出开启；CH1处于AM调制，CH2连续模式且基波相位设置为−90°。本轮仅查询，未改变发生器参数。
- 首次尝试：停止GUI后，独占`cat /dev/ttyS1`约120秒仅记录1字节00，没有完整帧。服务恢复后用户确认波形仍持续更新，不能据该抓包直接认定FPGA停发或历史数据失效。
- 改进方法：启用屏端现有`WAVE_RAW_CAPTURE`，由唯一UART读线程复制原始字节、独立写盘；GUI仍按实际接收路径工作。40秒结束用SIGTERM正常排空，finally恢复原开机服务。
- 新增结果：3828679字节，RAW798帧、MEAS798帧、SPEC200帧；CRC错误0、格式错误0，RAW帧号2168～2965连续。记录器accepted=written=3828679，overflow=0、error=0、limit=0。
- 锁相状态：798个MEAS中772个通过接收器资格及年龄检查；相差范围约86.4404°～86.4734°，中位数86.4514°，最大结果年龄约64.48 ms。其余26帧不作为正式有效结果；“非零flags仅2帧”不能替代完整资格统计。
- 结论边界：这是当前同频输入及当前GUI配置的短时功能验证，含信号源、线缆和采集路径效应，不把86.4514°直接当作通道校准常数。未完成30分钟长测，也没有因此验收所有模式或独占cat方法异常的根因。
- 证据：`doc_evidence_20261031/source_readback.json`、`capture.bin`、`same_reader.bin`、`same_reader.log`、`same_reader_summary.json`、`measurement_summary.json`和`same_reader_restored.txt`。原服务已恢复；未烧录bit或部署新程序。

### 记录 #82　补录数字调制证据：历史PC结果和当前屏端能力分开

- BPSK：后续已有ARM实机阶段证据，不能继续用记录#75／#76截止时的“尚待新版实屏”概括后续。指定PN7条件下，原始372帧、同核心5747 bit、训练后5460次检查零错；GUI独立审计约24.2463秒，末次24702次参考检查零错零擦除。仍不是通用BER。
- BPSK历史3次擦除：已定位在参考训练之前／期间，后续多段同读者原始记录未复现；根因未闭环，不能写成已修复。对应定位报告继续保留。
- QPSK：10月31日重跑历史文件审计，四段真实IQ共2917帧，SHA256一致、CRC错误0、内部帧缺口0。原历史离线结果累计62712个留出符号零错；本次只重核传输证据，没有重新运行符号恢复算法。
- 能力边界：QPSK历史PC符号恢复不等于当前RK3506已输出QPSK bit；屏端仍按原始I/Q观察描述。选路OOK/2FSK/BPSK也不等于双路同时连续解码、未知制式／符号率识别或任意协议解码完成。
- 证据：`BPSK真实bit闭环结果_20261027.md`、`BPSK训练擦除定位结果_20261027.md`、`display_clarity_20261028/qpsk_history_audit.json`，位于`firmware/reports/`。

### 记录 #83　显示和测量分层核验：三窗、锁相、PM、图片分别表述

- 三窗：10月30日真实RAW同帧Hann/Blackman/FlatTop切换、幅度归一化与底噪差异有记录；FPGA固定Hann和屏端RAW三窗是两条路径，不能将窗名切换视为FPGA硬件已实现三窗，也不人为加入噪声让图“好看”。
- 锁相页：已有密集曲线像素列min/max防漏峰、暂停冻结测量、诊断残留和布局修复，包含原生回归、ARM部署及实屏暂停像素一致记录。历史两路约1 MHz与30 MHz时资格失败，不属于已知同频相位关系的验收。
- PM：历史1 MHz载波、1 kHz正弦调制、90°峰偏实际采集371个有效帧；排除首3帧后，离线拟合中位数1000.0 Hz、89.8915°。这支持指定输入采集正确，但旧屏端PM峰偏统计会混入趋势项，不能据离线结果宣称界面数值精度已通过。
- 图片：OOK/2FSK/BPSK合成回环及ADB逐像素显示已验证；历史实际载波整图记录仍标记`physical_image_accepted=false`，不能因屏幕曾显示完整图而省略独立真实抓包验收。
- 证据：`window_shape_20261030/`、`raw_spectrum_20261030/`、`lock_graph_20261030/`、`lock_check_20261030/`、`pm_check_20261029/`、`image_transport_20261027/`及`image_rf_ook_20261027_164947/window_result.json`。

### 记录 #84　文档交付：修正过时待验收描述，同时保留真实不足

- 输入：`FPGA_bag/双通道65MSPS信号分析仪技术文档_参赛格式版_20261030_已清批注_改前.docx`，原件保留。
- 输出：`FPGA_bag/双通道65MSPS信号分析仪技术文档_参赛格式版_证据核验修订_20261031.docx`；SHA256为`3a9a773824da49af812ed597b155d4f470e55d63c70d1047790012c53e7276d5`。
- 处理：同步摘要、性能表、资源及时序、算法图注、阶段验收、参考资料及版本追溯，补录既有谐波、相对频响、QPSK、PM和显示记录，加入当日AFC及同读者补测。避免摘要说“待验收”而正文已有实测、或性能表和资源表引用不同bit。
- 样式保护：样式、编号、设置、页眉页脚XML保持；包内14个原有媒体文件字节不变。使用Word导出PDF检查，补证后自然分页为32页，不宣称页数没有变化。
- 交付证据：`doc_evidence_20261031/document_changes.json`、`visual_review.json`、`delivery.json`及`核验清单.md`。排版中间PDF和PNG仅用于检查。

### 本节截止仍未完成的事项

1. 双通道绝对电压／相位及精密THD可溯源校准：需要同源分路、适当线缆和工况参考仪器；组合链相对频响不能代替接收机自身校准。
2. 当前冻结组合30分钟长测、系统性断电恢复、捕获概率、长期误检率和多音选择性：本轮40秒、历史60秒不能替代。
3. 当前屏端QPSK bit、双路连续解调、自动制式／速率识别、任意协议／FEC和通用BER：未实现或缺完整验收，继续作为能力边界。
4. PM屏显峰偏统计、BPSK历史训练擦除根因、独占cat与GUI同读者差异，以及实际载波整图独立验收：保留现象和证据，不用未复现或单次成功消除问题。

LLM辅助在本轮的作用是查找跨日期证据、识别过时结论和版本混用、提出可证伪补测、编写记录与文档修订脚本；最终结论依赖原始数据、测试日志、文件身份和实屏反馈。没有通过更换措辞把未完成事项写成全部验收。
