Creamy-coffee/dual-channel-modulation-analyzer/docs/screenshots/02-scope-2mhz.png

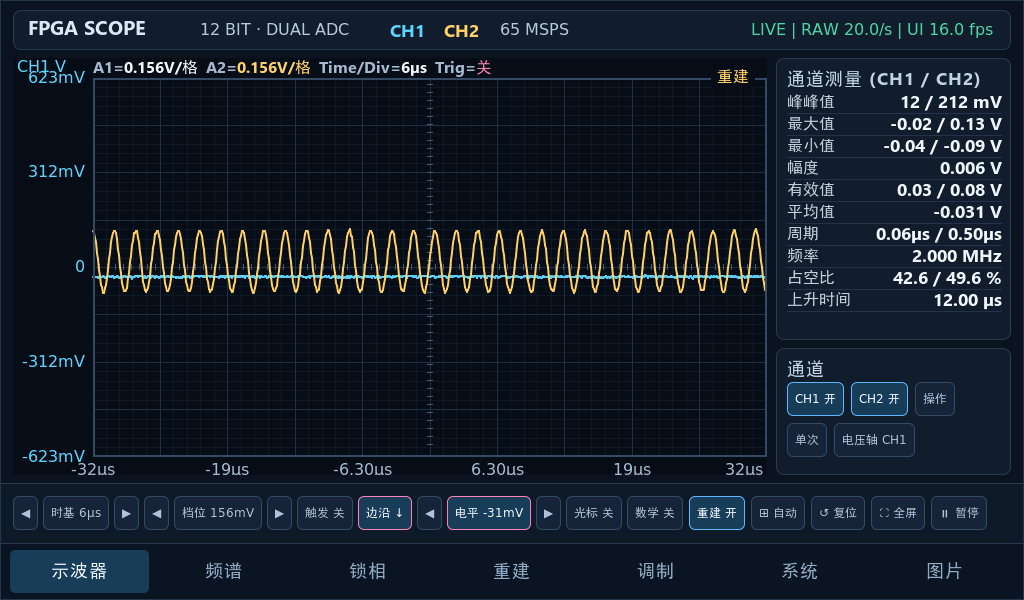
docs/screenshots/02-scope-2mhz.png
