Creamy-coffee/dual-channel-modulation-analyzer/docs/screenshots/03-fft-hann.png

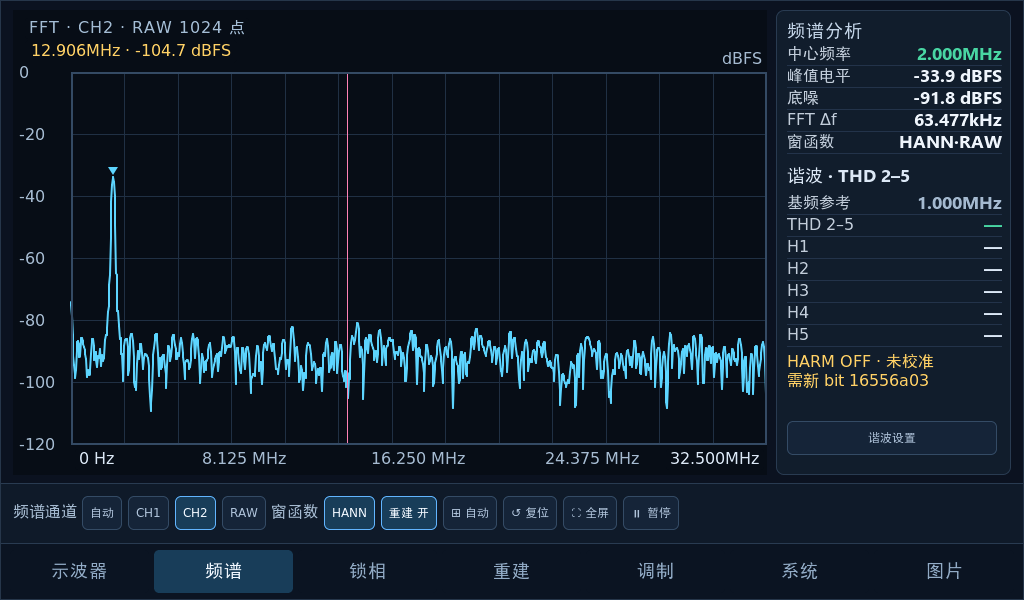
docs/screenshots/03-fft-hann.png
