Creamy-coffee/dual-channel-modulation-analyzer/docs/screenshots/04-fft-blackman.png

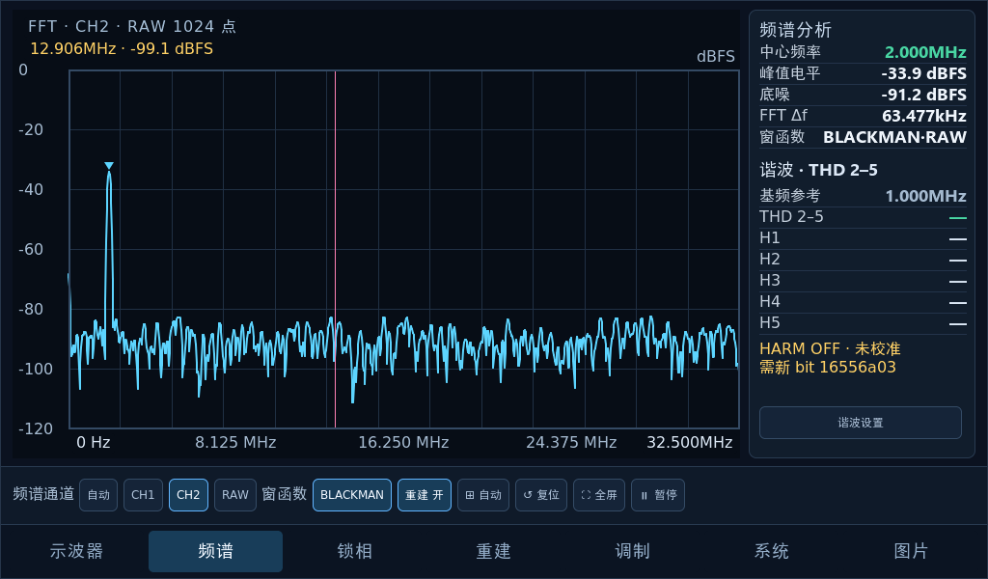
docs/screenshots/04-fft-blackman.png
