Creamy-coffee/dual-channel-modulation-analyzer/docs/screenshots/05-fft-flattop.png

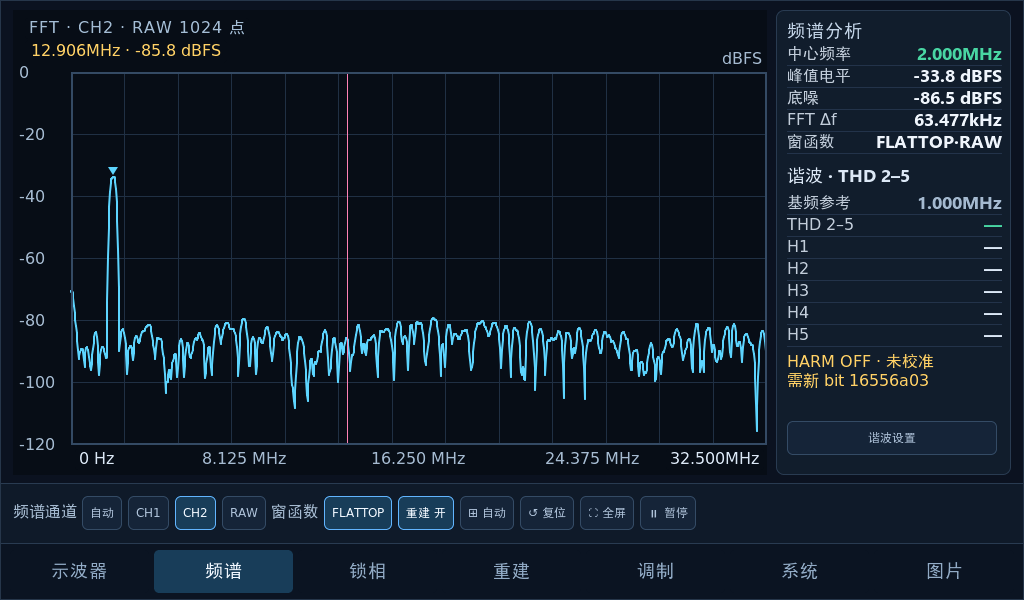
docs/screenshots/05-fft-flattop.png
