Creamy-coffee/dual-channel-modulation-analyzer/docs/screenshots/06-fft-harmonic.png

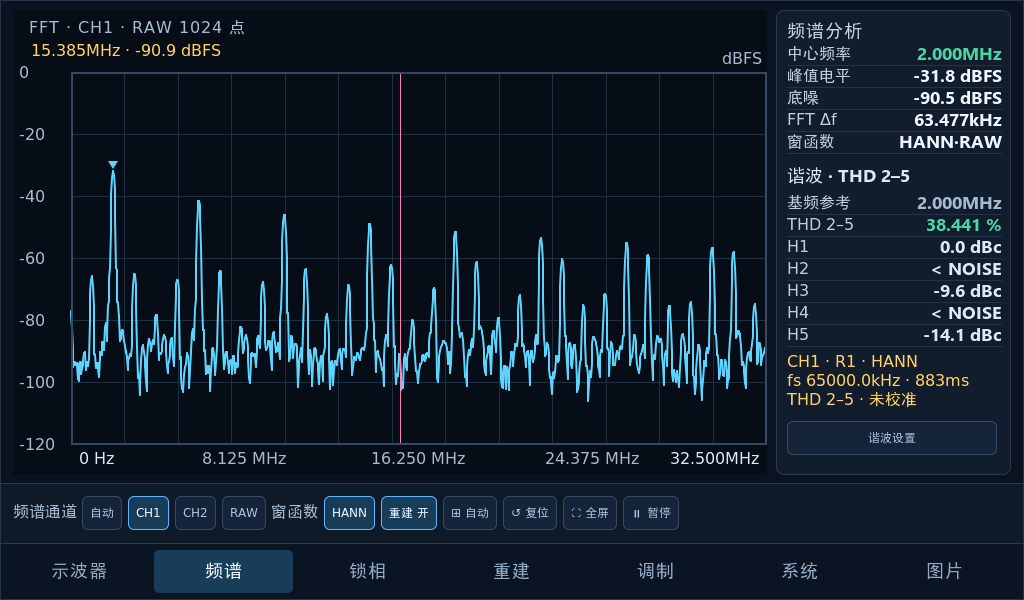
docs/screenshots/06-fft-harmonic.png
