Creamy-coffee/dual-channel-modulation-analyzer/docs/screenshots/07-lock.png

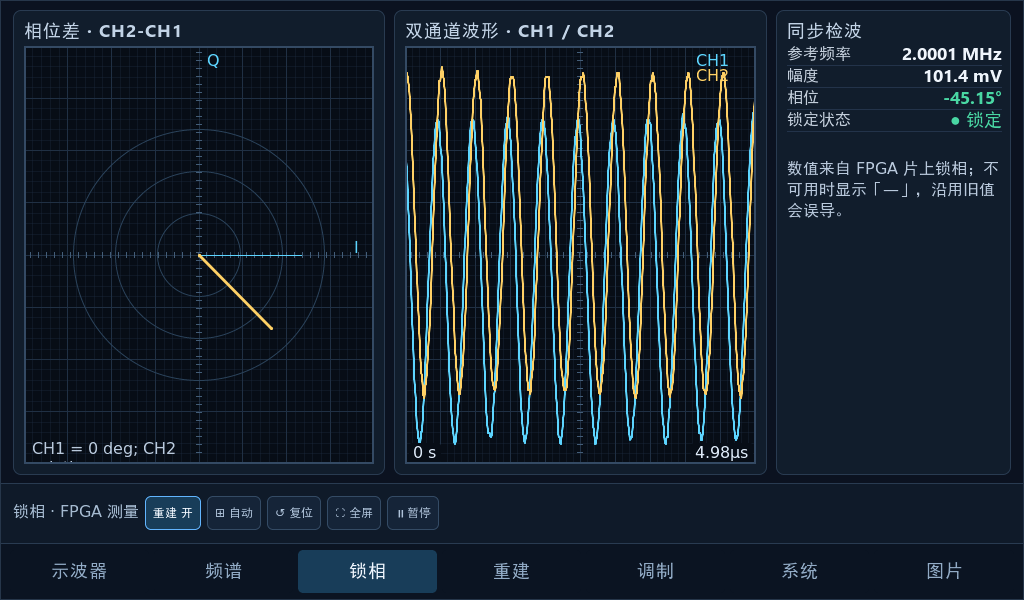
docs/screenshots/07-lock.png
