Creamy-coffee/dual-channel-modulation-analyzer/docs/screenshots/08-lock-open.png

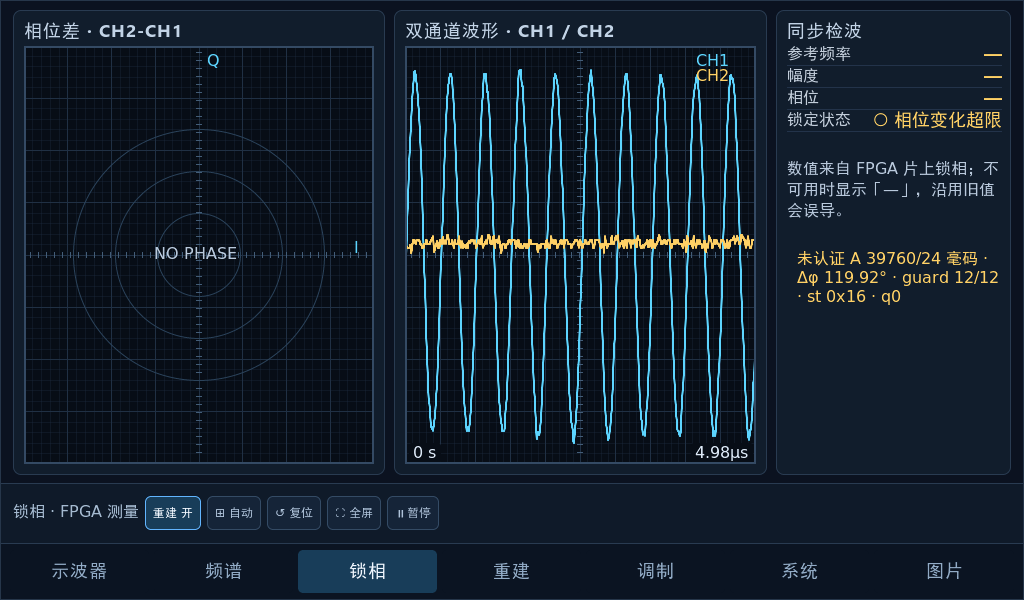
docs/screenshots/08-lock-open.png
