Creamy-coffee/dual-channel-modulation-analyzer/docs/screenshots/09-mod-am.png

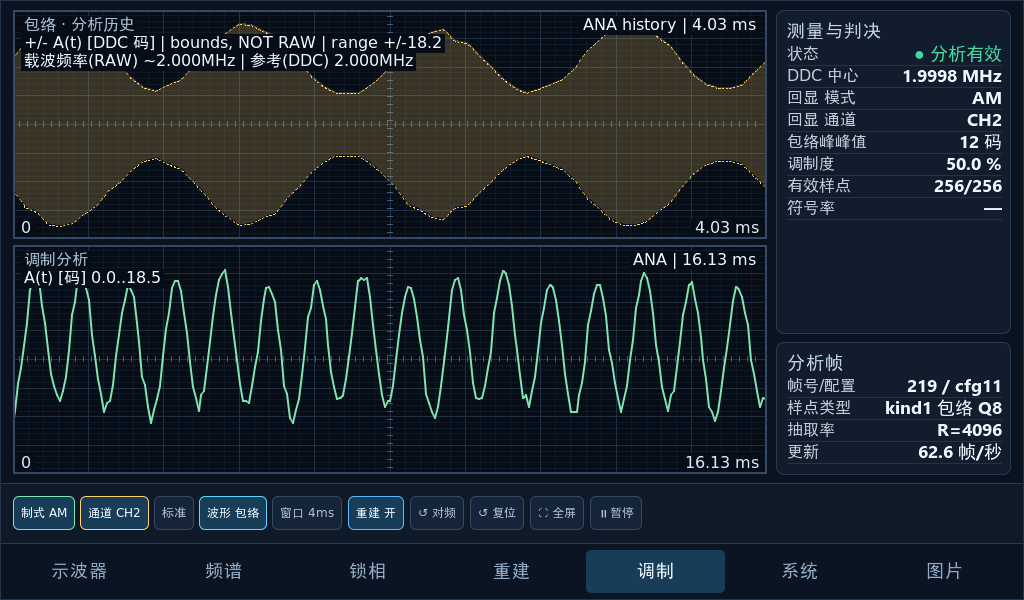
docs/screenshots/09-mod-am.png
