Creamy-coffee/dual-channel-modulation-analyzer/docs/screenshots/10-mod-2fsk.png

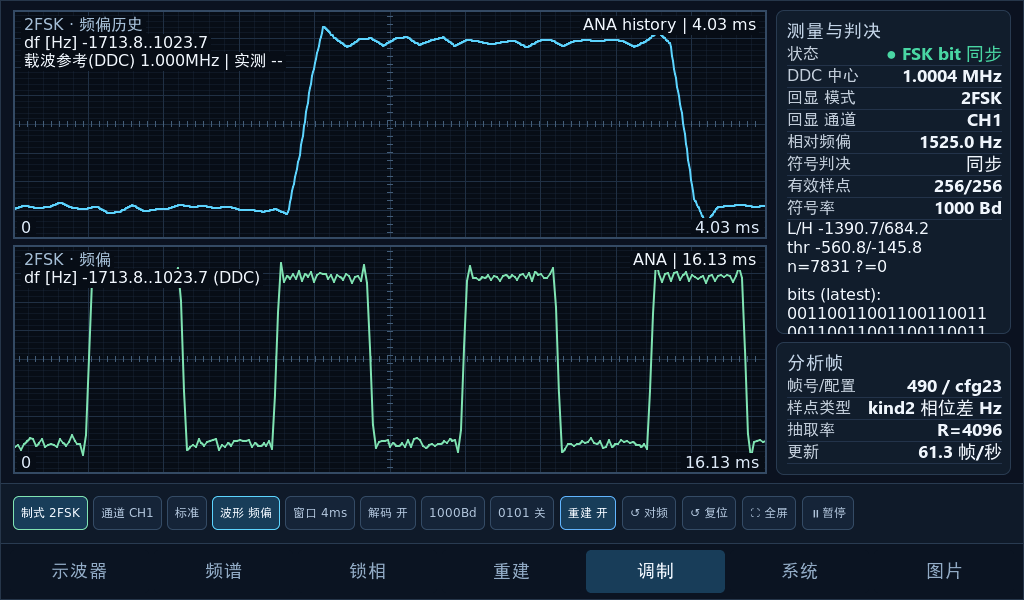
docs/screenshots/10-mod-2fsk.png
