Creamy-coffee/dual-channel-modulation-analyzer/docs/screenshots/11-mod-bpsk.png

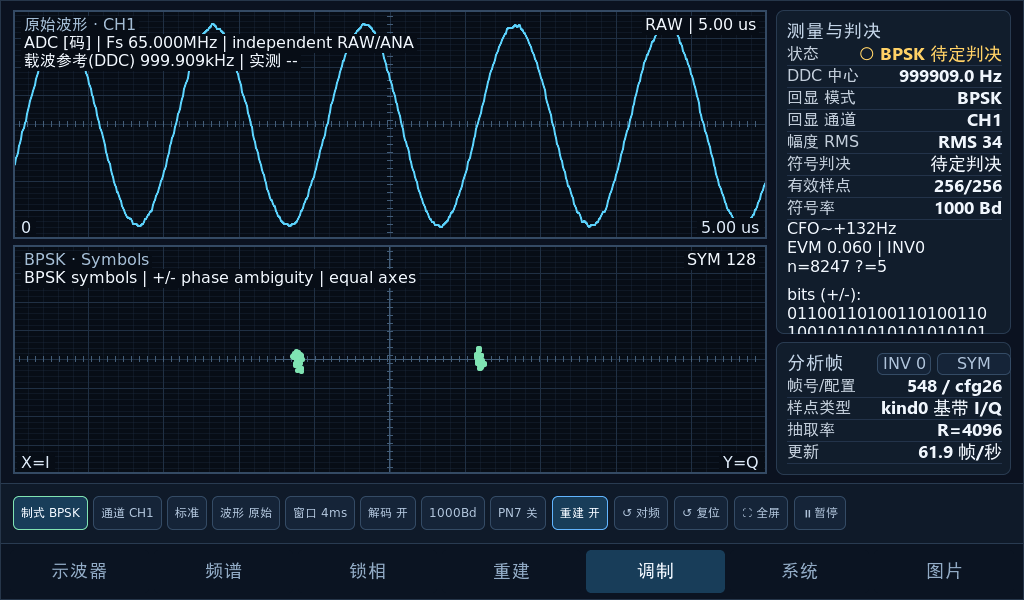
docs/screenshots/11-mod-bpsk.png
