Creamy-coffee/dual-channel-modulation-analyzer/docs/screenshots/12-mod-ook.png

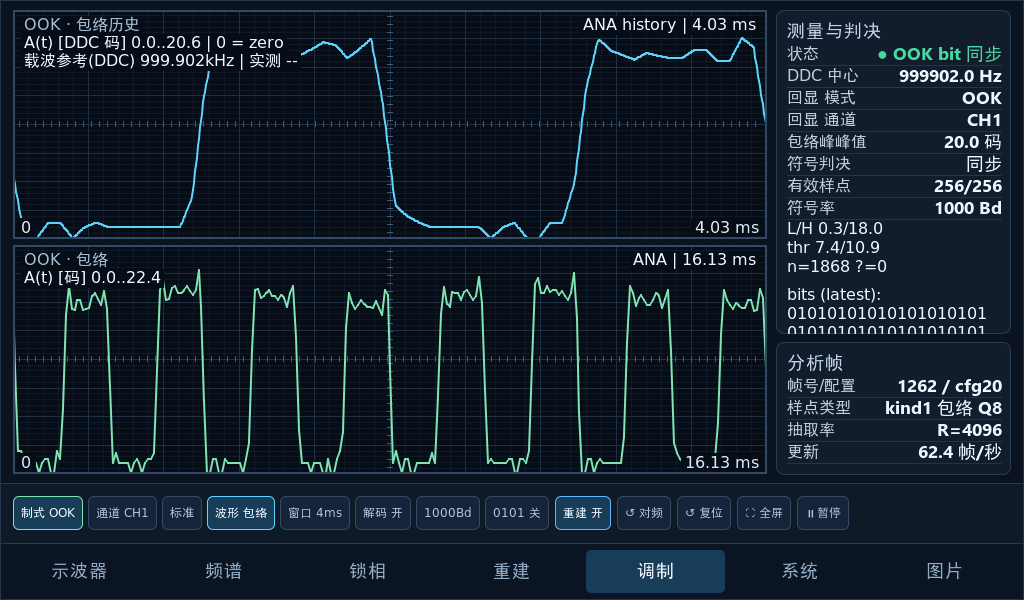
docs/screenshots/12-mod-ook.png
