Creamy-coffee/dual-channel-modulation-analyzer/fpga/build_evidence/build_audit.txt

SOURCE_ID=a222905e5799
GENERIC=ADC_FS_HZ=65000000 BINARY_POINTS=1024 BINARY_BAUD=2000000 REF_FREQ_HZ=30000000 AFC_ENABLE=1 SCAN_ENABLE=0 FFT_ENABLE=1 LOW_FFT_ENABLE=1 BW_MODE=2 BW_MAX_GEAR=2 AUTO_TIMEBASE=2 MAX_DISP_M=15 ET_ENABLE=1 ET_AW=6 ET_AVG_SHIFT=4 AA_ORDER=3 DDC_ENABLE=1 COM9_TEXT_ENABLE=0
WNS=0.172
WHS=0.010
DRC_ERRORS=0
BLACKBOX=0
CNN=0
FFT_ENGINES=1
CIC_STAGES=4
CAPTURE_BANKS=5
FINE=1
ET=0
V32CAP3=1
DDC_NCO=1
ANALYSIS_STREAM=1
COMMAND_RX=1
uart_tx=AB6
v32_tx=AB5
v32_rx=AA5
adc_clk=E3
adc_clk_b=P2
