Creamy-coffee/dual-channel-modulation-analyzer/docs/screenshots/13-test-setup.png

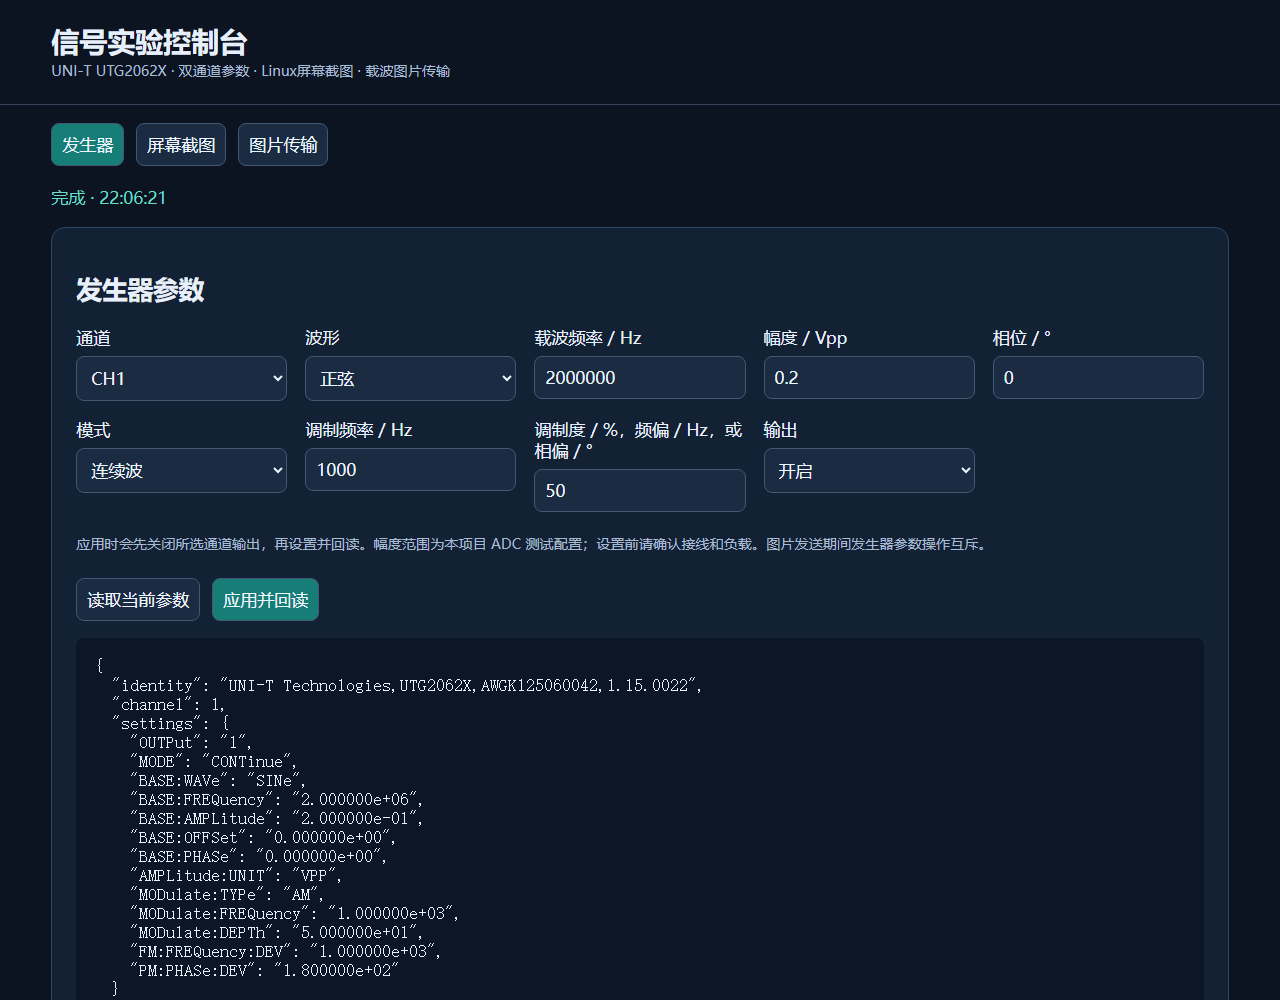
docs/screenshots/13-test-setup.png
