Creamy-coffee/dual-channel-modulation-analyzer/docs/todo-audit-20261102.md

# 待完成项逐条核对（2026-11-02）

README「已知边界 / 待完成」里那 8 条，是凭记录口径写的。对照原始证据逐条查过之后，
**1 条其实已经做完、1 条部分完成、6 条确实还没做**。这里留下核对过程和证据位置，
避免下次又按印象勾选。

核对范围：内部证据树 `firmware/reports/`（174 个报告目录，最新到 2026-10-31）、
`LLM辅助优化记录_初稿.md`（记录 #1–#84）、以及仓库当前源码。
没有 2026-11-01 之后的新报告，所以结论以 10-31 为截止。

## 一、逐条结论

| # | 原表述 | 结论 | 依据 |
|---|---|---|---|
| 1 | QPSK 屏端符号恢复（只观测 I/Q，不输出 bit） | **部分完成**：主机侧符号恢复早有闭环，屏端确实没移植 | 见下 |
| 2 | BPSK 实机「已获资格」判决记录（现有 EVM 0.060 / 待判决） | **已完成**，原表述停留在更早一次失败运行 | 见下 |
| 3 | 「图片」页真实载波下的完整接收核对 | **未完成**：屏上显示走完，独立抓包核验缺位 | 见下 |
| 4 | 七页版本绘制帧率复测 | **未完成**：探针已内建，缺一次上板运行 | 见下 |
| 5 | 上板验证本次重建产物 | **未完成**：只有构建侧复现，没有下载跑功能 | 见下 |
| 6 | 正式工具链 `gcc-arm-10.3-2021.07` 重编 | **未完成**：全盘无该工具链、无构建记录 | 见下 |
| 7 | 整机与接线实物照片 | **未完成**：仍是占位 | 见下 |
| 8 | 字体子集换思源黑体 | **未完成**：仍是 SimHei + Segoe UI Symbol | 见下 |

## 二、逐条明细

### 1　QPSK：主机侧做过，屏端没做

- **历史主机侧结果**：4 段真实 IQ，CRC 全对 2917 帧、帧内缺口 0；留出符号
  62712 个、符号错误 **0**；EVM 0.07740–0.07789。覆盖 500 Bd 与 2000 Bd，
  ADC 通道 0 与 1 都有。
  证据：`firmware/reports/display_clarity_20261028/qpsk_history_audit.json`
  （`pass: true`）。
- **但 2026-10-31 那次是重核传输证据，没有重跑符号恢复算法**；所以这 62712 个
  符号是历史离线结果，不是当日新测。
- **屏端仍未移植**：`src/ui.c:3266` 原文
  `QPSK RF/host recovery was tested on 2026-10-22. The screen exposes its existing IQ observation; host symbol recovery is not ported here.`
  屏上 QPSK 只画 I/Q 轨迹。

**不能写成「QPSK 已完成」**，也不能由 BPSK 的实机闭环推及。

### 2　BPSK：实机资格记录已经有了

2026-10-27 实机（发生器 CH2 → ADC CH0 → 屏端 CH1，1 MHz 载波、1000 bit/s、PN7、
0°/180°，屏端提交 `d182c3e`）：

- 372 个 BPSK ANA 帧 CRC 全对，坏候选 0，帧号 10665–11036 连续，95232 样点覆盖 6.001081 s
- ARM 端导出 **5747 bit**，本机同核心 CLI 逐字节一致
- 训练之后 **5460 次检查、错误 0**，零擦除，PN7 已锁定
- 独立于解码器的 bit 审计：PRBS7 递推 5740 次零违例（允许全局极性）、
  周期 127 比较 5620 次零错、首 127 个七位状态互不相同
- GUI 附件审计：**24.2463 s** 合格连续片段、25 个快照，末次参考检查 24702 次、
  零错零擦除；EVM 0.0260–0.0481；原始片段本机粗 CFO 144.65 Hz

证据：`firmware/reports/BPSK真实bit闭环结果_20261027.md`、
`firmware/reports/bpsk_bits_hold_20261027_102339/`。

**原先写的「实机帧 EVM 0.060 / 状态待判决」来自更早一次未获符号同步的运行**
（对应仓库截图 `11-mod-bpsk.png`）。那张图作为「未同步时不给假星座」的证据仍然成立，
但它不是 BPSK 的最终状态。

仍未闭环的部分，照实保留：BPSK 历史 3 次擦除定位在参考训练之前／期间，后续多段
同读者记录未复现，根因未查清；180° 极性歧义需外部参考；这些都不是通用 BER。

### 3　图片页：屏上走完了，独立核验没做

- `image_rf_ook_20261027_164947/window_result.json`：
  `screen_completed: true`、**`physical_image_accepted: false`**、
  `requires_independent_capture_audit: true`
- 2026-10-29 补测（32×32 OOK、4 包、progress 100、设置已恢复）在 `acceptance.md` 里
  自己写明：只证明发送端与 VISA 控制的互斥隔离，**不代表屏端收到图或 CRC 通过**
- 已通过的是：OOK/2FSK/BPSK 合成回环 + ADB 逐像素显示

所以「真实载波下整图独立验收」仍然缺位。

### 4　七页绘制帧率：探针在，数据没有

`src/main.c:340` 起有 `--fps [SEC]`：先按正常节奏跑，再强制每轮重绘，分别报
「实际运行帧率」与「渲染上限」，并把单帧拆成软件渲染 / DRM 翻页两段。
现成的 9.9 FPS 是六页版本（1024 点折线 × 2 通道）的数据，七页版本没测过。

跑一次即可闭环，但需要板子在线：

```bash
./waveform_demo --source uart --view system --fps 15
```

### 5　本次重建产物上板

`docs/build-verify-20261102.md` 里那次干净重建，只做到「构建侧可复现」：
资源 20294 LUT / 13111 FF / 80 DSP / 36 BRAM、WNS +0.172 ns / WHS +0.010 ns、
DRC 138 条全 Warning 无 Error，与历史逐项一致。bit 生成了（2,192,115 B，
SHA256 `0a64f12e…`），但**没有下载到板子上跑过功能**。

另需注意：bit 头里 Vivado 写入了构建时间
（`daq_top;UserID=0XFFFFFFFF;Version=2018.3 7a35tfgg484 2026/11/02 17:29:09`），
逐字节复现历史 bit 不可能，判据应落在 USR_ACCESS + 时序资源 + DRC + 上板。

### 6　正式工具链重编

全盘检索 `gcc-arm-10.3` / `arm-none-linux-gnueabihf-10.3` / `10.3-2021.07`：
没有工具链目录，也没有任何构建记录。本次重建用的是 SDK 自带 ARM GCC 7.3.1，
产物 ABI 正确（`ELF32 / ARM / v7-A / VFPv4 / Tag_ABI_VFP_args: VFP registers`，
链接 2,258,844 B），但编译器不是发布用的那一个。

### 7　实物照片

技术文档与海报里仍是占位。已做好可打印的 A4 实物图版模板
（`poster/V32-photo-sheet-A4.html`，本地，未进仓库）：三个片位 + 拍摄要求，
照片按 `photo_1/2/3.jpg` 放进 `poster/figs/` 重跑渲染即自动填入。

### 8　字体

界面中文字形是 SimHei 的子集、符号来自 Segoe UI Symbol，两者都是随 Windows
提供的商业字体。公开仓库长期分发前应换思源黑体重新生成；
替换路径与现状见 [LICENSING.md](../LICENSING.md)。

## 三、一句话小结

BPSK 的实机资格记录**已经存在**（10-27，5747 bit / 5460 次检查零错 / 24.2463 s 合格片段），
不应再写成「待判决」；QPSK 只在主机侧闭环过，屏端仍缺；其余 6 项确实没做。
