Creamy-coffee/dual-channel-modulation-analyzer/fpga/common_tests/tb_afc_controller.sv

`timescale 1ns/1ps
`default_nettype none
// =============================================================================
// tb_afc_controller.sv — Stage 1 AFC simulation framework.
// Six scenarios (user-specified) + a bonus stream-break check:
//   1. frequency step (1199 Hz -> 0)      : expect capture -> lock -> stable
//   2. slow drift (1199 Hz -> 0)          : expect tracking, stays stable
//   3. weak signal from start             : expect UNLOCK + revoke, no lock
//   4. single-channel disconnect (mid-run): expect lock first, then revoke
//   5. wrong component (20 kHz, > capture): expect NO false lock, limit_flag set
//   6. pure noise                         : expect NO stable lock
//   7. (bonus) stream break (adc_valid=0) : expect immediate UNLOCK + revoke
//
// The observation phasor is MODELLED here (a rotating baseband residual at the
// residual Δf). A real short-window observer module is a later step; it must
// produce one phasor per obs_valid with this same interface.
//
// A behavioral NCO mirror confirms the key property: afc_commit changes fcw
// WITHOUT resetting the NCO phase (which lockin_core_2ch now guarantees).
// =============================================================================
module tb_afc_controller;

    localparam real    FS_HZ      = 65000000.0;
    localparam real    T_OBS_S    = 64e-6;
    localparam integer T_OBS_CYC  = 4160;          // FS_HZ * T_OBS_S
    localparam integer OBS_W      = 24;
    localparam integer STRONG     = 100000;        // phasor amplitude (counts*2^12-ish)
    localparam [31:0]  NOMINAL_FCW= 32'd1982292598;// 30 MHz

    // ---- self-consistent frequency model -------------------------------------
    // The observation phasor must rotate at the RESIDUAL between the true input
    // frequency and what the NCO mirror currently generates. Deriving the carrier
    // reference straight from NOMINAL_FCW avoids any systematic offset between the
    // model and the DUT that would otherwise show up as a fake steady-state error.
    localparam real FS_R     = 65000000.0;
    localparam real FCW2HZ_R = FS_R / 4294967296.0;   // Hz per FCW LSB
    localparam real REF_HZ_R = 1982292598.0 * FCW2HZ_R;

    real resid_r;   // (true input) - (NCO mirror), in Hz
    real resid2_r;
    real phi_res2;
    always @* resid_r = (REF_HZ_R + $itor(df_hz)) - ($itor(nco_fcw) * FCW2HZ_R);

    // Second (non-tracked) channel: may carry an extra offset to model two inputs
    // that are NOT at the same frequency (df2_extra_hz != 0).
    always @* resid2_r = (REF_HZ_R + $itor(df_hz) + $itor(df2_extra_hz))
                         - ($itor(nco_fcw) * FCW2HZ_R);

    reg clk, rst_n, adc_valid;
    // modelled observation
    reg signed [OBS_W-1:0] obs_i, obs_q;
    reg                  obs_valid;
    reg [23:0]           obs_amp;
    reg signed [OBS_W-1:0] obs2_i, obs2_q;
    reg                  obs2_valid;
    reg [23:0]           obs2_amp;
    reg signed [31:0]    df2_extra_hz;
    reg [31:0]           win_len;       // ACTUAL observation interval this window, cycles
    reg [31:0]           win_len_nxt;   // requested interval, applied at window boundaries
    reg [31:0]           ts_counter;    // free-running index stamped at each observation
    // AFC outputs
    wire [31:0] afc_fcw;
    wire        afc_commit;
    wire [1:0]  afc_state;
    wire        afc_locked, afc_stable, revoke, limit_flag;
    wire        afc_settling, afc_valid, dual_freq_flag, dt_anomaly;
    wire [31:0] drop_count, diag_dt, diag_fcw;
    wire        diag_valid;
    wire signed [OBS_W-1:0] diag_i, diag_q;
    wire signed [15:0] diag_phase;
    wire [23:0] diag_amp;
    wire [31:0] diag_timestamp, diag_frame;

    // ---- stimulus control ----
    reg signed [31:0] df_hz;
    reg               amp_on, noise_on;
    reg [3:0]         scenario;
    reg [3:0]         scenario_prev;
    reg [31:0]        gwin;     // global window counter
    reg [31:0]        scen_start; // gwin at the start of the current scenario
    reg [3:0]         nxt;     // desired next scenario (combinational via nxt<=)
    // subwin is derived from the monotonic gwin and the per-scenario baseline,
    // so it never carries the previous scenario's count into the next one.
    wire [31:0]        subwin = gwin - scen_start;
    reg [31:0]        cyc;      // clock counter within a window
    real               phi_res;

    // ---- captured absolute locked FCW at each SCEN1 plateau (positive / negative / zero) ----
    reg [31:0]         cap_pos, cap_neg, cap_zero;
    real               cap_pos_hz, cap_neg_hz, cap_zero_hz;
    // expected = 1199 Hz * (2^32/65e6) = 1199 * 66.076420 = 79 226 FCW (see doc sec.3.0)
    localparam integer EXP_1199_FCW = 79226;
    localparam integer FCV_TOL_FCW  = 300;      // +-300 FCW = +-4.5 Hz
    // signed errors are evaluated combinationally so the $display in the same
    // cycle as the capture sees the new values
    wire signed [32:0] cap_e_pos  = $signed(cap_pos)  - $signed(NOMINAL_FCW) - EXP_1199_FCW;
    wire signed [32:0] cap_e_neg  = $signed(cap_neg)  - $signed(NOMINAL_FCW) + EXP_1199_FCW;
    wire signed [32:0] cap_e_zero = $signed(cap_zero) - $signed(NOMINAL_FCW);
    wire ok_pos  = (cap_e_pos  > -FCV_TOL_FCW) && (cap_e_pos  < FCV_TOL_FCW);
    wire signed [32:0] cap_e_8 = $signed(cap8_fcw) - $signed(NOMINAL_FCW) - EXP_1199_FCW;
    wire signed [32:0] cap_e_9 = $signed(cap9_fcw) - $signed(NOMINAL_FCW) - EXP_1199_FCW;
    wire ok8 = (cap_e_8 > -FCV_TOL_FCW) && (cap_e_8 < FCV_TOL_FCW);
    wire ok9 = (cap_e_9 > -FCV_TOL_FCW) && (cap_e_9 < FCV_TOL_FCW);
    wire ok_neg  = (cap_e_neg  > -FCV_TOL_FCW) && (cap_e_neg  < FCV_TOL_FCW);
    wire ok_zero = (cap_e_zero > -FCV_TOL_FCW) && (cap_e_zero < FCV_TOL_FCW);

    // ---- NCO mirror (behavioural) to verify phase continuity ----
    reg [63:0] nco_phase;
    reg [31:0] nco_fcw;
    reg        cfg_commit_mirror;
    reg        cont_bad;

    // ---- per-scenario PASS flags ----
    reg s1_pass, s2_pass, s3_pass, s4_pass, s4_ever_locked, s5_pass, s6_pass, s7_pass;
    reg s8_pass, s9_pass, s10_pass;
    reg        drop_armed;
    reg [31:0] dc_before, dc_after, dc_at8;
    reg [31:0] cap8_fcw, cap9_fcw;
    reg        s10_saw_flag, s9_saw_anom;
    reg        s1_ok_neg, s1_ok_pos, s1_ok_zero;
    reg        s7_saw_revoke, s7_released;

    // ===================== clock =====================
    always #7.692 clk = ~clk;   // ~65 MHz

    // ===================== AFC DUT =====================
    afc_controller #(.FS_HZ(65000000), .T_OBS_S(64e-6), .OBS_W(24),
                     .CAPTURE_RANGE_FCW(500000), .SMOOTH_SHIFT(3),
                     .COMMIT_INT(4), .MIN_OBS_AMP(2048),
                     .STABLE_WIN(32), .HOLD_WIN(16), .SETTLE_WIN(8)) u_afc (
        .clk(clk), .rst_n(rst_n), .adc_valid(adc_valid),
        .obs_i(obs_i), .obs_q(obs_q), .obs_valid(obs_valid), .obs_amp(obs_amp),
        .obs_timestamp(ts_counter),
        .obs2_i(obs2_i), .obs2_q(obs2_q), .obs2_valid(obs2_valid), .obs2_amp(obs2_amp),
        .nominal_fcw(NOMINAL_FCW),
        .afc_fcw(afc_fcw), .afc_commit(afc_commit), .afc_state(afc_state),
        .afc_locked(afc_locked), .afc_stable(afc_stable),
        .revoke_measurement(revoke), .limit_flag(limit_flag),
        .afc_settling(afc_settling), .afc_valid(afc_valid),
        .dual_freq_flag(dual_freq_flag), .dt_anomaly(dt_anomaly),
        .drop_count(drop_count), .diag_dt(diag_dt), .diag_fcw(diag_fcw),
        .diag_valid(diag_valid), .diag_i(diag_i), .diag_q(diag_q),
        .diag_phase(diag_phase), .diag_amp(diag_amp),
        .diag_timestamp(diag_timestamp), .diag_frame(diag_frame)
    );

    // ===================== timestamp counter =====================
    // The AFC is fed a REAL cycle index stamped at each observation; nothing assumes
    // consecutive observations are exactly T_OBS apart.
    always @(posedge clk) begin
        if(!rst_n) ts_counter<=0;
        else ts_counter<=ts_counter+1'b1;
    end

    // ===================== NCO mirror =====================
    always @(posedge clk) begin
        if(!rst_n) begin
            nco_phase<=0; nco_fcw<=0; cfg_commit_mirror<=0; cont_bad<=0;
        end else begin
            if(cfg_commit_mirror) begin
                nco_phase<=0; nco_fcw<=NOMINAL_FCW;   // mimics lockin_core cfg_commit
            end else if(afc_commit) begin
                nco_fcw<=afc_fcw;                      // ONLY fcw changes
            end
            nco_phase<=nco_phase + nco_fcw;
            // continuity check: phase must never reset outside a cfg_commit
            if(scenario>=2 && !cfg_commit_mirror && nco_phase < 64'd100)
                cont_bad<=1;
        end
    end

    // ===================== scenario sequencer =====================
    // Each scenario's window count (subwin) is derived from the monotonic
    // global counter gwin minus a per-scenario baseline (scen_start) that is
    // (re)set whenever the scenario changes. This avoids the old reg-based
    // subwin reset, which lagged one cycle and let a new scenario inherit the
    // previous scenario's accumulated count (e.g. scenario 3 saw subwin=220 and
    // exited immediately, so its weak-signal path was never exercised).
    always @(posedge clk) begin
        if(!rst_n) begin
            scenario<=1; scenario_prev<=0; scen_start<=0; df_hz<=0;
            amp_on<=1; noise_on<=0; cfg_commit_mirror<=0; df2_extra_hz<=0;
            win_len<=T_OBS_CYC;
        end else begin
            scenario_prev<=scenario;
            cfg_commit_mirror <= (gwin==4);   // one-shot initial config commit (mirror)
            // Default: regular observations every T_OBS. Scenarios 8/9 override this to
            // prove the estimator uses the MEASURED interval, not an assumed one.
            // NOTE: applied at window boundaries only (see generator) -- changing the
            // interval mid-window would strand the cyc counter and stall the stimulus.
            win_len_nxt <= T_OBS_CYC;
            df2_extra_hz<= 0;

            nxt <= scenario;                  // default: stay
            case(scenario)
            1: begin   // SCEN1: three plateaus - POSITIVE offset, NEGATIVE offset, zero.
                        // The point is to check the ABSOLUTE locked FCW, not just the
                        // residual: with the input 1199 Hz ABOVE 30 MHz the loop must
                        // settle at nominal + 79 226 FCW (1199 Hz * 66.076420), and at
                        // nominal - 79 226 FCW when it is below. Each plateau needs
                        // ~40 windows of geometric settling plus STABLE_WIN=32.
                amp_on<=1; noise_on<=0;
                df_hz <= (subwin<200) ?  32'sd1199
                       : (subwin<400) ? -32'sd1199
                       :                32'sd0;
                if(subwin>=580) nxt<=3'd2;
            end
            2: begin   // SCEN2: slow drift 1199 -> 0 over 200 windows, then a
                        // long stable tail so STABLE_WIN (32) can be satisfied
                amp_on<=1; noise_on<=0;
                df_hz <= (subwin<200) ? (32'sd1199 - (subwin*32'sd1199)/200) : 32'sd0;
                if(subwin>=300) nxt<=3'd3;
            end
            3: begin   // SCEN3: weak from start
                amp_on<=0; noise_on<=0; df_hz<=32'sd1199;
                if(subwin>=60) nxt<=3'd4;
            end
            4: begin   // SCEN4: strong then single-channel disconnect.
                        // Budget note: this scenario STARTS in AF_UNLOCK (left there
                        // by scenario 3), so it must first re-acquire: HOLD_WIN=16
                        // good windows to leave UNLOCK, then pull in 1199 Hz and hold
                        // STABLE_WIN=32 quiet windows. That needs far more than 100
                        // windows -- see the sizing comment in scenario 1.
                noise_on<=0; df_hz<=32'sd1199;
                amp_on <= (subwin<200);   // strong for 200 wins, then channel drops
                if(subwin>=280) nxt<=3'd5;
            end
            5: begin   // SCEN5: component that cannot be pulled in.
                        // A phase-difference estimator over T_OBS=64us is only
                        // unambiguous for |residual| < 1/(2*T_OBS) = 7812 Hz.
                        // 23400 Hz aliases into that window as 23400-15625 = 7775 Hz,
                        // which is BEYOND the +-7568 Hz capture clamp, so the loop's
                        // correction demand saturates -> limit_flag and no lock.
                        // NOTE (stage-1 limitation, documented): a component whose
                        // ALIAS lands *inside* the clamp cannot be distinguished from
                        // the true frequency from one phasor per window alone, so it
                        // could false-lock. Fix belongs to a shorter capture window
                        // (wider unambiguous range), not to post-processing.
                amp_on<=1; noise_on<=0; df_hz<=32'sd23400;
                if(subwin>=200) nxt<=3'd6;
            end
            6: begin   // SCEN6: pure noise
                amp_on<=1; noise_on<=1; df_hz<=32'sd1199;
                if(subwin>=200) nxt<=3'd7;
            end
            7: begin   // SCEN7: stream break (adc_valid=0), then recovery.
                        // The break MUST be released again: the later scenarios continue
                        // from here, and leaving adc_valid stuck low would park the AFC
                        // in AF_UNLOCK forever (this scenario used to be the last one).
                amp_on<=1; noise_on<=0; df_hz<=32'sd0;
                if(subwin==10) adc_valid<=0;
                if(subwin==40) adc_valid<=1;   // break cleared -> must re-lock
                if(subwin>=140) nxt<=4'd8;
            end
            8: begin   // SCEN8: IRREGULAR but in-band observation intervals.
                        // Every fourth window is dropped (2x interval) and every
                        // seventh arrives early (0.5x). All stay inside the accepted
                        // band, so this must still lock at nom+79226 -- which is only
                        // possible if the residual really is scaled by the MEASURED dt.
                        // Assuming a fixed T_OBS here gives a 2x/0.5x wrong estimate.
                amp_on<=1; noise_on<=0; df_hz<=32'sd1199;
                if(subwin[1:0]==2'b11)     win_len_nxt<=T_OBS_CYC*2;   // one window dropped
                else if(subwin%7==6)       win_len_nxt<=T_OBS_CYC/2;   // early arrival
                if(subwin>=240) nxt<=4'd9;
            end
            9: begin   // SCEN9: STALL. One observation is delayed past the accepted band.
                        // This is a real gap: the delta across it is meaningless and must
                        // be rejected (dt_anomaly + drop_count) rather than turned into a
                        // huge bogus slope that would wreck the integrator.
                amp_on<=1; noise_on<=0; df_hz<=32'sd1199;
                drop_armed <= 1;
                if(subwin==120) win_len_nxt<=T_OBS_CYC*10;   // 10x > DT_HI (4x) => rejected
                if(subwin>=260) nxt<=4'd10;
            end
            10: begin  // SCEN10: DUAL CHANNEL, DIFFERENT FREQUENCY.
                        // The shared NCO tracks channel A only. Channel B is offset by
                        // 500 Hz, so their phase difference rotates and any "same-frequency
                        // inter-channel phase" product would be nonsense. dual_freq_flag
                        // must assert while they differ and clear once they agree.
                amp_on<=1; noise_on<=0; df_hz<=32'sd1199;
                df2_extra_hz <= (subwin>=80 && subwin<220) ? 32'sd500 : 32'sd0;
                if(subwin>=300) begin drop_armed<=0; nxt<=4'd0; end
            end
            default: nxt<=3'd0;
            endcase

            if(nxt!=scenario) begin
                scenario<=nxt;
                scen_start<=gwin;            // reset window count for new scenario
            end
        end
    end

    // ===================== window / observation generator =====================
    always @(posedge clk) begin
            if(!rst_n) begin
                cyc<=0; obs_valid<=0; gwin<=0; phi_res<=0; phi_res2<=0;
                obs_i<=0; obs_q<=0; obs_amp<=0; adc_valid<=1;
                obs2_i<=0; obs2_q<=0; obs2_valid<=0; obs2_amp<=0;
                win_len<=T_OBS_CYC; win_len_nxt<=T_OBS_CYC; ts_counter<=0;
            end else begin
                obs_valid<=0; obs2_valid<=0;
                if(cyc==win_len-1) begin
                    cyc<=0; win_len<=win_len_nxt;   // interval changes only at boundaries
                    if(noise_on) begin
                        obs_i <= $rtoi(STRONG * ($sin(phi_res)));   // random-ish via phi
                        obs_q <= $rtoi(STRONG * ($cos(phi_res*1.3)));
                        phi_res <= phi_res + 0.137;                // no coherent rotation
                    end else begin
                        // CLOSED-LOOP plant: phase advances at the residual rate over the
                        // REAL interval elapsed since the previous observation, so the
                        // loop really does null its own error. Phase wraps naturally in
                        // the CORDIC (|df| <= 1/(2*T_OBS) unambiguous range).
                        // this observation. Elapsed time is win_len/FS, NOT a fixed
                        // T_OBS -- that is the whole point of the timestamp rule.
                        phi_res  <= phi_res  + 2.0*3.141592653589793*resid_r *($itor(win_len)/FS_R);
                        phi_res2 <= phi_res2 + 2.0*3.141592653589793*resid2_r*($itor(win_len)/FS_R);
                        obs_i <= $rtoi(STRONG * $cos(phi_res));
                        obs_q <= $rtoi(STRONG * $sin(phi_res));
                        obs2_i<= $rtoi(STRONG * $cos(phi_res2));
                        obs2_q<= $rtoi(STRONG * $sin(phi_res2));
                    end
                    obs_amp  <= amp_on ? STRONG : 24'd0;
                    obs2_amp <= amp_on ? STRONG : 24'd0;
                    obs_valid<=1; obs2_valid<=1; gwin<=gwin+1'b1;
                // ---- absolute locked-FCW capture at each SCEN1 plateau end ----
                if(scenario==1) begin
                    if(subwin==190) begin cap_pos  <= afc_fcw; cap_pos_hz  <= resid_r; end
                    if(subwin==390) begin cap_neg  <= afc_fcw; cap_neg_hz  <= resid_r; end
                    if(subwin==570) begin cap_zero <= afc_fcw; cap_zero_hz <= resid_r; end
                end
            end else cyc<=cyc+1'b1;
        end
    end
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
