Creamy-coffee/dual-channel-modulation-analyzer/(commit log)

2026-11-01 chore: 同步最终 FPGA 源码到 main，新增 MIT LICENSE 与团队署名
    - 将 fpga/ 目录（RTL、测试平台、仿真脚本）从备份分支合入 main，使默认分支即最终版
    - 新增 LICENSE（MIT），满足 AMD 自主选题开源要求
    - README 增加两人团队署名区块，修正第 12 节'私有仓库'为公开仓库说明
    [ab5_frame_sequencer.v, ab5_uart_commands.v, acq_trigger_buffer.v, ad9238_capture.v, afc_controller.v, afc_observer.v, afc_precision_ctrl.v]
2026-11-01 chore: 移除 xsim 仿真编译缓存，忽略 Xilinx 生成物
    - 删除 3 个 xsim.dir（xsim.mem/webtalk/Compile_Options.txt 等可再生成物）
    - .gitignore 增加 xsim.dir/、webtalk/、*.dcp/*.bit/*.ltx 等 Xilinx 生成物规则
    - 保留所有设计系数 .mem、build_evidence、SHA256SUMS.json 等交付内容
2026-11-02 docs: 作品名统一为双通道信号采集与调制分析仪，截图换成最终版七页画面
    - README 标题与首屏按最终版本重写：七页导航、2 Mbaud 串口、4096 点共享 FFT + 屏端三窗
    - 贡献者表去掉队长/队员标注，保留两人分工
    - docs/screenshots 全部替换为最终版本屏端截图（示波器/频谱三窗/谐波/锁相/调制四模式），
    旧版五页浅色界面截图删除
    - 许可证表述与 LICENSE 对齐为 GPL-3.0-only
2026-11-02 tools: board_shot 导航坐标改到七页（示波器/频谱/锁相/重建/调制/系统/图片）
2026-11-02 docs: 修正正文与最终版本不符的页面数与配色描述（七页、深色仪器风）
2026-11-02 docs: 首屏新增「FPGA 侧」章节，突出自研 FFT 核、全频段单 bitstream 与资源时序
2026-11-02 docs: 按评审意见重写首页，修正过时限制与过满表述
    P0 事实修正：
    - 删除「接收端只接受 dec=1 / 一屏最多 63 µs」的过时限制，改为当前抽取机制
    （接收端支持 1…32768 的 2 的幂），最大时间窗按 点数×dec÷65 MSPS 计算，
    并区分「接收端支持」与「板上验证过」
    - 明确三窗归属：FPGA SPEC 帧固定 Hann，Hann/Blackman/FlatTop 只作用于屏端 RAW 1024 点谱
    - 区分采样率 / 有效采样率 / 接收帧率 / 绘制帧率，不再混用 5.6、9.9、24 等数字
    - 数字调制改为「显示 / 判决 / 实机验证」三列，QPSK 与 BPSK 待判决如实标注
    - 重建表述去掉「造假」「额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
2026-11-02 docs: 明确 65 MSPS 是 ADC 采样率，串口按帧传输（帧长与类型列清楚）
2026-11-02 feat(ui): 屏端源码对齐七页发布版本（来自 fpga-modulation-ui-20261026 / 76f7aff）
    main 的 src/ 此前停留在 2026-10-26 的六页版本，与 README、13 张实屏截图、
    技术文档 v1.3 描述的七页程序不一致。本次把屏端内容整体对齐到发布版本：
    - src/：新增 UI_PAGE_IMAGE（图片页）与调制页配套实现
    bpsk_decoder.c（Hann 窗 M 次方 FFT 估粗 CFO → msresamp 4Rs → symtrack
    AGC/定时/载波/均衡 → 判决，可选 PN7 参考检查）
    ook_decoder.h（10/90 分位学电平、40/60% 滞回、符号中心积分、? 不确定）
    harmonic_receiver.c、image_transport.h（V32IMG1! 曼彻斯特 + 分包/整图 CRC）
    - th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
2026-11-02 docs(license): 补第三方组件清单，如实披露字体子集的商业字体来源
    评审清单 P2「完善开源说明」：
    - 列出 LVGL(MIT) / liquid-dsp 1.7.0(MIT) / 三套字体子集的许可证、分发方式与用途
    - 说明界面字体由 gen_v32_fonts.py 从 SimHei、DejaVuSans、Segoe UI Symbol 抽位图子集，
    其中 SimHei 与 Segoe UI Symbol 是随 Windows 提供的商业字体，位图子集再分发存在授权争议
    - 给出替换路径（思源黑体 SIL OFL 重跑脚本）并标注本版本尚未执行
    - 补代码来源边界：RTL/C 自研、liquid-dsp 未改算法、不含厂商 SDK 与许可证文件
    README 待完成列表同步加一条字体替换项。
2026-11-02 docs: 补屏端干净环境重建验收记录，修好编译不过的 test_fft
    在仓库外的独立副本上重建屏端（LVGL 9.1.0 + liquid-dsp 1.7.0 + ARM GCC 7.3.1）：
    - LVGL 284 个源文件、应用 21 个源文件全部编译通过
    - 链接产物 2,258,844 B，ELF32 / ARM / v7-A / VFPv4 / hard-float（readelf 核对）
    - 5 个命令行工具同样构建成功
    - 同一份源码在主机上跑自测：test_bpsk_decoder / test_ook_decoder /
    test_fsk_decoder / test_fft_windows / test_fft 全部 PASS
    结果、命令、与正式工具链的差异都写在 docs/build-verify-20261102.md。
    顺带修好两个已知但未记录的问题：
    - tools/test_fft.c 仍引用已改名的 WAVE_FR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
2026-11-02 docs: FPGA 干净重建验收结果——时序/资源/DRC 与历史逐项一致
    在仓库外独立副本上用 Vivado 2018.3 从零跑 fpga/build.tcl 到 write_bitstream：
    - 实现后 WNS +0.172 ns / WHS +0.010 ns，0 个失败端点（与 build_evidence 相同）
    - 20294 LUT / 13111 FF / 80 DSP / 36 BRAM（与 build_evidence 相同）
    - DRC 138 条全为 Warning、无 Error，6 条规则的条数也完全相同
    - bit 2,192,115 B；SHA256 0a64f12e… 与历史 76afefdb… 不同
    不可逐字节复现的原因写在 bit 头里：Vivado 会写入构建时间
    （daq_top;UserID=0XFFFFFFFF;Version=2018.3 7a35tfgg484 2026/11/02 17:29:09），
    因此一致性判据应为 USR_ACCESS + 时序/资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
2026-11-02 docs: 待完成项逐条核对——BPSK 实机资格已完成，QPSK 仅主机侧闭环
    对照内部证据树（firmware/reports/，174 个报告目录，截至 2026-10-31）与
    LLM 辅助优化记录 #1–#84，把 README「待完成」的 8 条逐条查到原始数据：
    - BPSK 实机资格记录已完成（2026-10-27）：372 帧 CRC 全对、fid 连续、
    5747 bit、训练后 5460 次检查 0 错、GUI 24.2463 s 合格片段末次 24702 次
    检查零错零擦除、EVM 0.0260–0.0481。原「EVM 0.060 / 待判决」是更早一次
    未获符号同步的运行，两者不能混。
    - QPSK 改为部分完成：主机侧历史闭环（2917 帧、62712 个留出符号 0 错、
    EVM 0.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
2026-11-02 fix: 公开仓库清除写死的口令、个人路径与内网地址
    仓库是公开的，以下内容不该随代码一起发布：
    - deploy_net.sh / push_build.sh / tools/board_shot.py 里的板子与构建机
    口令、账号、地址默认值：改为只从环境变量读（BOARD_*、BUILD_*），
    未设置时 :? 直接报错退出，不会用空口令或 root/root 去连。
    - toolchain.cmake 里写死的 SDK 家目录：改为 SDK_TOOLCHAIN_ROOT 环境变量
    或 cmake -DTC_ROOT=，缺值时给出可操作的报错。
    - tools/gen_v32_fonts.py、tools/test_sender_html.py、tools/adb_shot.sh 里
    指向个人机器的 node/python 绝对路径与微信参考稿路径：改为从 PATH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
2026-11-03 修改REDME
2026-11-03 docs: 收敛 README 表述
    - 开篇改成两句话说明板卡构成，去掉三段式"三个重点"与自报式总结
    - 去掉强调性加粗与表格装饰图标，小标题改用三级标题
    - FPGA 段不再写"RTL 全部自研 / 不调用 Xilinx FFT IP"，改为说明
    FFT/DDC/锁相/谐波为本仓库 RTL 实现、未例化厂商 FFT IP，并交代
    MMCM/BUFG 原语（与后文"预生成旋转因子表"不再矛盾）
    - 删除"待完成"进度清单；图片页补一句验收口径，避免变成无条件宣称
    - 已知边界与技术数据保持原样
2026-11-04 docs: 收录 LLM 辅助优化记录（2026-10-19 ～ 10-31 阶段）
    - 新增 docs/llm-assisted-optimization-log.md（原 D:/下载/LLM辅助优化记录.md）
    - 脱敏：Codex 会话产出路径 →「私有记录：<文件名>」；
    D:/FPGA_bag/... 证据路径 →「私有证据：<相对路径>」；不留任何盘符路径
    - 开头补文档性质说明：本文写的是 8192 点 XFFT / AI_V32 / 低速 CNN 那条历史分支，
    与当前发布版本（七页屏端 + 4096 点共享 FFT）不是同一条实现线，不作为当前能力声明
    - 文内旧仓库链接更新为新名 dual-channel-modulation-analyzer
